pete4radio/SAMWISE-1-1-HW-Training/README.md

# SAMWISE-1-1-HW-Training
PCBs fabbed in May 2024 for SAMWISE
