pete4radio/SAMWISE-1-1-HW-Training/batteryboard-v02b/.svg2shenzhen-cache/images/F.SilkS_g35.png

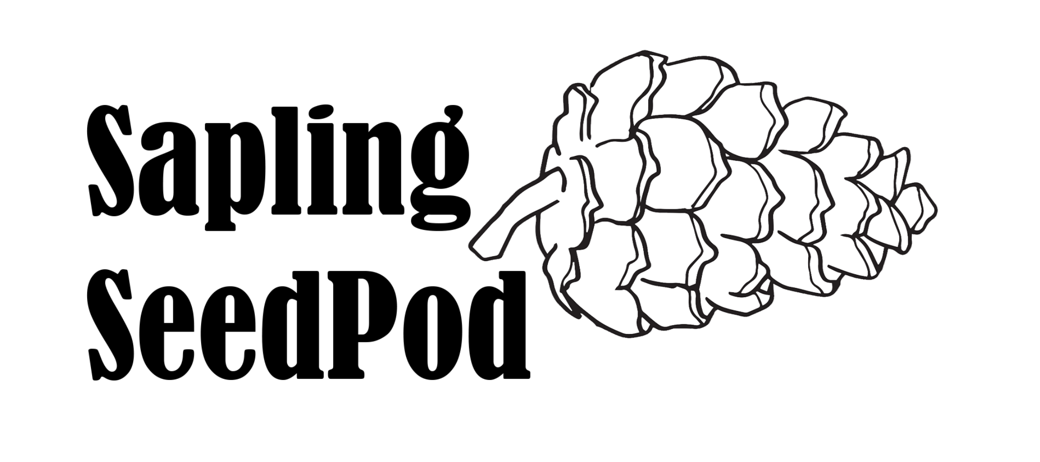
batteryboard-v02b/.svg2shenzhen-cache/images/F.SilkS_g35.png
