pete4radio/SAMWISE-1-1-HW-Training/mainboard-v06b_samwise/stackup/stackup_outer_rf.png

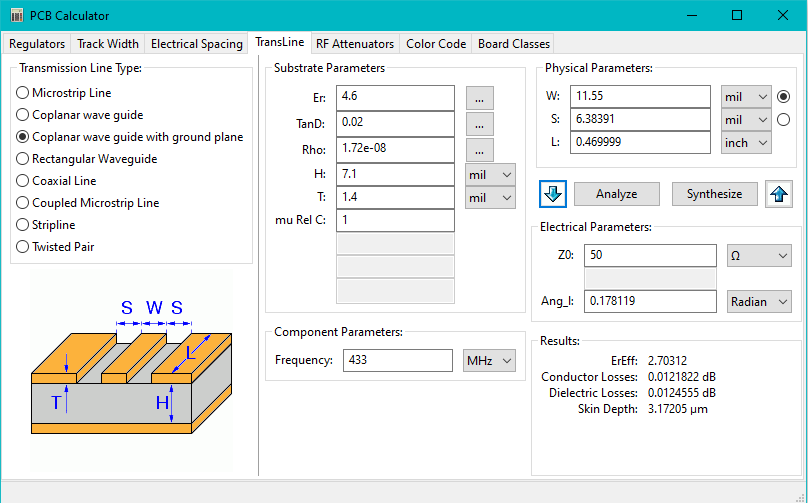
mainboard-v06b_samwise/stackup/stackup_outer_rf.png
