pete4radio/SAMWISE-1-1-HW-Training/LT8490-mezzanine/LT8490.xlsx

Refs | DNI | Datasheet | Description | Footprint | Height | Manufacturer_Name | Manufacturer_Part_Number | Mouser Part Number | Mouser Price/Stock | PN | Value | Voltage | Power | digikey part number | footprint url | height | lead free | library id | manufacturer | max junction temp | max supply voltage | min supply voltage | mouser description | mouser part number | nominal supply current | number of cells | number of outputs | package | rohs | standoff height | temperature range high | temperature range low
C15, C40 |  | ~ | 100nF 0603 | Capacitor_SMD:C_0603_1608Metric |  |  |  |  |  |  | 100nF
C16 |  | ~ |  | Capacitor_Tantalum_SMD:CP_EIA-7343-30_AVX-N |  |  | TCQD336M016R0070E |  | 581-TCQD336M016R70E | TCQD336M016R0070E | 33uF | 16V
C17 |  | ~ | 2.2uF 0603 | Capacitor_SMD:C_0603_1608Metric |  |  |  |  |  |  | 2.2uF | 10V |  | 1276-1134-1-ND
C18, C22, C25 |  | ~ | 2.2uF 0805 | Capacitor_SMD:C_0805_2012Metric |  |  |  |  |  |  | 2.2uF | 16V |  | 445-5691-1-ND
C19, C34, C39 |  | ~ | 1uF 0603 | Capacitor_SMD:C_0603_1608Metric |  |  |  |  |  |  | 1uF | 25V |  | 587-2984-1-ND
C20, C37 | DNI | ~ | 100nF 0603 | Capacitor_SMD:C_0603_1608Metric |  |  |  |  |  |  | 100nF
C21, C24, C38 |  | ~ | 4.7uF 0603 | Capacitor_SMD:C_0603_1608Metric |  |  |  |  |  |  | 4.7uF | 16V |  | 1276-1784-1-ND
C23 |  | ~ | 10nF 0603 | Capacitor_SMD:C_0603_1608Metric |  |  |  |  |  |  | 10nF | 50V |  | 445-1311-1-ND
C26, C35 |  | ~ | 470nF 0603 | Capacitor_SMD:C_0603_1608Metric |  |  |  |  |  |  | 470nF | 25V |  | 587-2670-1-ND
C27 |  | ~ | 220pF 0603 | Capacitor_SMD:C_0603_1608Metric |  |  |  |  |  |  | 220pF | 50V |  | 478-06035C221K4T2ACT-ND
C28 |  | ~ | 6.8nF 0603 | Capacitor_SMD:C_0603_1608Metric |  |  |  |  |  |  | 6.8nF | 50V |  | 1292-1459-1-ND
C29, C33 |  | ~ | 220nF 0603 | Capacitor_SMD:C_0603_1608Metric |  |  |  |  |  |  | 220nF | 25V |  | 587-1246-1-ND
C30 |  | ~ | 68nF 0603 | Capacitor_SMD:C_0603_1608Metric |  |  |  |  |  |  | 68nF | 50V |  | 1276-6541-1-ND
C31, C32 |  | ~ | 3.3nF 0603 | Capacitor_SMD:C_0603_1608Metric |  |  |  |  |  |  | 3.3nF | 50V |  | 1276-1758-1-ND
C36, C41 |  | ~ | 10uF 0805 | Capacitor_SMD:C_0805_2012Metric |  |  |  |  |  |  | 10uF | 10V |  | 587-5915-1-ND
C42 |  | ~ |  | Capacitor_Tantalum_SMD:CP_EIA-7343-30_AVX-N |  |  | TCQD476M016R0070E |  | 581-TCQD336M016R70E | TCQD336M016R0070E | 47uF | 16V
C43 |  | ~ | 1nF 0603 | Capacitor_SMD:C_0603_1608Metric |  |  |  |  |  |  | 1nF | 50V |  | 1276-1091-1-ND
D1, D2 | DNI | ~ |  | Diode_SMD:D_SOD-123F |  |  |  |  |  |  | MBR1020VL
D12, D13 |  | ~ |  | Diode_SMD:D_SOD-123F |  |  |  |  |  |  | CMMR1U-02 TR |  |  | 1514-CMMR1U-02TRPBFREECT-ND
J1-J25 | DNI | ~ |  | custom-footprints:castellated_05mm |  |  |  |  |  |  | Conn_01x01
L3 |  | ~ | 3.3uH 1770 | custom-footprints:L_SRP1770C |  |  |  |  |  |  | 3.3uH |  |  | SRP1770C-3R3MCT-ND
NT1-NT7 | DNI | ~ |  | NetTie:NetTie-2_SMD_Pad0.5mm |  |  |  |  |  |  | NetTie_2
Q1-Q4 |  |  |  | custom-footprints:SIS862DNT1GE3 |  |  | Si7106DN |  |  | 781-SI7106DN-T1-GE3 | Si7106DN
Q5 | DNI | https://www.diodes.com/assets/Datasheets/BSS138DWQ.pdf |  | custom-footprints:BSS138DWQ-7 |  | Diodes Inc. |  |  |  |  | BSS84
Q6 | DNI | http://www.onsemi.com/pub_link/Collateral/MBT2222ADW1T1-D.PDF |  | Package_TO_SOT_SMD:SOT-363_SC-70-6 |  |  | MBT2222ADW1T1 |  |  |  | MBT2222ADW1T1 |  |  | MBT2222ADW1T1GOSCT-ND
R1, R36, R37, R48 |  | ~ | 10 0603 | Resistor_SMD:R_0603_1608Metric |  |  |  |  |  |  | 10 |  | 0.1W | RMCF0603FT10R0CT-ND
R17 |  | ~ | 86.6K 0603 | Resistor_SMD:R_0603_1608Metric |  |  |  |  |  |  | 86.6K |  | 0.1W | RMCF0603FT86K6CT-ND
R18 |  | ~ | 16.5K 0603 | Resistor_SMD:R_0603_1608Metric |  |  |  |  |  |  | 16.5K |  | 0.1W | RMCF0603FT16K5CT-ND
R19, R26 |  | ~ | 124K 0603 | Resistor_SMD:R_0603_1608Metric |  |  |  |  |  |  | 124K |  | 0.1W | RMCF0603FT124KCT-ND
R2-R4, R29, R42, R44, R50 |  | ~ | 0 0603 | Resistor_SMD:R_0603_1608Metric |  |  |  |  |  |  | 0 |  | 0.1W
R20 |  | ~ | 196K 0603 | Resistor_SMD:R_0603_1608Metric |  |  |  |  |  |  | 196K |  | 0.1W | RMCF0603FT196KCT-ND
R21 |  | ~ | 8.06K 0603 | Resistor_SMD:R_0603_1608Metric |  |  |  |  |  |  | 8.06K |  | 0.1W | RMCF0603FT8K06CT-ND
R22, R30 |  | ~ | 21K 0603 | Resistor_SMD:R_0603_1608Metric |  |  |  |  |  |  | 21K |  | 0.1W | RMCF0603FT21K0CT-ND
R23 |  | ~ | 110K 0603 | Resistor_SMD:R_0603_1608Metric |  |  |  |  |  |  | 110K |  | 0.1W | RMCF0603FT110KCT-ND
R24 |  | ~ | 35.7K 0603 | Resistor_SMD:R_0603_1608Metric |  |  |  |  |  |  | 35.7K |  | 0.1W | RMCF0603FT35K7CT-ND
R25 | DNI | ~ | 30.1K 0603 | Resistor_SMD:R_0603_1608Metric |  |  |  |  |  |  | 30.1K |  | 0.1W | RMCF0603FG30K1CT-ND
R27 |  | ~ | 0.025 1206 | Resistor_SMD:R_1206_3216Metric |  |  |  |  |  |  | 0.025 |  | 0.1W | MCS1632R025FERCT-ND
R28 |  | ~ | 105K 0603 | Resistor_SMD:R_0603_1608Metric |  |  |  |  |  |  | 105K |  | 0.1W | RMCF0603FT105KCT-ND
R31 |  | ~ | 3.01K 0603 | Resistor_SMD:R_0603_1608Metric |  |  |  |  |  |  | 3.01K |  | 0.1W | RMCF0603FT3K01CT-ND
R32, R39 |  | ~ | 2 0603 | Resistor_SMD:R_0603_1608Metric |  |  |  |  |  |  | 2 |  | 0.1W | 2019-RK73H1JTTD2R00FCT-ND
R33 |  | ~ | 4.99K 0603 | Resistor_SMD:R_0603_1608Metric |  |  |  |  |  |  | 4.99K |  | 0.1W | RMCF0603FT4K99CT-ND
R34 |  | ~ | 53.6K 0603 | Resistor_SMD:R_0603_1608Metric |  |  |  |  |  |  | 53.6K |  | 0.1W | RMCF0603FT53K6CT-ND
R38 |  | ~ | 0.001 1206 | Resistor_SMD:R_1206_3216Metric |  |  |  |  |  |  | 0.001 |  | 1W | 273-PCS1206FR0010ETCT-ND
R40 |  | ~ | 200K 0603 | Resistor_SMD:R_0603_1608Metric |  |  |  |  |  |  | 200K |  | 0.1W | RMCF0603FT200KCT-ND
R41 |  | ~ | 1 0603 | Resistor_SMD:R_0603_1608Metric |  |  |  |  |  |  | 1 |  | 0.1W | RMCF0603FT1R00CT-ND
R43 |  | ~ | 23.2K 0603 | Resistor_SMD:R_0603_1608Metric |  |  |  |  |  |  | 23.2K |  | 0.1W | RMCF0603FT23K2CT-ND
R45 |  | ~ | 11.5K 0603 | Resistor_SMD:R_0603_1608Metric |  |  |  |  |  |  | 11.5K |  | 0.1W | P11.5KHCT-ND
R46 |  | ~ | 0.05 1206 | Resistor_SMD:R_1206_3216Metric |  |  |  |  |  |  | 0.05 |  | 1W | MCS1632R050FERCT-ND
R47 |  | ~ | 10K 0603 | Resistor_SMD:R_0603_1608Metric |  |  |  |  |  |  | 10K |  | 0.1W
R49 |  | ~ | 121K 0603 | Resistor_SMD:R_0603_1608Metric |  |  |  |  |  |  | 121K |  | 0.1W | RMCF0603FT121KCT-ND
R51 |  | ~ | 154K 0603 | Resistor_SMD:R_0603_1608Metric |  |  |  |  |  |  | 154K |  | 0.1W | RMCF0603FT154KCT-ND
R52 |  | ~ | 23.7K 0603 | Resistor_SMD:R_0603_1608Metric |  |  |  |  |  |  | 23.7K |  | 0.1W | RMCF0603FT23K7CT-ND
R53, R56-R58 | DNI | ~ | ??? 0603 | Resistor_SMD:R_0603_1608Metric |  |  |  |  |  |  | ??? |  | 0.1W
R54 | DNI | ~ | 200K 0603 | Resistor_SMD:R_0603_1608Metric |  |  |  |  |  |  | 200K |  | 0.1W
R55 | DNI | ~ | 10 0603 | Resistor_SMD:R_0603_1608Metric |  |  |  |  |  |  | 10 |  | 0.1W
U4 |  | https://www.analog.com/media/en/technical-documentation/data-sheets/8490fa.pdf | LT8490EUKJPBF 8490 | custom-footprints:LT8490EUKJ#PBF |  | Analog Devices |  |  |  |  | LT8490EUKJPBF
