pete4radio/SAMWISE-1-1-HW-Training/RPI Feather Adapter/kfw_rpi_adapter.csv

Id | Designator | Footprint | Quantity | Designation | Supplier and ref
1 | U1 | TSSOP-10_3x3mm_P0.5mm | 1 | ADS1115IDGS
2 | JP1 | SolderJumper-3_P1.3mm_Bridged12_RoundedPad1.0x1.5mm_NumberLabels | 1 | SJ_STM_KBD
3 | J5,J1 | PinHeader_2x20_P2.54mm_Vertical | 2 | Conn_RPi
4 | REF**,REF** | Fiducial_0.5mm_Mask1.5mm | 2 | Fiducial_0.5mm_Mask1.5mm
5 | J4 | PinHeader_2x04_P2.54mm_Vertical | 1 | Conn_02x04_Odd_Even
6 | J2 | PinHeader_2x16_P2.54mm_Vertical | 1 | Conn_Left
7 | J3 | PinHeader_2x12_P2.54mm_Vertical | 1 | Conn_Right
8 | C1 | C_0603_1608Metric | 1 | 0.1uF
