pete4radio/SAMWISE-1-1-HW-Training/3D_models/batteryboard/keystone-PN1042.STEP

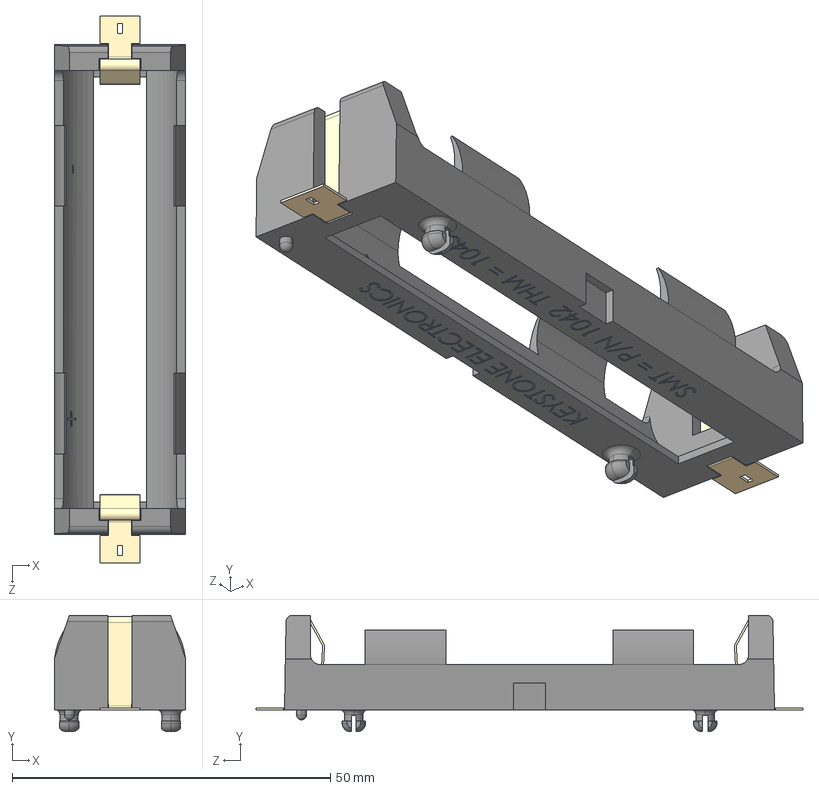
[picture p6: CAD file, 2024-05-09]
3D_models/batteryboard/keystone-PN1042.STEP
20.7 x 18.3 x 86.0 mm
