pete4radio/SAMWISE-1-1-HW-Training/3D_models/mainboard/DFLS130L.step

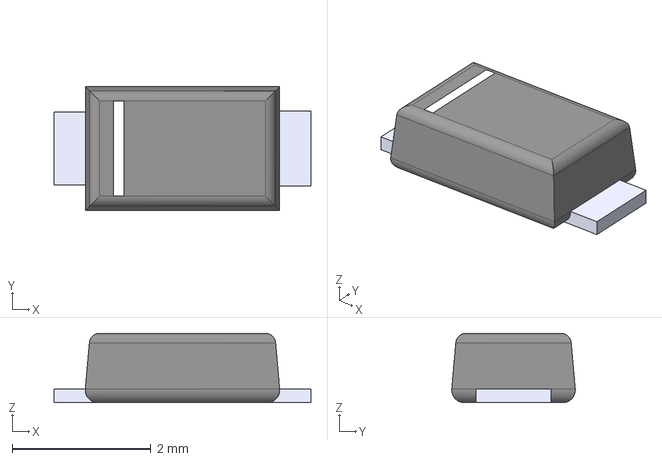
[picture p7: CAD file, 2024-05-09]
3D_models/mainboard/DFLS130L.step
3.70 x 1.78 x 1.00 mm
