pete4radio/SAMWISE-1-1-HW-Training/3D_models/panels/OPT3001DNPT.step

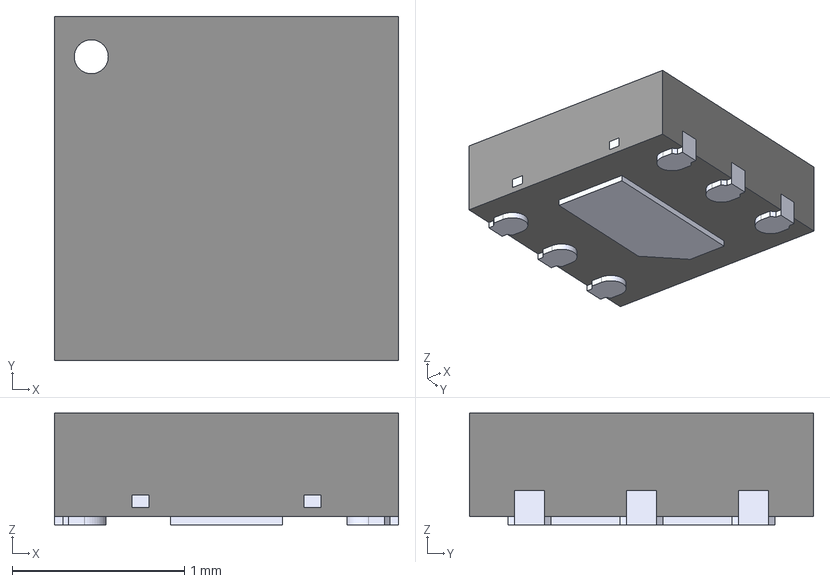
[picture p8: CAD file, 2024-05-09]
3D_models/panels/OPT3001DNPT.step
2.00 x 2.00 x 0.65 mm
