pete4radio/SAMWISE-1-1-HW-Training/3D_models/rpi_interface/PRT-16764.step

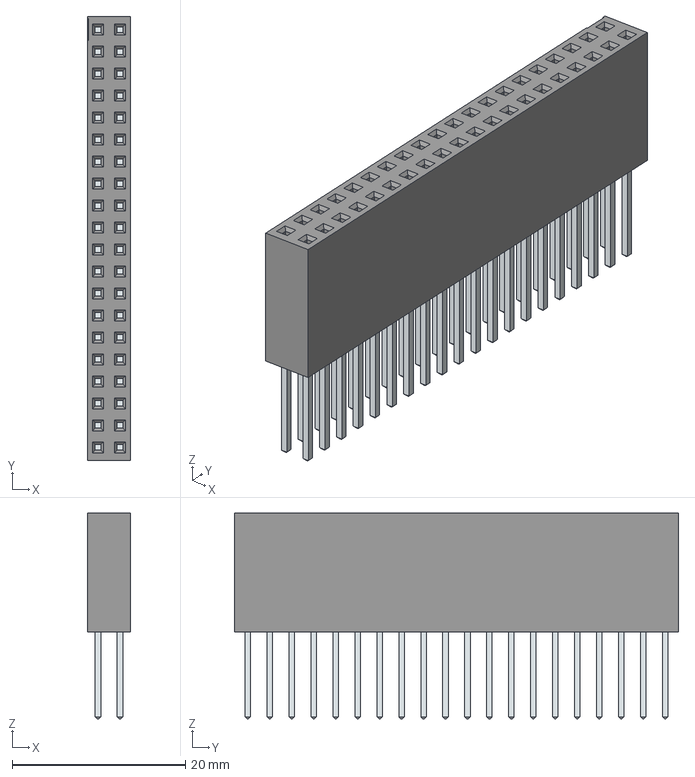
[picture p9: CAD file, 2024-05-09]
3D_models/rpi_interface/PRT-16764.step
5.00 x 51.3 x 23.8 mm
LeadsArray
