pete4radio/SAMWISE-1-1-HW-Training/LT8490-mezzanine/LT8490.step

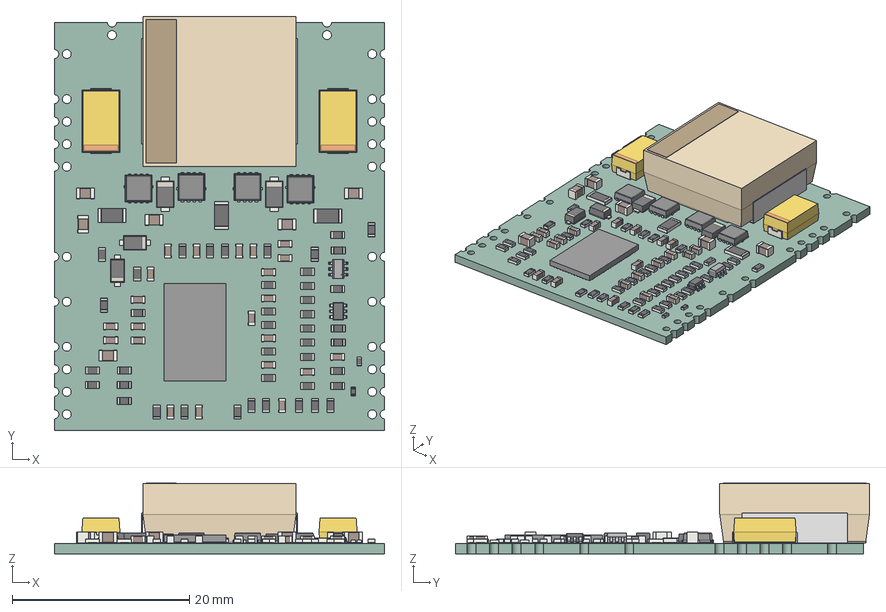
[picture p10: CAD file, 2024-05-09]
LT8490-mezzanine/LT8490.step
37.2 x 46.7 x 8.00 mm
LT8490 PCB
