pete4radio/SAMWISE-1-1-HW-Training/New_universal_XY_MagTorq/New_XY_universal_coil .STEP

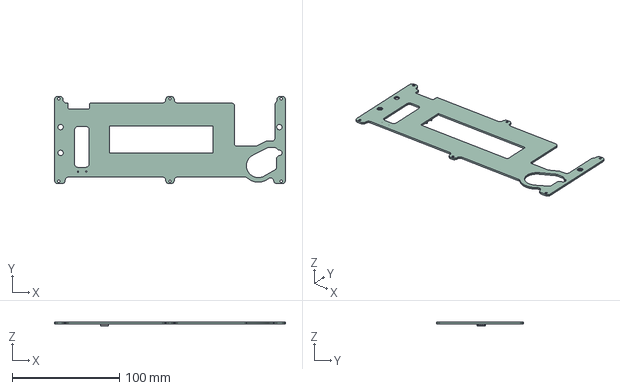
[picture p11: CAD file, 2024-05-09]
New_universal_XY_MagTorq/New_XY_universal_coil .STEP
215.5 x 81.5 x 3.49 mm
_autosave-New_Coil_Panel_Y PCB
