pete4radio/SAMWISE-1-1-HW-Training/Z_Panels/Z_Panels.step

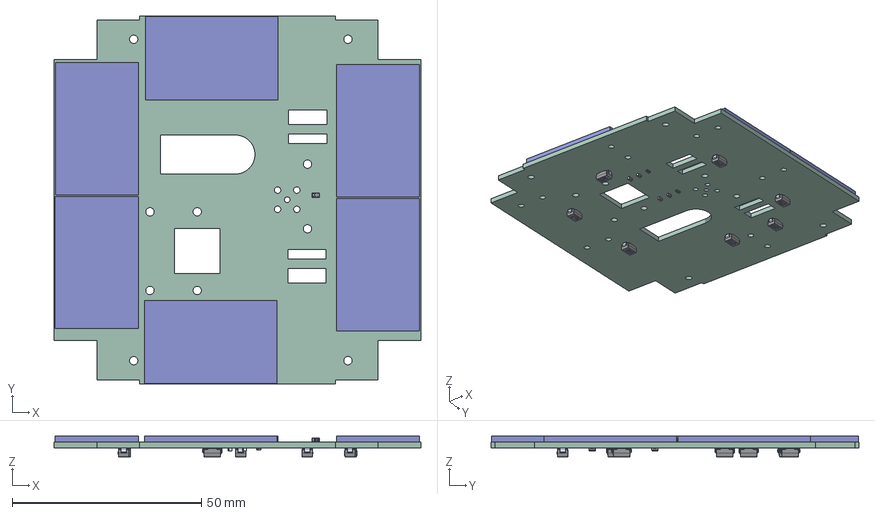
[picture p12: CAD file, 2024-05-09]
Z_Panels/Z_Panels.step
97.0 x 97.3 x 5.51 mm
SM101K07TF v3 x 6
(Unsaved) x 8
C_0603_1608Metric x 4
R_0603_1608Metric x 2
Z_Panels PCB
