pete4radio/SAMWISE-1-1-HW-Training/3D_models/mainboard/MR25H40MDF.step

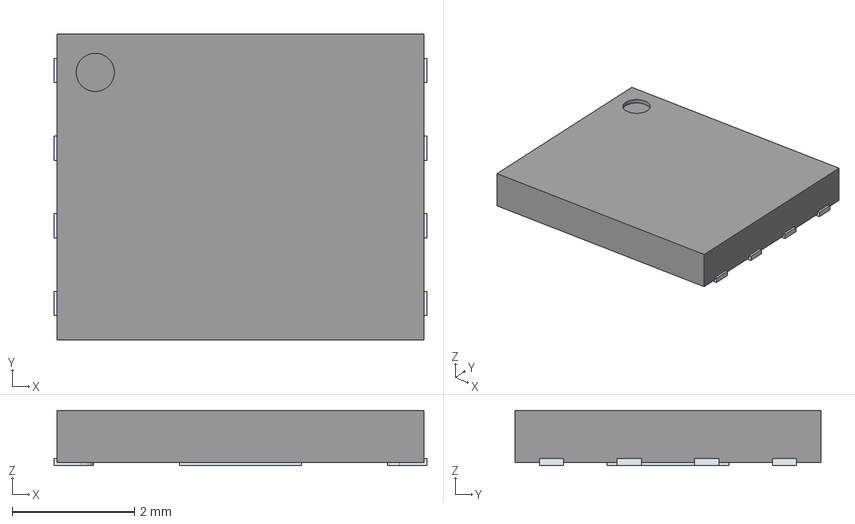
[picture p13: CAD file, 2024-05-09]
3D_models/mainboard/MR25H40MDF.step
6.10 x 5.00 x 0.9 mm
ThermalPin
PinsArrayLR
