pete4radio/SAMWISE-1-1-HW-Training/3D_models/panels/HHM1589D1.step

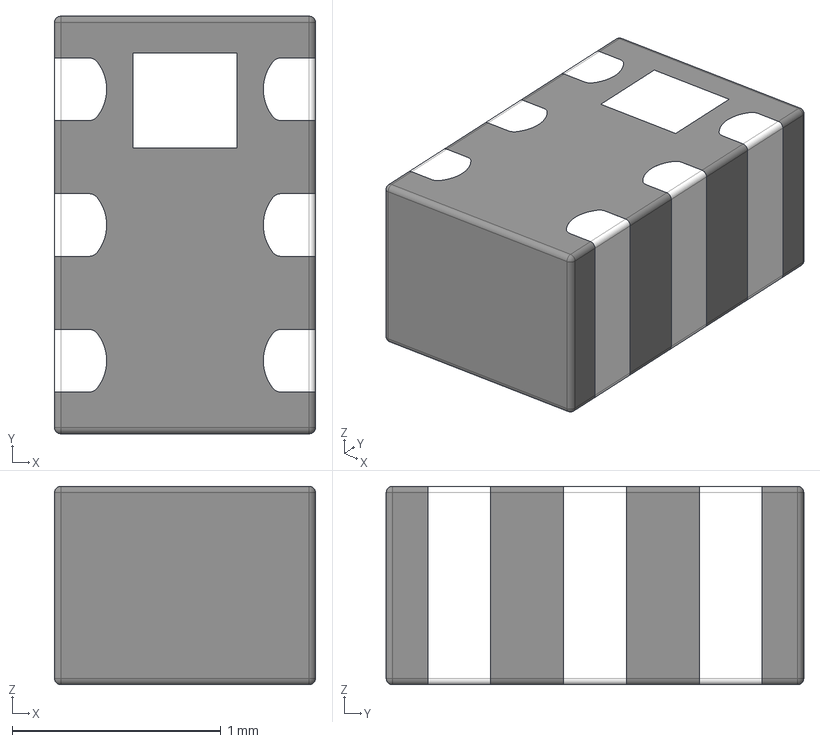
[picture p14: CAD file, 2024-05-09]
3D_models/panels/HHM1589D1.step
1.25 x 2.00 x 0.95 mm
