pete4radio/SAMWISE-1-1-HW-Training/3D_models/rpi_interface/PRT-21570.step

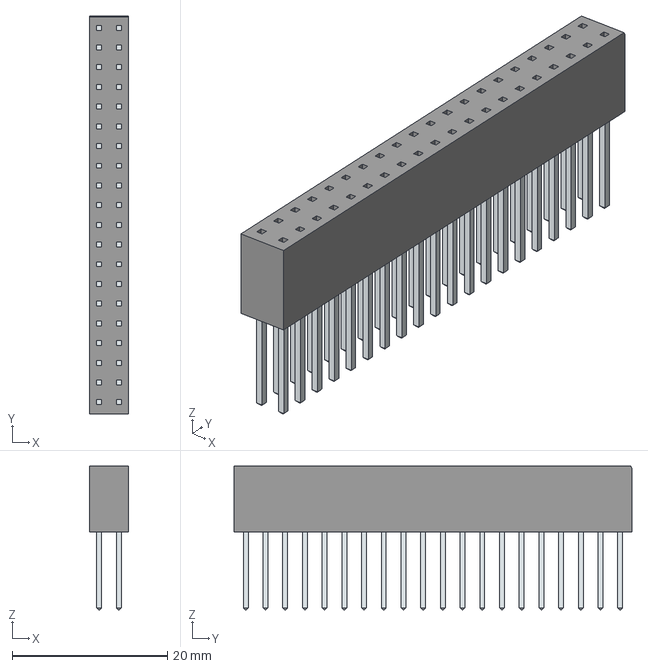
[picture p15: CAD file, 2024-05-09]
3D_models/rpi_interface/PRT-21570.step
5.00 x 51.3 x 18.5 mm
LeadsArray
