pete4radio/SAMWISE-1-1-HW-Training/3D_models/mainboard/PWP0014E.step

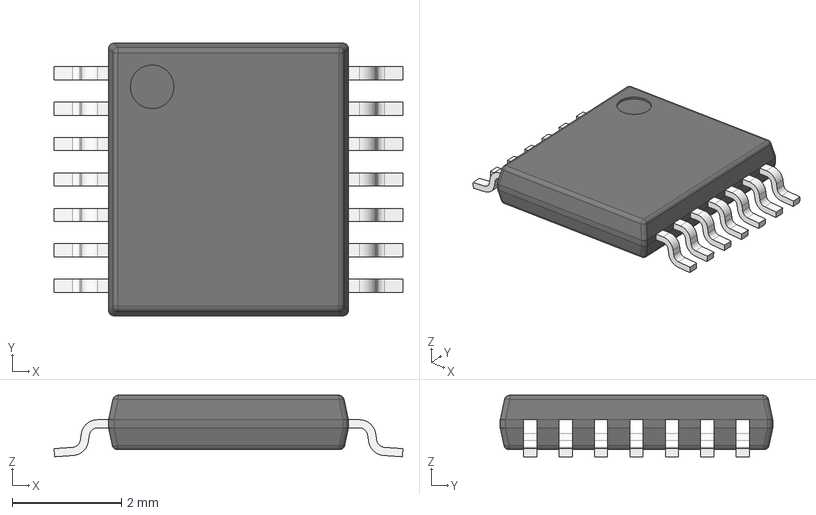
[picture p16: CAD file, 2024-05-09]
3D_models/mainboard/PWP0014E.step
6.40 x 5.00 x 1.13 mm
BODY-TSSOP
LEAD-TSSOP x 14
DAP
