pete4radio/SAMWISE-1-1-HW-Training/3D_models/panels/AP.12F.07.0045A_Web v4.step

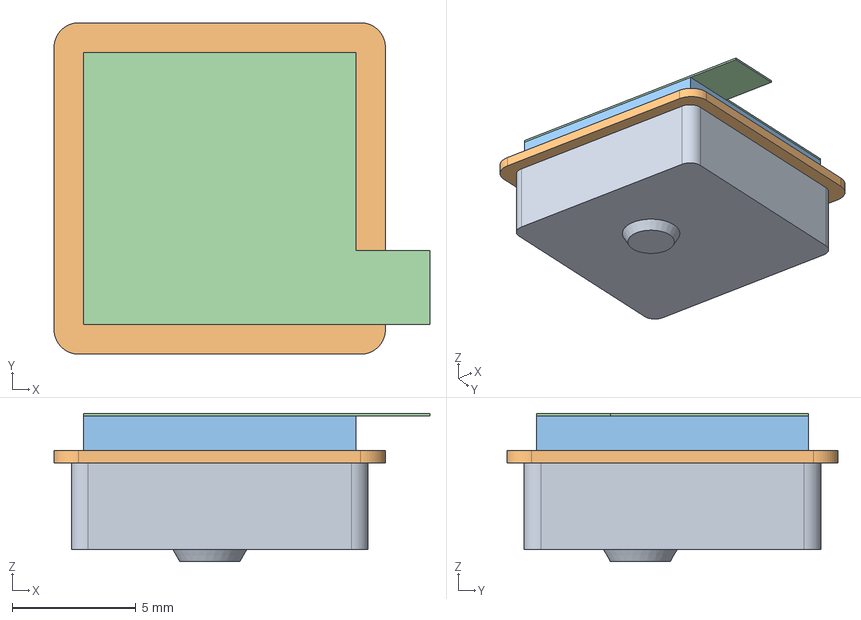
[picture p17: CAD file, 2024-05-09]
3D_models/panels/AP.12F.07.0045A_Web v4.step
15.2 x 13.4 x 6.00 mm
AP 12F Patch
AP 12F PCB
AP 12F Shielding Case
¹s¥ó14^AP 12F
