pete4radio/SAMWISE-1-1-HW-Training/3D_models/rpi_interface/901-144.step

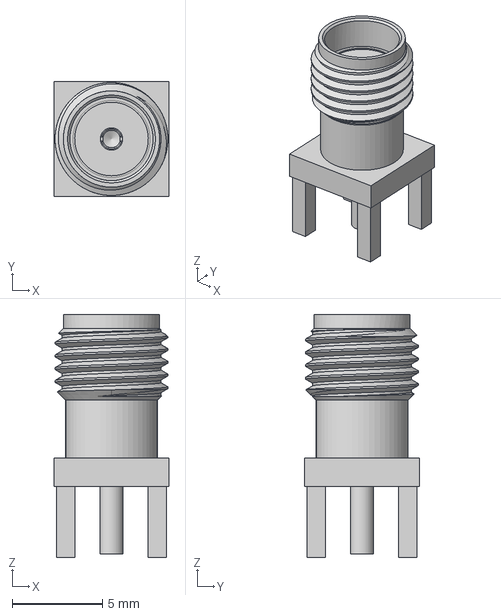
[picture p18: CAD file, 2024-05-09]
3D_models/rpi_interface/901-144.step
6.35 x 6.35 x 13.5 mm
