pete4radio/SAMWISE-1-1-HW-Training/3D_models/mainboard/32K201-400L5.step

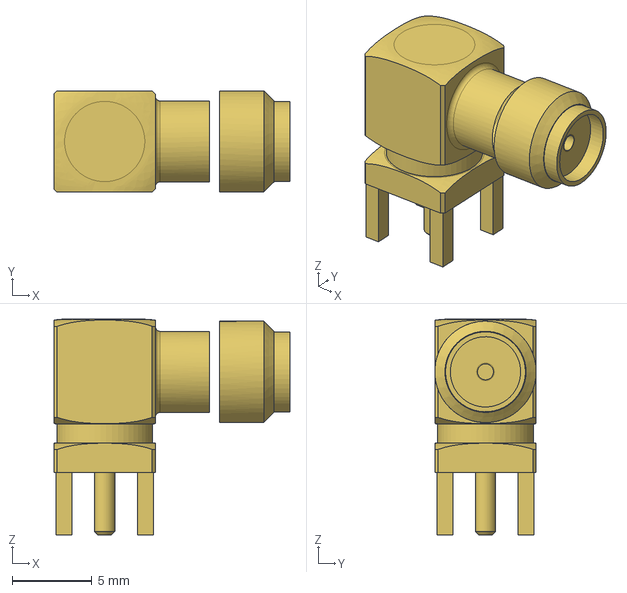
[picture p19: CAD file, 2024-05-09]
3D_models/mainboard/32K201-400L5.step
14.8 x 6.35 x 13.5 mm
