pete4radio/SAMWISE-1-1-HW-Training/3D_models/panels/SMA (DO-214AC).STEP

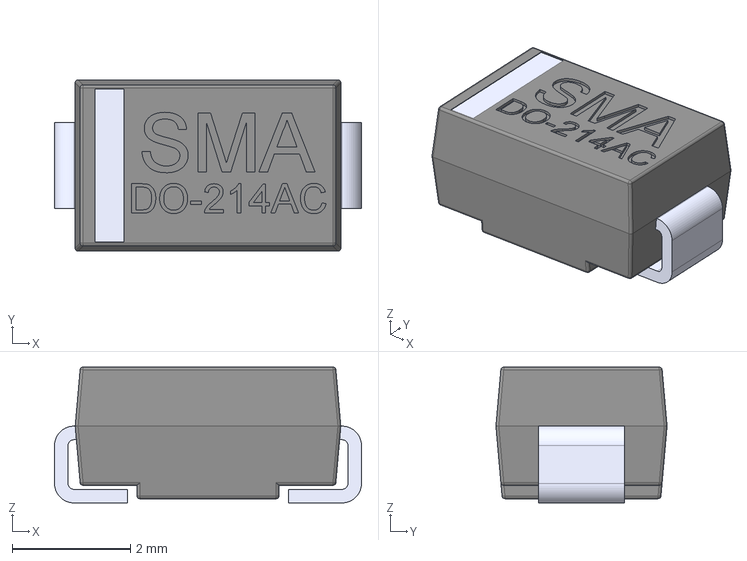
[picture p20: CAD file, 2024-05-09]
3D_models/panels/SMA (DO-214AC).STEP
5.20 x 2.90 x 2.30 mm
