pete4radio/SAMWISE-1-1-HW-Training/3D_models/mainboard/TPS7A4501DCQT.step

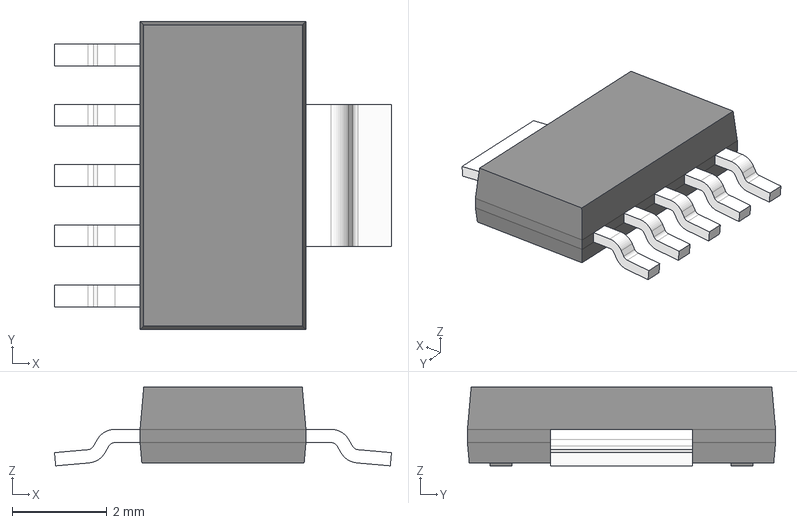
[picture p21: CAD file, 2024-05-09]
3D_models/mainboard/TPS7A4501DCQT.step
7.11 x 6.50 x 1.66 mm
LEAD x 5
LEAD_WIDE
