pete4radio/SAMWISE-1-1-HW-Training/3D_models/panels/SM101K07TF v3.step

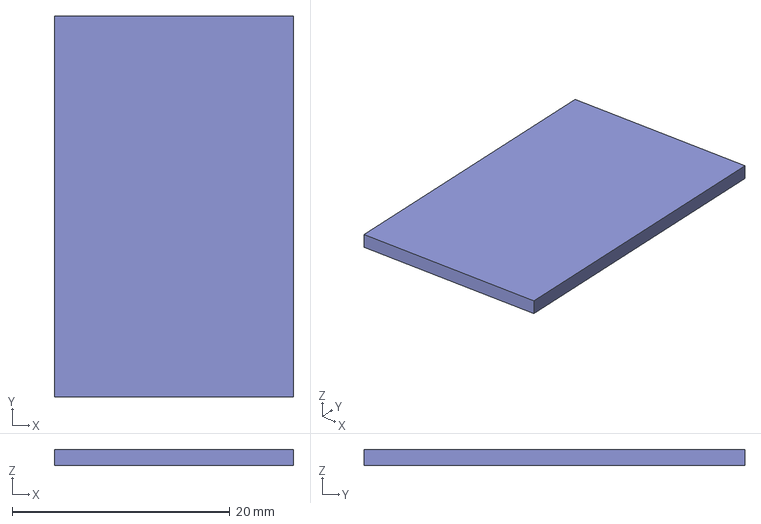
[picture p22: CAD file, 2024-05-09]
3D_models/panels/SM101K07TF v3.step
22.0 x 35.0 x 1.50 mm
