pete4radio/SAMWISE-1-1-HW-Training/3D_models/mainboard/EP2W.step

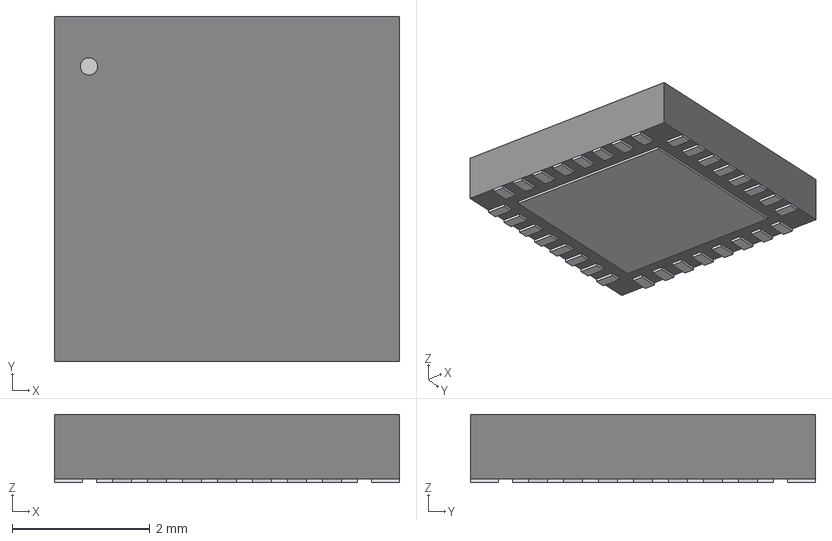
[picture p23: CAD file, 2024-05-09]
3D_models/mainboard/EP2W.step
5.00 x 5.00 x 0.993 mm
