pete4radio/SAMWISE-1-1-HW-Training/3D_models/panels/AP.12F.07.0045A_Web.STEP

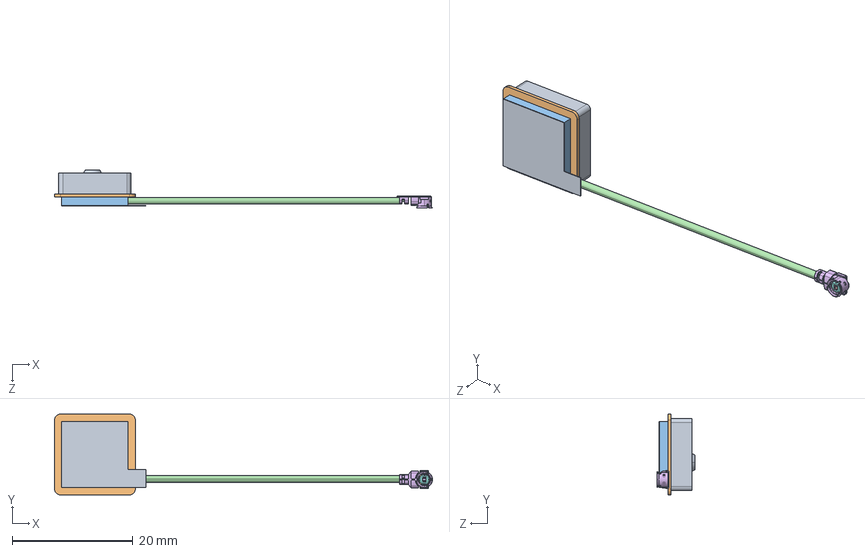
[picture p24: CAD file, 2024-05-09]
3D_models/panels/AP.12F.07.0045A_Web.STEP
62.7 x 13.4 x 6.30 mm
AP 12F Patch
AP 12F PCB
AP 12F Shielding Case
AP 12F 113 Cable
p6
p7
p4
p3
p8
零件14^AP 12F
