pete4radio/SAMWISE-1-1-HW-Training/3D_models/mainboard/CDBA-HF.step

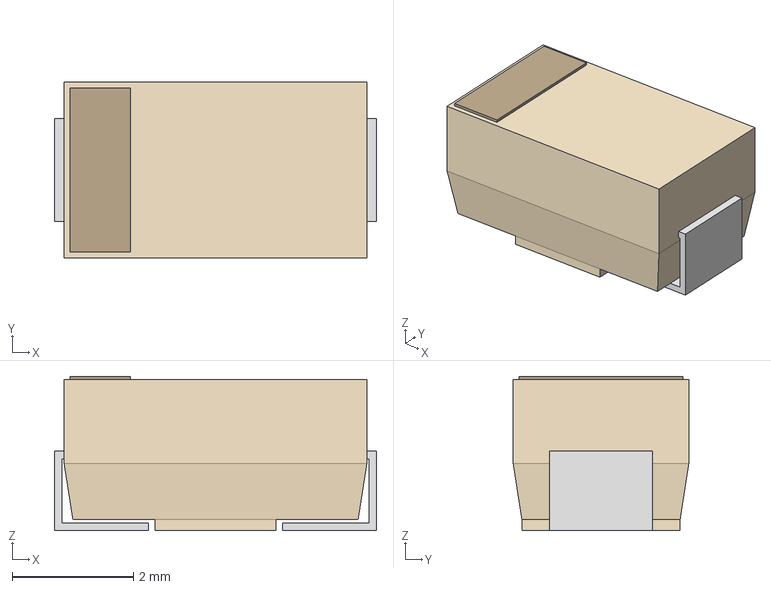
[picture p25: CAD file, 2024-05-09]
3D_models/mainboard/CDBA-HF.step
5.31 x 2.90 x 2.54 mm
