pete4radio/SAMWISE-1-1-HW-Training/3D_models/panels/BSS138DWQ-7.step

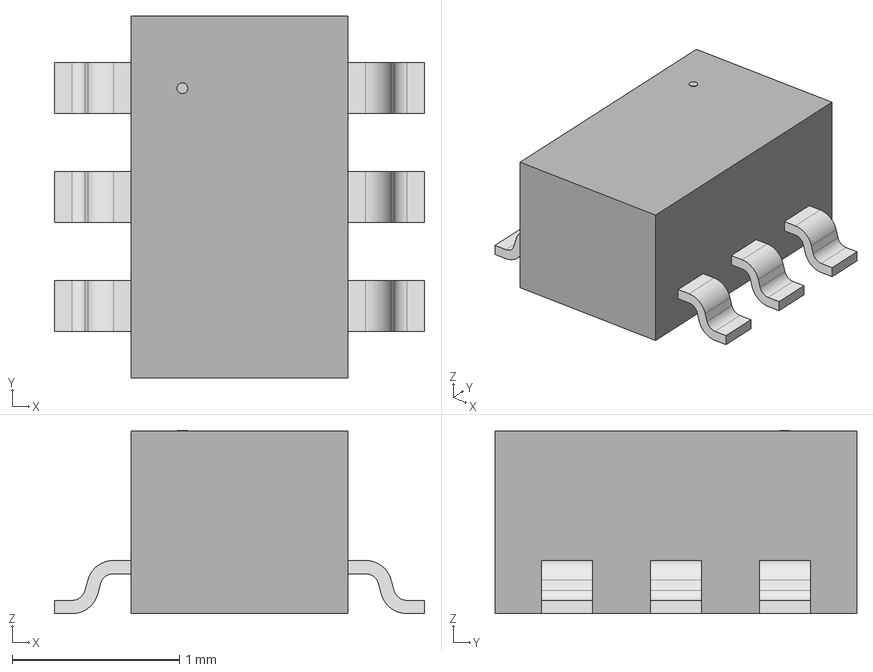
[picture p26: CAD file, 2024-05-09]
3D_models/panels/BSS138DWQ-7.step
2.21 x 2.16 x 1.09 mm
