pete4radio/SAMWISE-1-1-HW-Training/3D_models/mainboard/SDO_CMSH2-40MTR13PBFREE_CNS.step

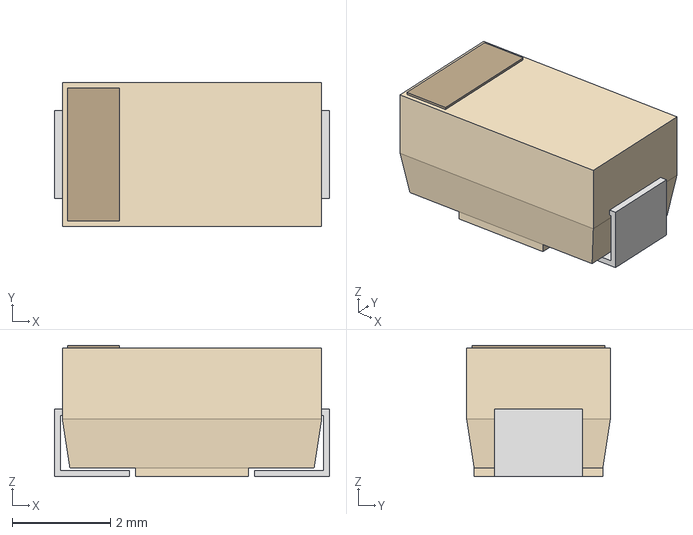
[picture p27: CAD file, 2024-05-09]
3D_models/mainboard/SDO_CMSH2-40MTR13PBFREE_CNS.step
5.59 x 2.92 x 2.67 mm
