pete4radio/SAMWISE-1-1-HW-Training/3D_models/mainboard/KMR221GLFS.step

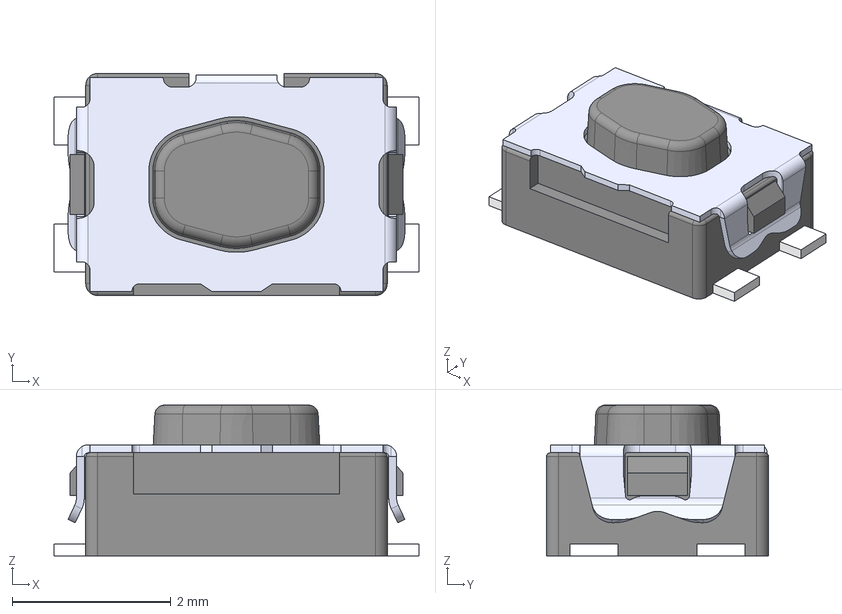
[picture p28: CAD file, 2024-05-09]
3D_models/mainboard/KMR221GLFS.step
4.60 x 2.80 x 1.90 mm
