pete4radio/SAMWISE-1-1-HW-Training/3D_models/panels/DRV8830DGQ.STEP

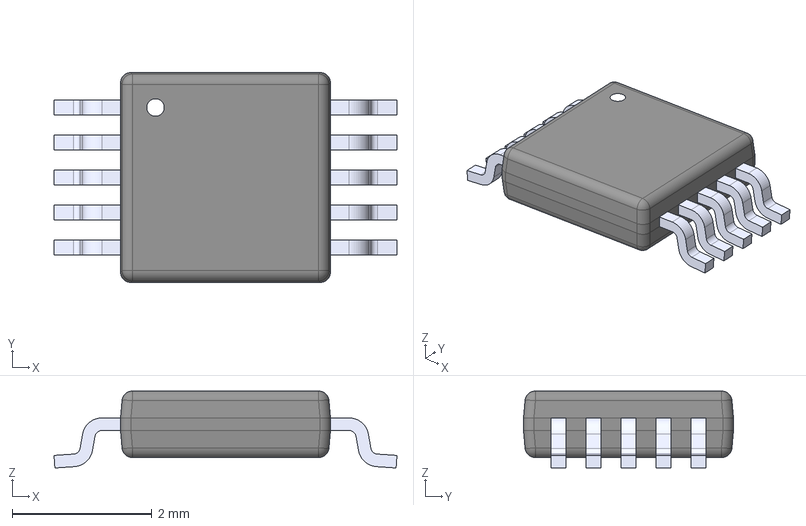
[picture p29: CAD file, 2024-05-09]
3D_models/panels/DRV8830DGQ.STEP
4.90 x 3.00 x 1.10 mm
