pete4radio/SAMWISE-1-1-HW-Training/3D_models/mainboard/MSOP-12_MSE_LIT.step

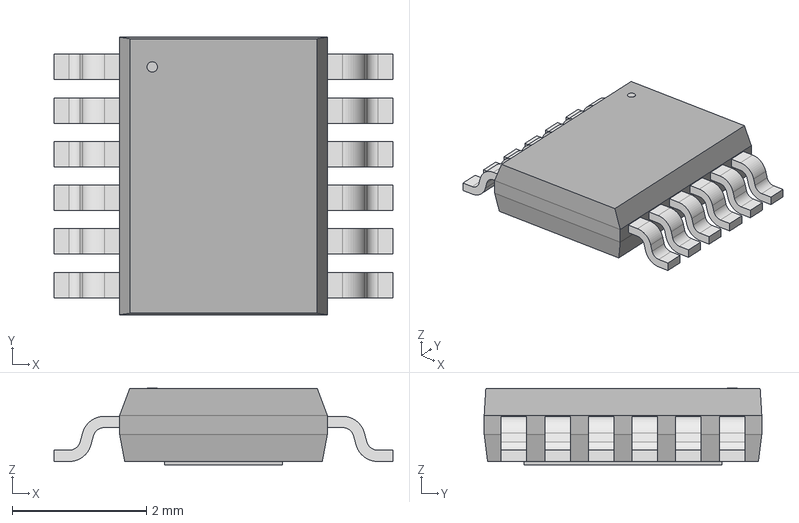
[picture p30: CAD file, 2024-05-09]
3D_models/mainboard/MSOP-12_MSE_LIT.step
5.05 x 4.14 x 1.15 mm
