pete4radio/SAMWISE-1-1-HW-Training/3D_models/mainboard/ADM1176-1ARMZ-R7.step

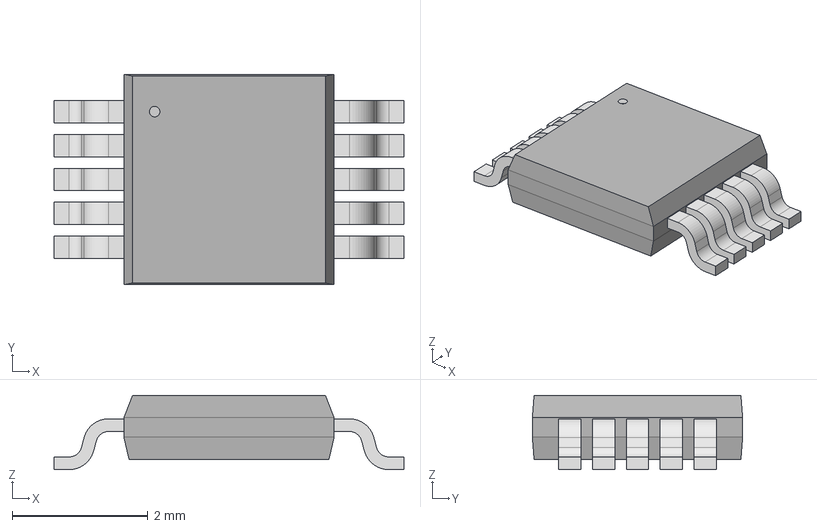
[picture p31: CAD file, 2024-05-09]
3D_models/mainboard/ADM1176-1ARMZ-R7.step
5.16 x 3.10 x 1.09 mm
