pete4radio/SAMWISE-1-1-HW-Training/3D_models/mainboard/DX07S016JA1R1500.step

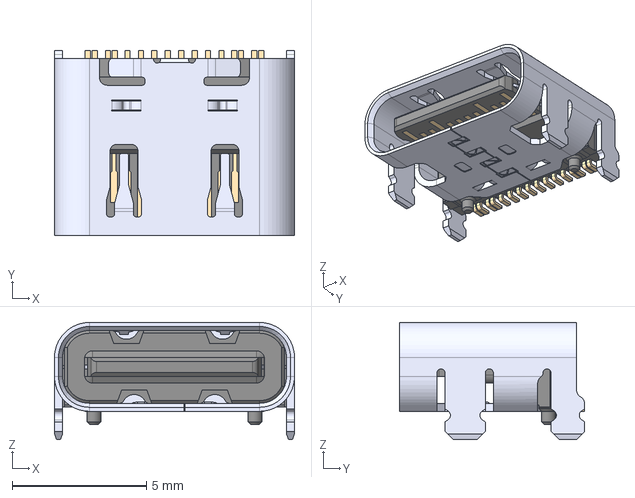
[picture p32: CAD file, 2024-05-09]
3D_models/mainboard/DX07S016JA1R1500.step
8.94 x 6.90 x 4.36 mm
