pete4radio/SAMWISE-1-1-HW-Training/3D_models/mainboard/ATSAMD51J20A-AU.step

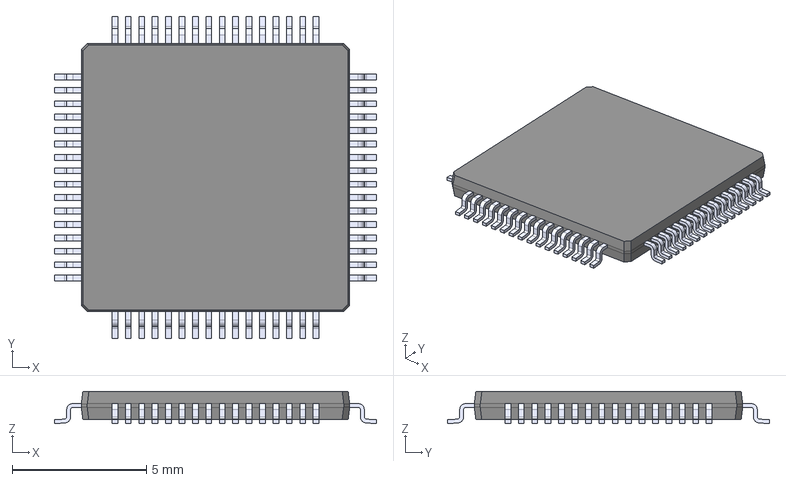
[picture p33: CAD file, 2024-05-09]
3D_models/mainboard/ATSAMD51J20A-AU.step
12.0 x 12.0 x 1.20 mm
