pete4radio/SAMWISE-1-1-HW-Training/(list of files, cad)

Other CAD files:
3D_models/mainboard/SOT363_1P3X2P15_DIO.step
3D_models/batteryboard/18650 battery.STEP
3D_models/batteryboard/1985807.step
3D_models/batteryboard/5023520600.step
3D_models/mainboard/1985807.step
3D_models/mainboard/35362-0650.step
3D_models/mainboard/35362-0850.step
3D_models/mainboard/503182-1852.step
3D_models/mainboard/PE014006.step
3D_models/panels/2053380002.step
3D_models/panels/2053380006.step
3D_models/panels/AP.12F.07.0045A_Web v2.step
3D_models/panels/AP.12F.07.0045A_Web v3.step
