pete4radio/SAMWISE-1-1-HW-Training/mainboard-v06b_samwise/Pycubed_v06b.pdf

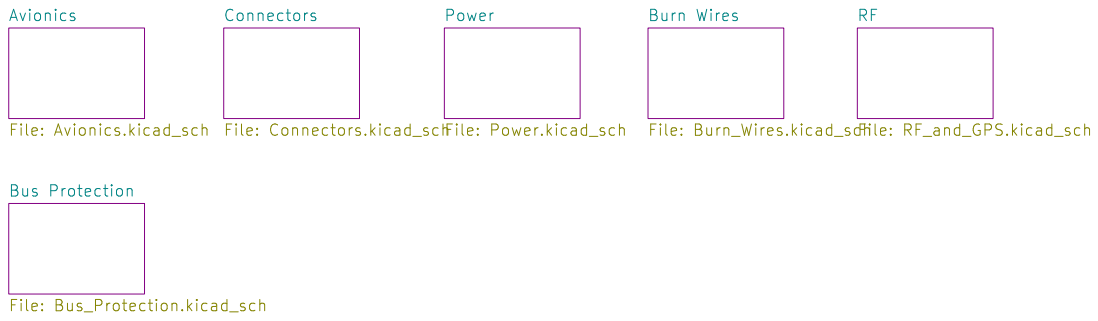
[picture p34: page 1]

Id: 1/7 Title: PyCubed Mainboard

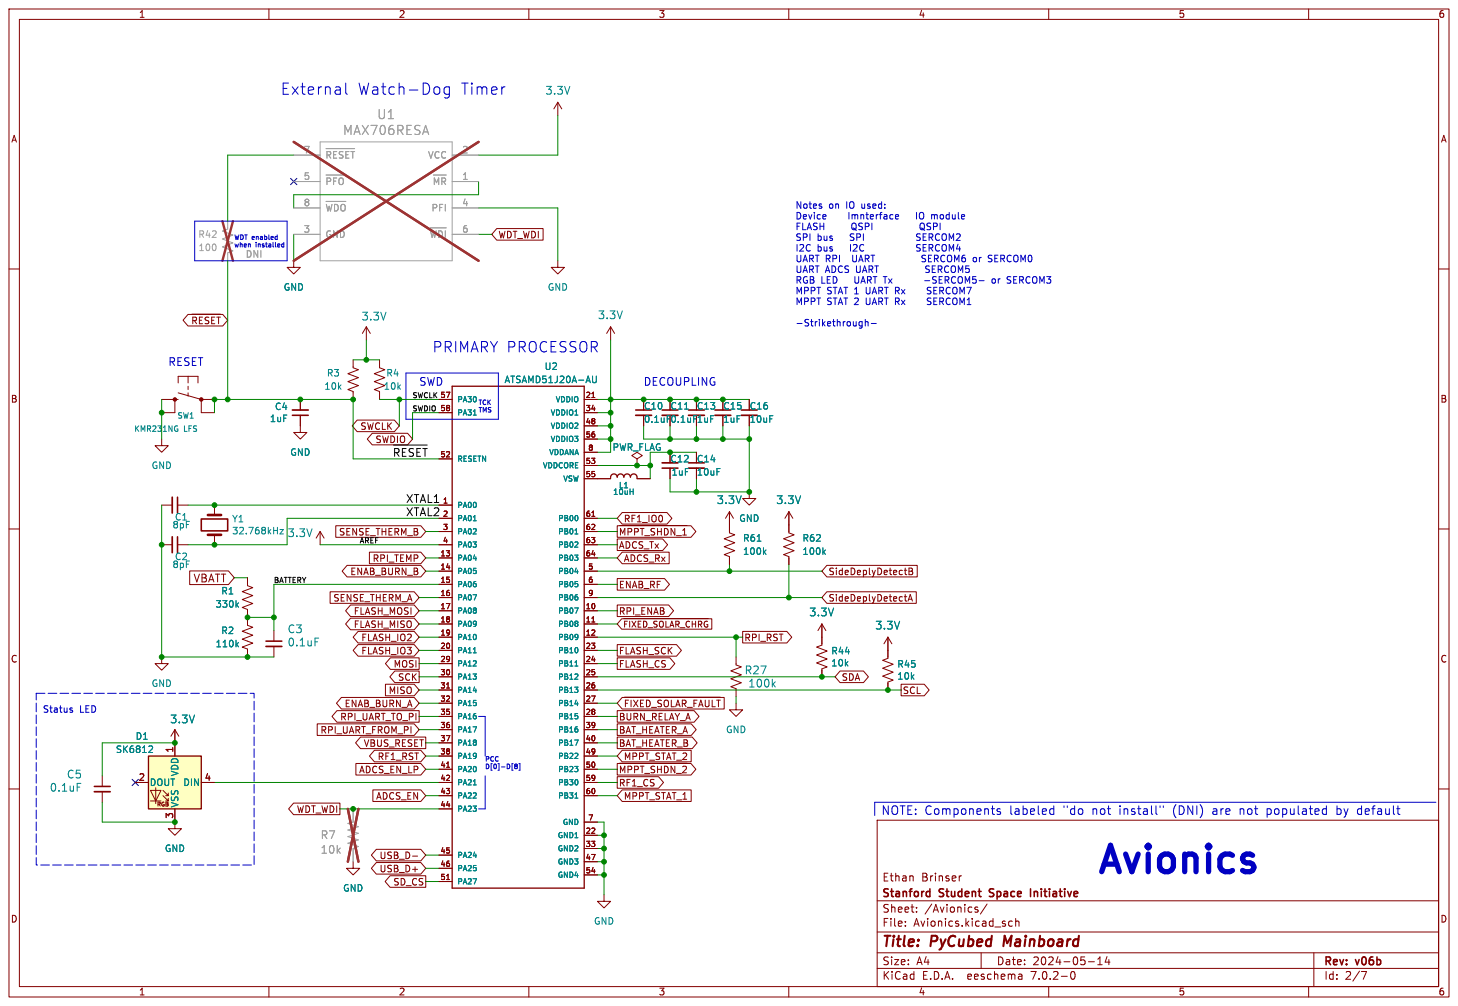
[picture p35: page 2]

Id: 2/7 Title: PyCubed Mainboard

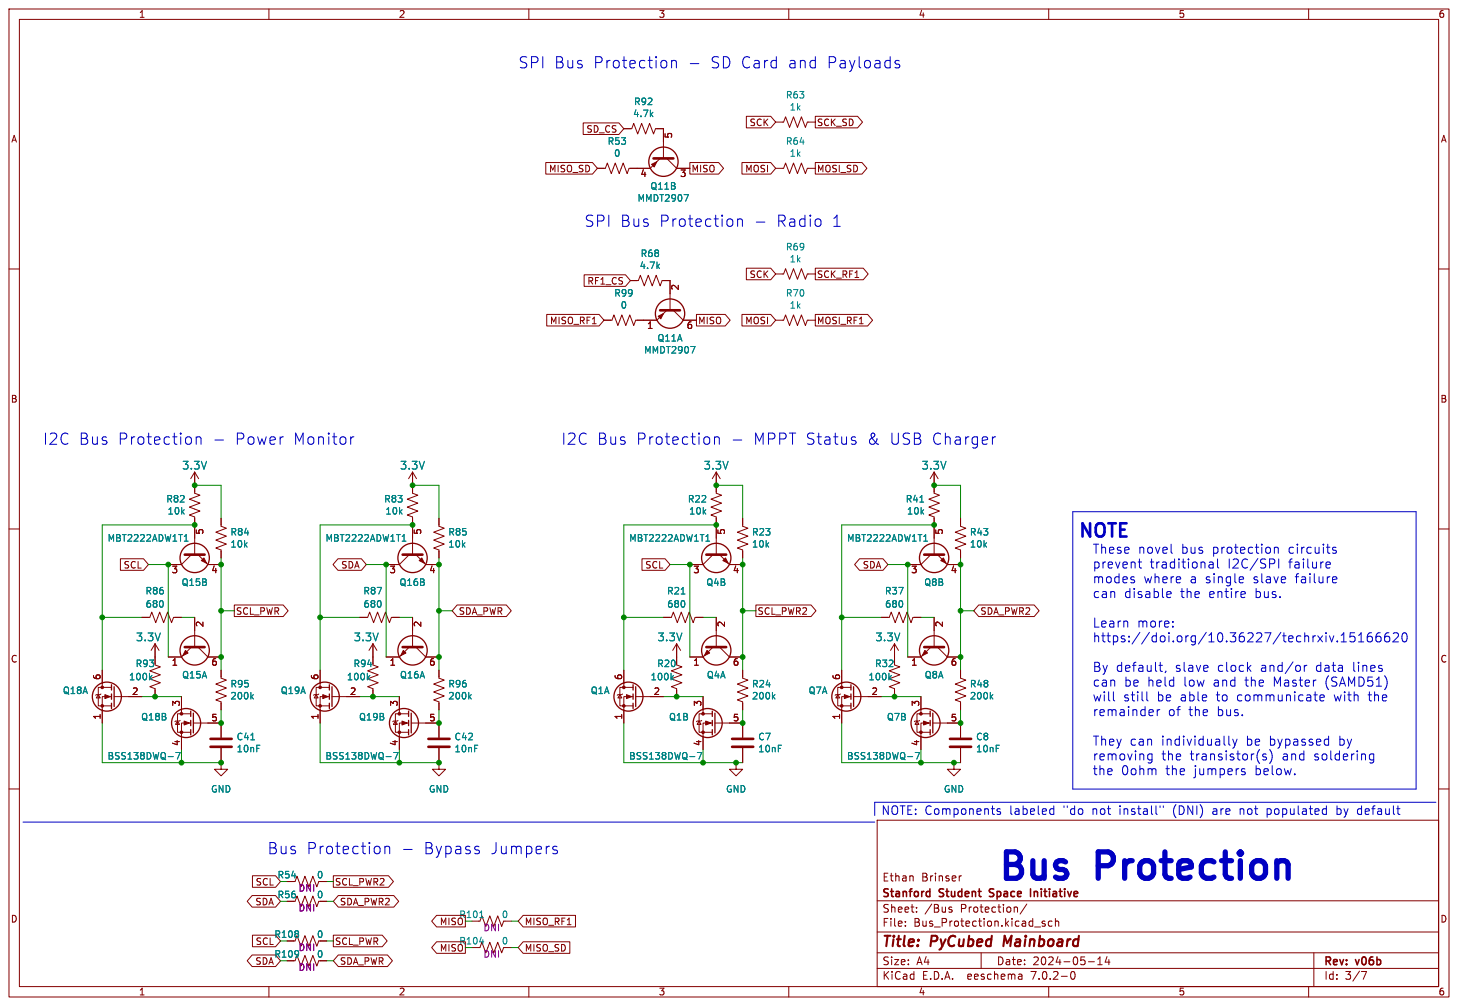
[picture p36: page 3]

NOTE
modes where a single slave failure
can disable the entire bus.

the 0ohm the jumpers below. R85

Learn more: https://doi.org/10.36227/techrxiv.15166620

can be held low and the Master (SAMD51)

Id: 3/7 Title: PyCubed Mainboard

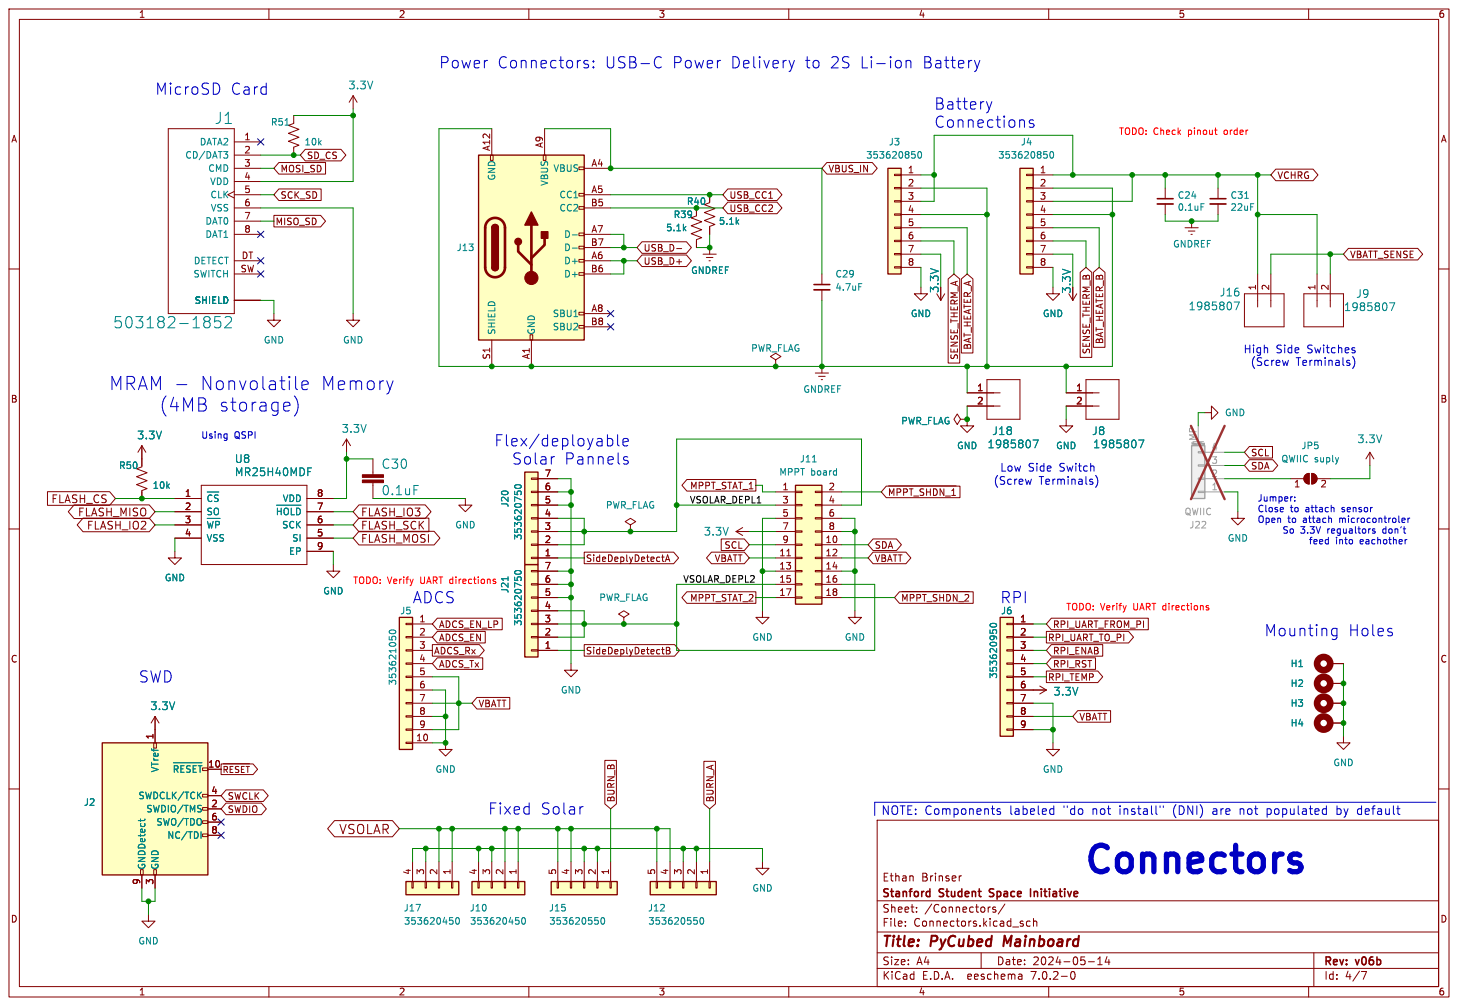
[picture p37: page 4]

TODO: Check pinout order Battery
Connections

Solar Pannels
(Screw Terminals) Low Side Switch Fixed Solar

3 SWDCLK/TCK 4 SWO/TDO 6 NC/TDI 8 GNDDetect 9 3.3V J20 353620750

TODO: Verify UART directions

3 SWDCLK/TCK 4 SWO/TDO 6 NC/TDI 8 GNDDetect 9

Id: 4/7 Title: PyCubed Mainboard

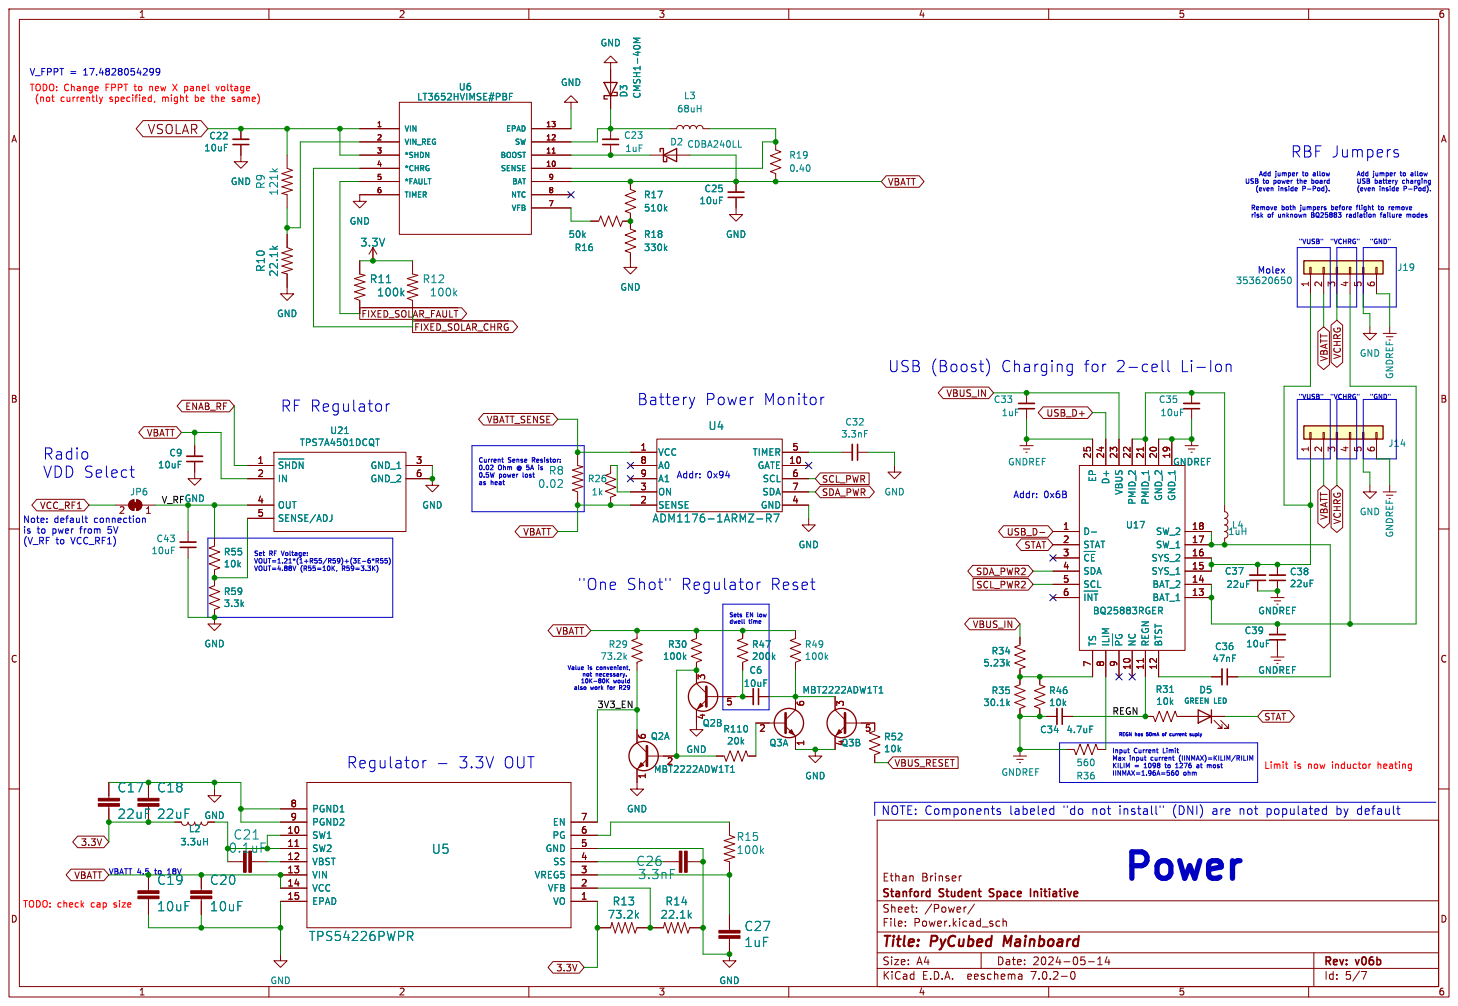
[picture p38: page 5]

TODO: Change FPPT to new X panel voltage

(even inside P-Pod). RBF Jumpers

Add jumper to allow
USB to power the board

USB battery charging

"VUSB" Sets EN low

also work for R29 Battery Power Monitor Addr: 0x94 TODO: check cap size VBATT 4.5 to 18V

Radio
VDD Select Note: default connection

is to pwer from 5V
(V_RF to VCC_RF1)

KILIM = 1098 to 1276 at most

Id: 5/7 Title: PyCubed Mainboard

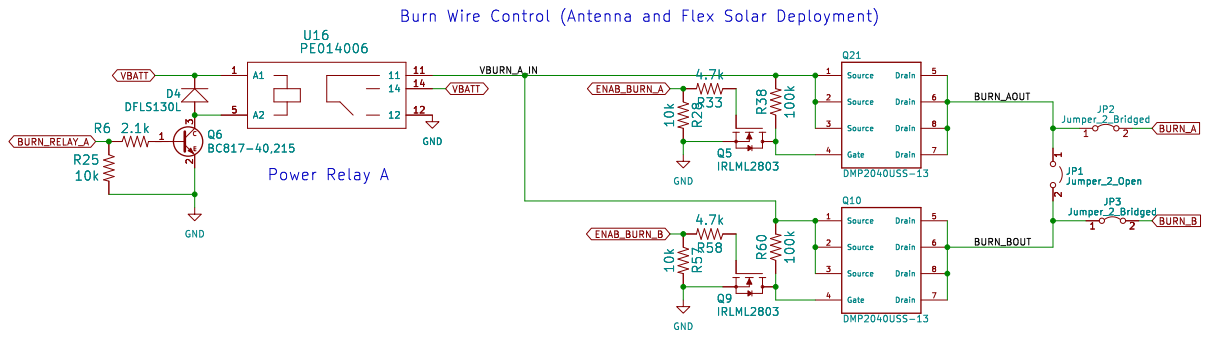
[picture p39: page 6]

BURN_AOUT BURN_BOUT Burn Wire Control (Antenna and Flex Solar Deployment)

Id: 6/7 Title: PyCubed Mainboard

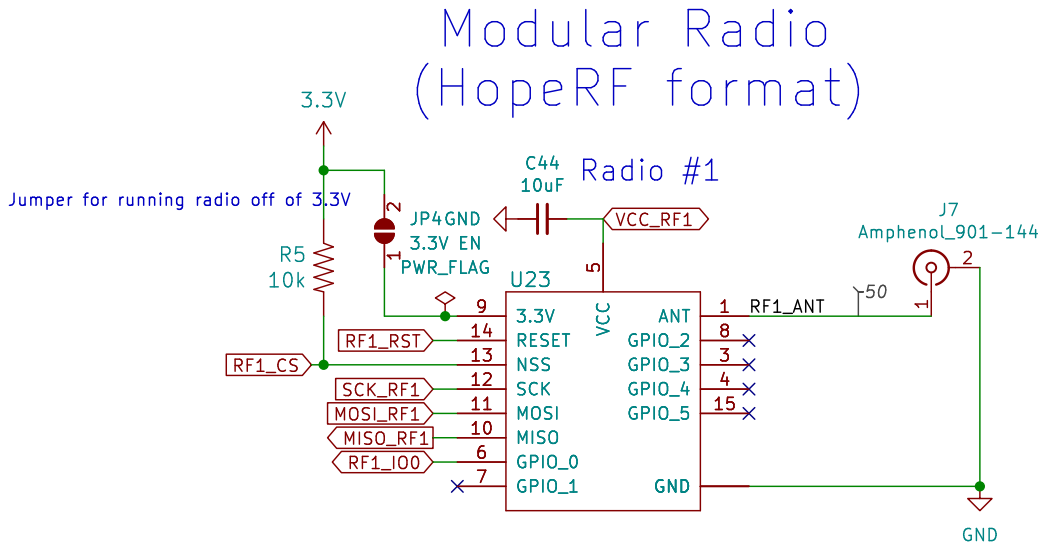
[picture p40: page 7]

5 ANT 1 MISO 10 MOSI 11 SCK 12 NSS 13 RESET 14 GPIO_5 15 GND GPIO_3 3 GPIO_4 4 GPIO_0 6 GPIO_1 7 GPIO_2 8

Id: 7/7 Title: PyCubed Mainboard
