pete4radio/SAMWISE-1-1-HW-Training/mainboard-v06b_samwise/mainboard.kicad_pcb

## KiCad design mainboard-v06b_samwise/mainboard.kicad_pcb (2024-05-15)

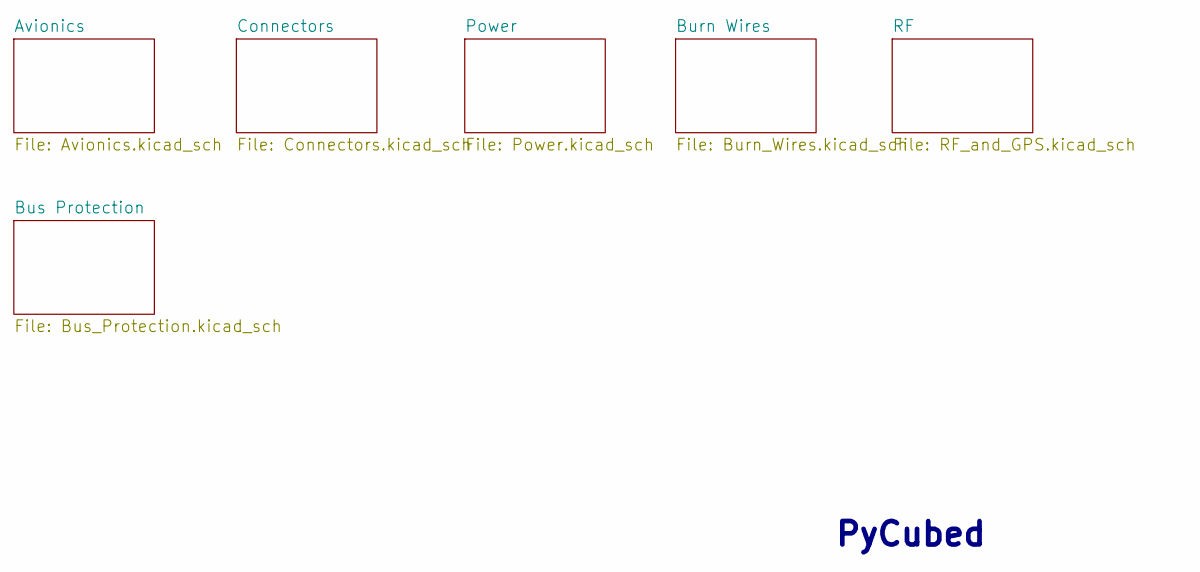
[picture p41: schematic mainboard.kicad_sch, PyCubed Mainboard]

Notes on the sheet:
PyCubed

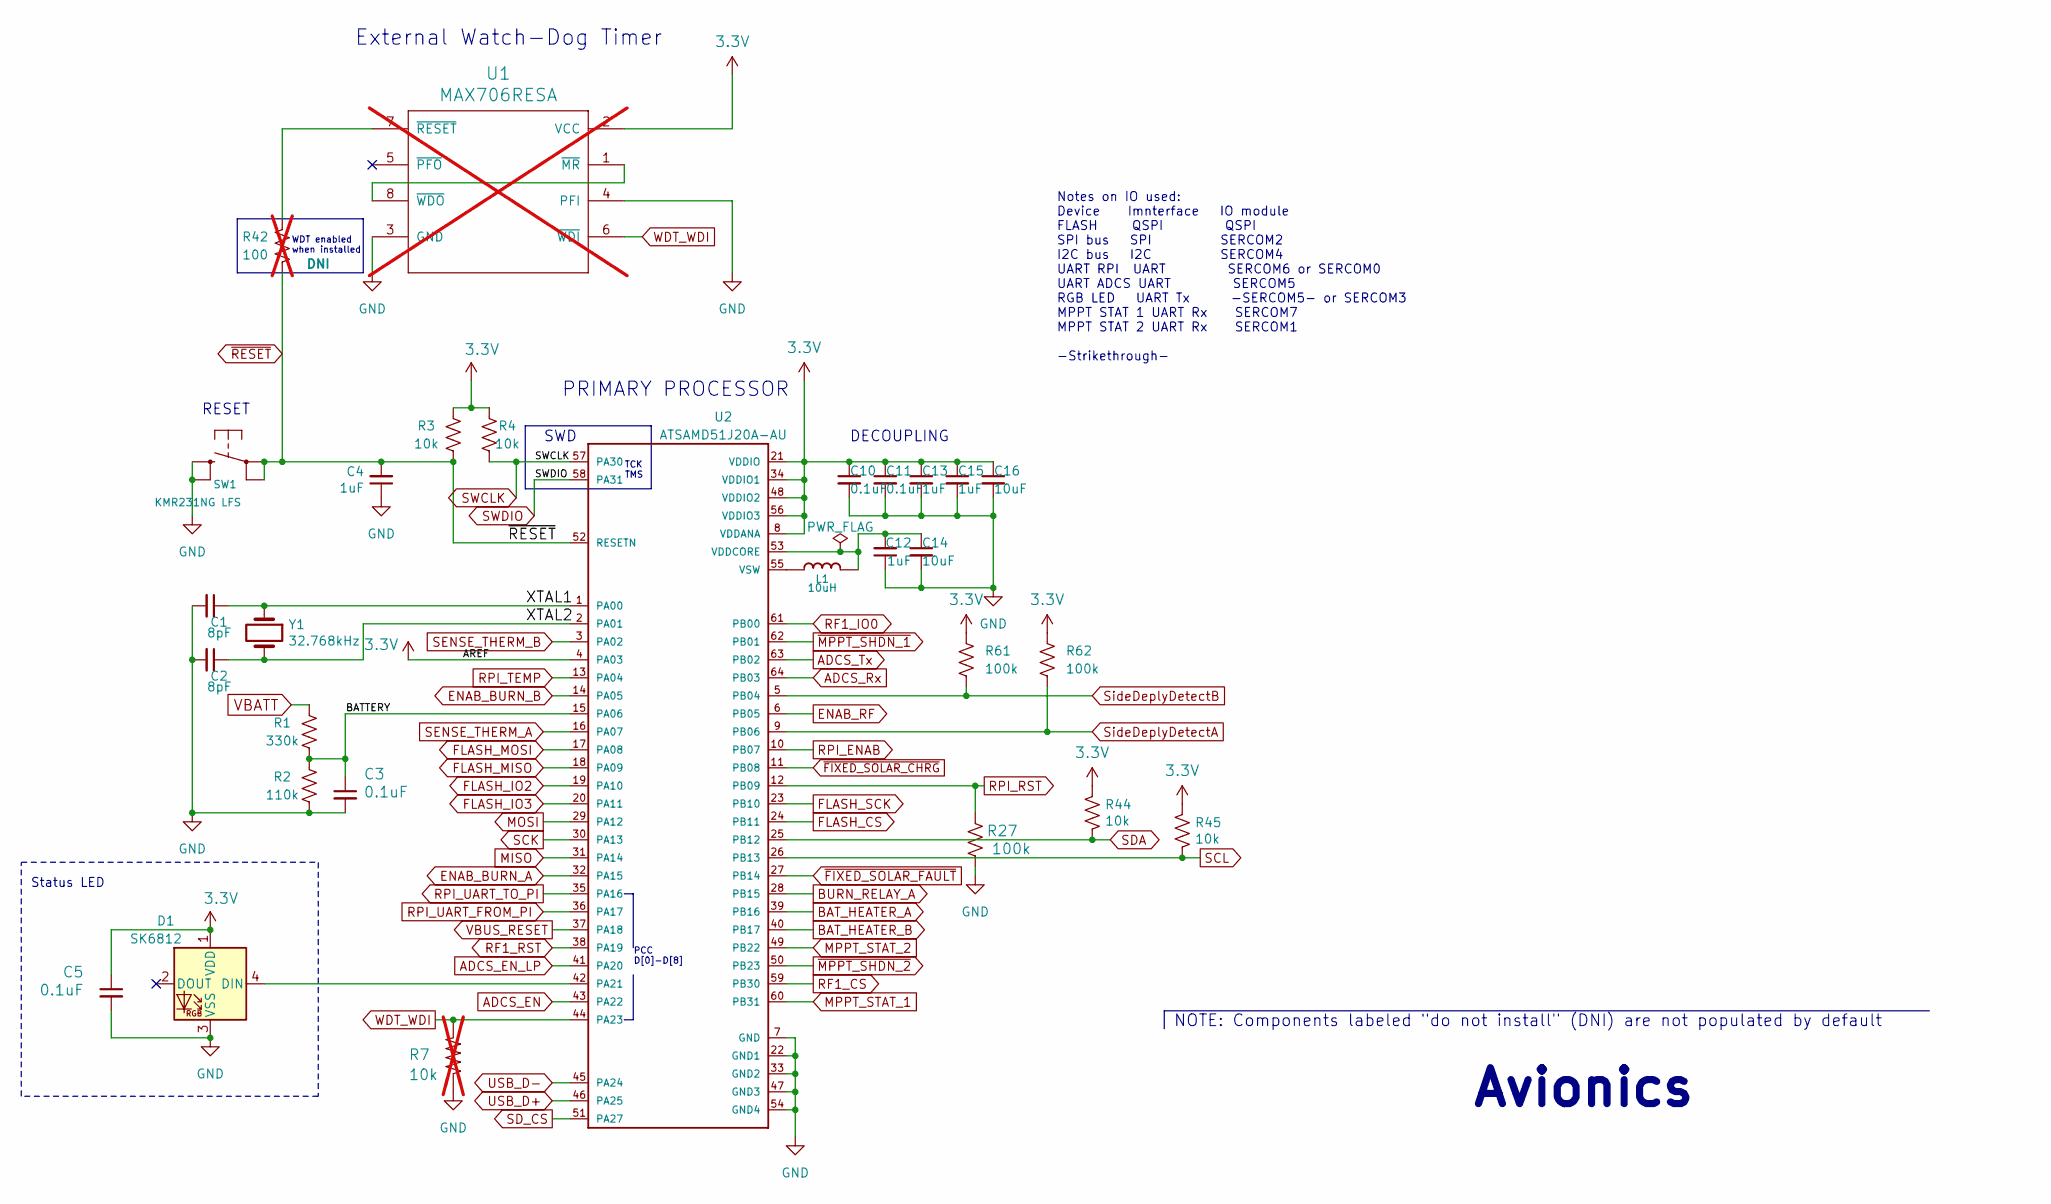
[picture p42: schematic Avionics.kicad_sch, PyCubed Mainboard]

Parts:
C1, C2: 8pF; C_0603_1608Metric
C3, C5, C10, C11: 0.1uF; C_0603_1608Metric
C4, C12, C13, C15: 1uF; C_0603_1608Metric
C14, C16: 10uF; C_0603_1608Metric
D1: SK6812; LED_WS2812B_PLCC4_5.0x5.0mm_P3.2mm; Manufacturer_Part_Number SK6812
L1: 10uH; L_0805_2012Metric_Pad1.15x1.40mm_HandSolder; Manufacturer_Part_Number MGFL2012F100MT-LF
R1: 330k; R_0603_1608Metric
R2: 110k; R_0603_1608Metric
R3, R4, R44, R45: 10k; R_0603_1608Metric
R7: 10k; R_0603_1608Metric; not fitted
R27, R61, R62: 100k; R_0603_1608Metric
R42: 100; R_0603_1608Metric; not fitted
SW1: KMR231NG LFS; BTN_KMR2_4.6X2.8; Manufacturer_Part_Number KMR231NG LFS
U1: MAX706RESA; SO-8_3.9x4.9mm_P1.27mm; Manufacturer_Part_Number MAX706RESA; not fitted
U2: ATSAMD51J20A-AU; QFP50P1200X1200X120-64N; Manufacturer_Part_Number ATSAMD51J20A-AU
Y1: 32.768kHz; Crystal_SMD_3215-2Pin_3.2x1.5mm; Manufacturer_Part_Number SC-32S32.768kHz20PPM7pF

Connections:
/Avionics/BATTERY: C3.1, R1.2, R2.2, U2.15 (PA06)
/Avionics/XTAL1: C1.1, U2.1 (PA00), Y1.1
/Avionics/XTAL2: C2.1, U2.2 (PA01), Y1.2
ADCS_EN: U2.43 (PA22); also elsewhere on the board
ADCS_EN_LP: U2.41 (PA20); also elsewhere on the board
ADCS_Rx: U2.64 (PB03); also elsewhere on the board
ADCS_Tx: U2.63 (PB02); also elsewhere on the board
BAT_HEATER_A: U2.39 (PB16); also elsewhere on the board
BAT_HEATER_B: U2.40 (PB17); also elsewhere on the board
BURN_RELAY_A: U2.28 (PB15); also elsewhere on the board
ENAB_BURN_A: U2.32 (PA15); also elsewhere on the board
ENAB_BURN_B: U2.14 (PA05); also elsewhere on the board
ENAB_RF: U2.6 (PB05); also elsewhere on the board
FLASH_CS: U2.24 (PB11); also elsewhere on the board
FLASH_IO2: U2.19 (PA10); also elsewhere on the board
FLASH_IO3: U2.20 (PA11); also elsewhere on the board
FLASH_MISO: U2.18 (PA09); also elsewhere on the board
FLASH_MOSI: U2.17 (PA08); also elsewhere on the board
FLASH_SCK: U2.23 (PB10); also elsewhere on the board
MISO: U2.31 (PA14); also elsewhere on the board
MOSI: U2.29 (PA12); also elsewhere on the board
MPPT_STAT_1: U2.60 (PB31); also elsewhere on the board
MPPT_STAT_2: U2.49 (PB22); also elsewhere on the board
unnamed: D1.4 (DIN), U2.42 (PA21)
unnamed: U1.1 (~MR), U1.8 (~WDO)
unnamed: R42.2, U1.7 (~RESET)
unnamed: C12.2, C14.1, L1.1, U2.53 (VDDCORE)
unnamed: L1.2, U2.55 (VSW)
RF1_CS: U2.59 (PB30); also elsewhere on the board
RF1_IO0: U2.61 (PB00); also elsewhere on the board
RF1_RST: U2.38 (PA19); also elsewhere on the board
RPI_ENAB: U2.10 (PB07); also elsewhere on the board
RPI_RST: R27.2, U2.12 (PB09); also elsewhere on the board
RPI_TEMP: U2.13 (PA04); also elsewhere on the board
RPI_UART_FROM_PI: U2.36 (PA17); also elsewhere on the board
RPI_UART_TO_PI: U2.35 (PA16); also elsewhere on the board
SCK: U2.30 (PA13); also elsewhere on the board
SCL: R45.2, U2.26 (PB13); also elsewhere on the board
SDA: R44.2, U2.25 (PB12); also elsewhere on the board
SENSE_THERM_A: U2.16 (PA07); also elsewhere on the board
SENSE_THERM_B: U2.3 (PA02); also elsewhere on the board
SWCLK: R4.2, U2.57 (PA30); also elsewhere on the board
SWDIO: U2.58 (PA31); also elsewhere on the board
SideDeplyDetectA: R62.2, U2.9 (PB06); also elsewhere on the board
SideDeplyDetectB: R61.2, U2.5 (PB04); also elsewhere on the board
USB_D+: U2.46 (PA25); also elsewhere on the board
USB_D-: U2.45 (PA24); also elsewhere on the board
VBATT: R1.1; also elsewhere on the board
VBUS_RESET: U2.37 (PA18); also elsewhere on the board
WDT_WDI: R7.2, U1.6 (~WDI), U2.44 (PA23)
~FIXED_SOLAR_CHRG: U2.11 (PB08); also elsewhere on the board
~FIXED_SOLAR_FAULT: U2.27 (PB14); also elsewhere on the board
~MPPT_SHDN_1: U2.62 (PB01); also elsewhere on the board
~MPPT_SHDN_2: U2.50 (PB23); also elsewhere on the board
~RESET: C4.2, R3.2, R42.1, SW1.A, SW1.A' (P1), U2.52 (RESETN); also elsewhere on the board

Notes on the sheet:
PRIMARY PROCESSOR
SWD
Avionics
PCC D[0]-D[8]
NOTE: Components labeled "do not install" (DNI) are not populated by default
TCK TMS
Notes on IO used: Device Imnterface IO module FLASH QSPI QSPI SPI bus SPI SERCOM2 I2C bus I2C SERCOM4 UART RPI UART SERCOM6 or SERCOM0 UART ADCS UART SERCOM5 RGB LED UART Tx -SERCOM5- or SERCOM3 MPPT STAT 1 UART Rx SERCOM7 MPPT STAT 2 UART Rx SERCOM1 -Strikethrough-
RESET
WDT enabled when installed
Status LED
External Watch-Dog Timer
DECOUPLING

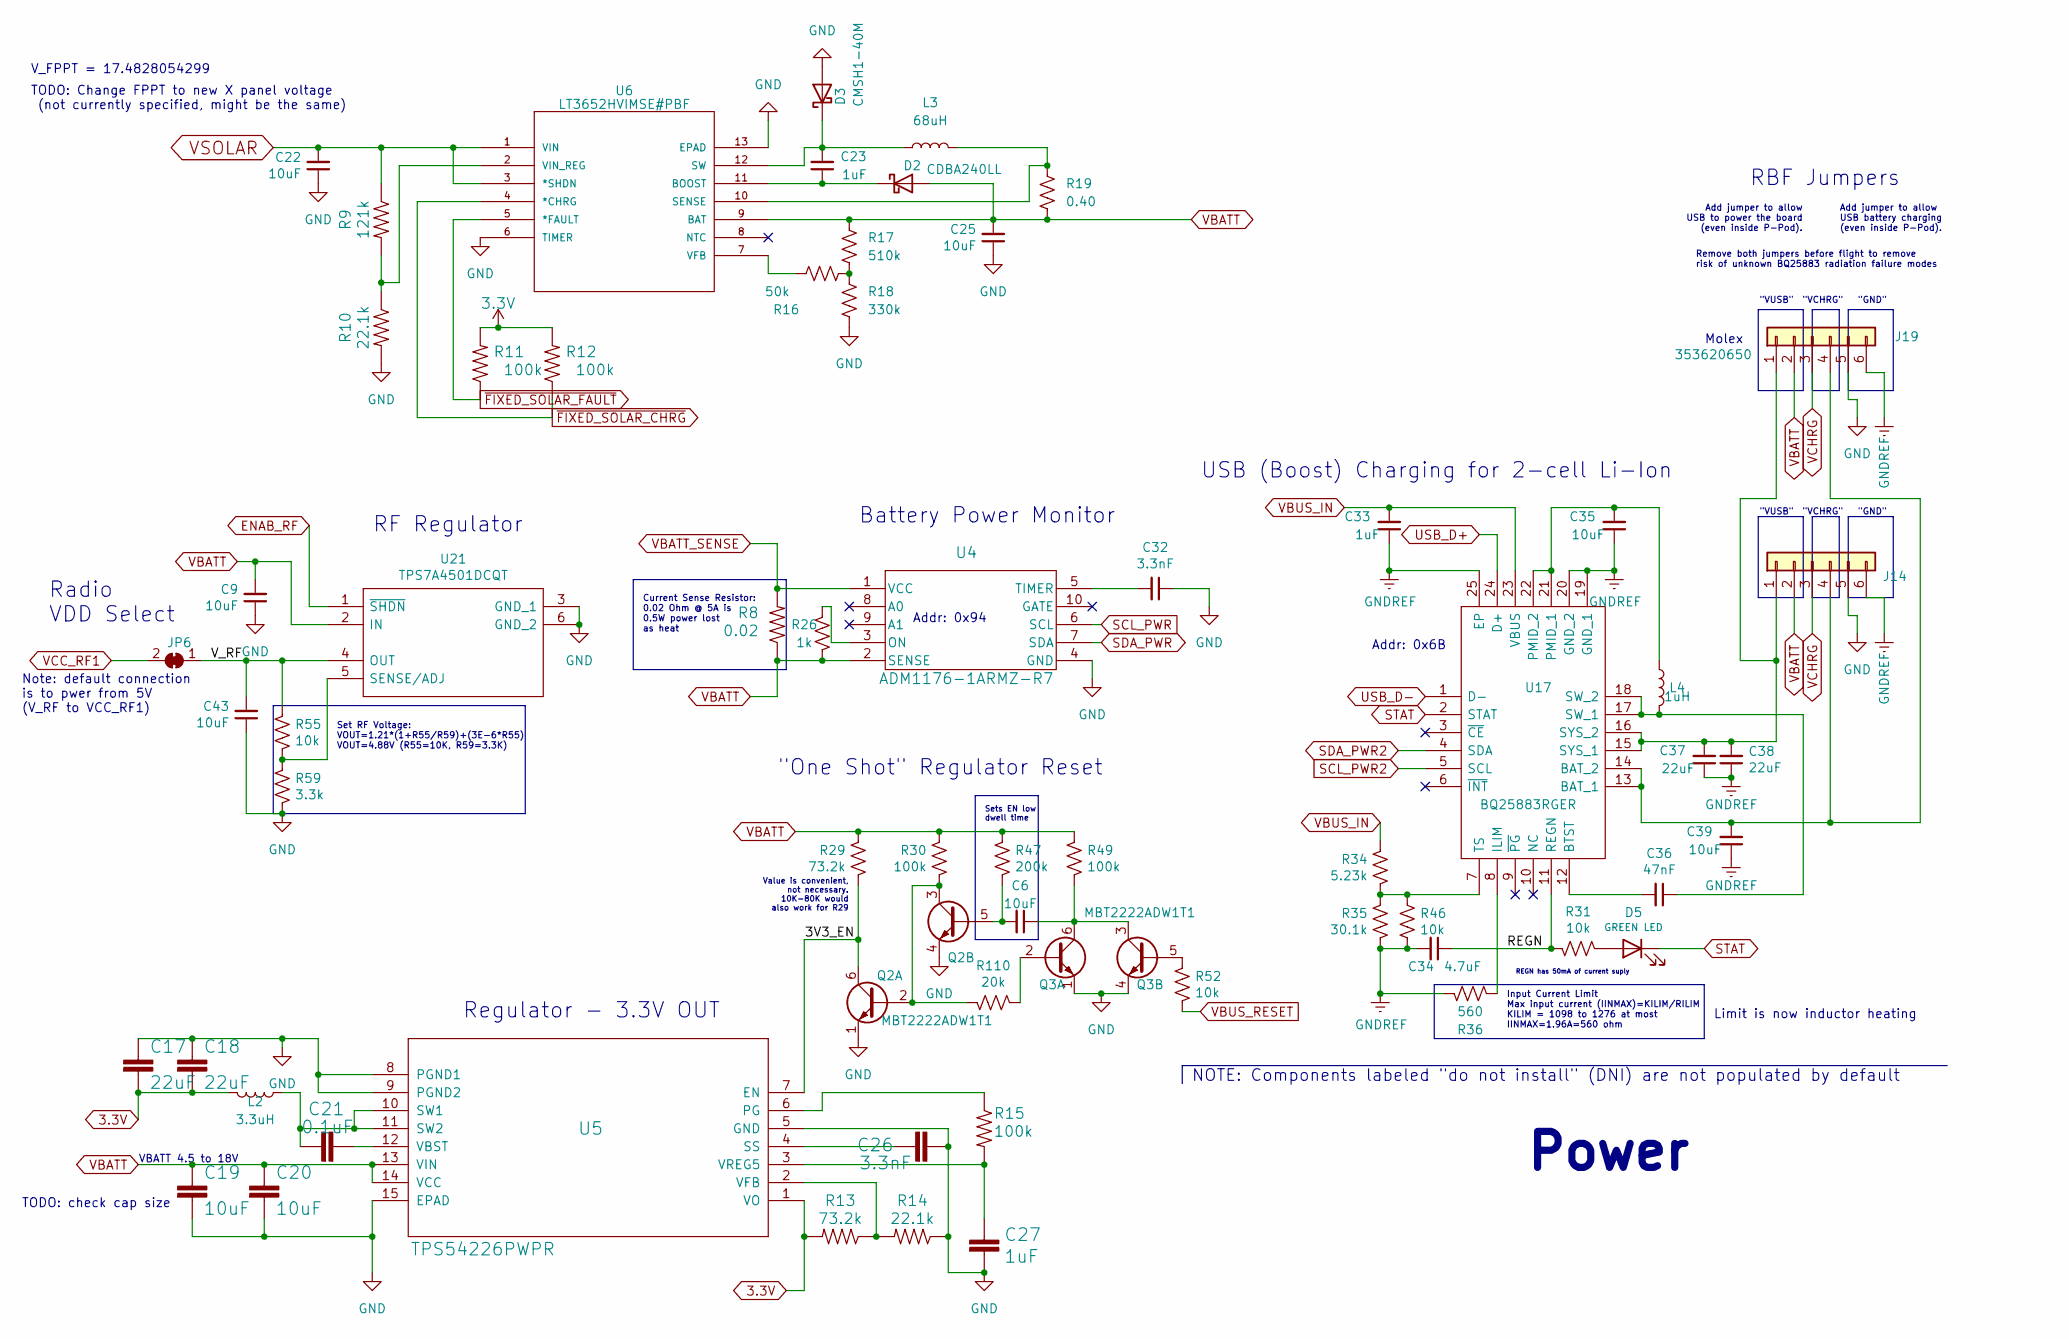
[picture p43: schematic Power.kicad_sch, PyCubed Mainboard]

Parts:
C6, C9, C25, C35, C39, C43: 10uF; C_0603_1608Metric
C17, C18, C37, C38: 22uF; C_0603_1608Metric
C19, C20, C22: 10uF; C_1210_3225Metric
C21: 0.1uF; C_0603_1608Metric
C23, C27, C33: 1uF; C_0603_1608Metric
C26, C32: 3.3nF; C_0603_1608Metric
C34: 4.7uF; C_0603_1608Metric
C36: 47nF; C_0603_1608Metric
D2: CDBA240LL; DO-214AC
D3: CMSH1-40M; DIOM5226X262N
D5: GREEN LED; LED_0603_1608Metric; Manufacturer_Part_Number LTST-C190KGKT
J14: Conn_01x06_Horizontal; PinHeader_1x06_P2.54mm_Vertical_J14
J19: 353620650; MOLEX_35362-0650
JP6: Jumper_3_Bridged12; SolderJumper-2_P1.3mm_Bridged_RoundedPad1.0x1.5mm
L2: 3.3uH; L_2141; Manufacturer_Part_Number HPC5040NF-3R3MTH
L3: 68uH; SDE06004A-680K
L4: 1uH; L_2510; Manufacturer_Part_Number MCS25GD-1R0MMP
Q2, Q3: MBT2222ADW1T1; SOT-363_SC-70-6; Manufacturer_Part_Number MBT2222ADW1T1G
R8: 0.02; R_2512_6332Metric
R9: 121k; R_0603_1608Metric
R10, R14: 22.1k; R_0603_1608Metric
R11, R12, R15, R30, R49: 100k; R_0603_1608Metric
R13, R29: 73.2k; R_0603_1608Metric
R16: 50k; R_0603_1608Metric
R17: 510k; R_0603_1608Metric
R18: 330k; R_0603_1608Metric
R19: 0.40; R_2512_6332Metric
R26: 1k; R_0603_1608Metric
R31, R46, R52, R55: 10k; R_0603_1608Metric
R34: 5.23k; R_0603_1608Metric
R35: 30.1k; R_0603_1608Metric
R36: 560; R_0603_1608Metric
R47: 200k; R_0603_1608Metric
R59: 3.3k; R_0603_1608Metric
R110: 20k; R_0603_1608Metric
U4: ADM1176-1ARMZ-R7; Manufacturer_Part_Number ADM1176-1ARMZ-R7
U5: TPS54226PWPR; PWP14_2P31X2P46-L; Manufacturer_Part_Number TPS54226PWPR
U6: LT3652HVIMSE#PBF; MSOP-12_MSE; MANUFACTURER_PART_NUMBER lt3652hvimse#pbf
U17: BQ25883RGER; QFN50P400X400X100-25N-D; Manufacturer_Part_Number BQ25883RGER
U21: TPS7A4501DCQT; Manufacturer_Part_Number TPS7A4501DCQT; Mouser Part Number 595-TPS7A4501DCQT

Connections:
/Power/3V3_EN: Q2.6 (C1), R29.2, U5.7 (EN)
/Power/REGN: C34.1, R31.2, U17.11 (REGN)
/Power/V_RF: C43.2, JP6.1 (A), R55.1, U21.4 (OUT)
ENAB_RF: U21.1 (~SHDN); also elsewhere on the board
GNDREF: C33.1, C34.2, C35.1, C37.1, C38.1, C39.1, J14.6, J19.6, R35.1, R36.1, R46.1, U17.19 (GND_1), U17.20 (GND_2), U17.25 (EP); also elsewhere on the board
unnamed: C23.1, D2.1 (K), U6.11 (BOOST)
unnamed: C23.2, D3.1 (K), L3.1, U6.12 (SW)
unnamed: D5.2 (A), R31.1
unnamed: C37.2, C38.2, J14.1, J19.1, U17.15 (SYS_1), U17.16 (SYS_2)
unnamed: C39.2, J14.4, J19.4, U17.13 (BAT_1), U17.14 (BAT_2)
unnamed: Q2.2 (B1), Q2.3 (C2), R30.2, R110.2
unnamed: C6.2, Q2.5 (B2), R47.2
unnamed: Q3.2 (B1), R110.1
unnamed: C6.1, Q3.3 (C2), Q3.6 (C1), R49.2
unnamed: Q3.5 (B2), R52.1
unnamed: R16.2, R17.2, R18.1
unnamed: R26.2, U4.3 (ON)
unnamed: C32.2, U4.5 (TIMER)
unnamed: R15.1, U5.6 (PG)
unnamed: C26.1, U5.4 (SS)
unnamed: C21.1, L2.1, U5.10 (SW1), U5.11 (SW2)
unnamed: C21.2, U5.12 (VBST)
unnamed: R13.1, R14.2, U5.2 (VFB)
unnamed: C27.1, R15.2, U5.3 (VREG5)
unnamed: L3.2, R19.1, U6.10 (SENSE)
unnamed: R16.1, U6.7 (VFB)
unnamed: R9.2, R10.1, U6.2 (VIN_REG)
unnamed: C36.2, U17.12 (BTST)
unnamed: R36.2, U17.8 (ILIM)
unnamed: C35.2, L4.1, U17.21 (PMID_1), U17.22 (PMID_2)
unnamed: C36.1, L4.2, U17.17 (SW_1), U17.18 (SW_2)
unnamed: R34.2, R35.2, R46.2, U17.7 (TS)
unnamed: R55.2, R59.1, U21.5 (SENSE/ADJ)
SCL_PWR: U4.6 (SCL); also elsewhere on the board
SCL_PWR2: U17.5 (SCL); also elsewhere on the board
SDA_PWR: U4.7 (SDA); also elsewhere on the board
SDA_PWR2: U17.4 (SDA); also elsewhere on the board
STAT: D5.1 (K), U17.2 (STAT)
USB_D+: U17.24 (D+); also elsewhere on the board
USB_D-: U17.1 (D-); also elsewhere on the board
VBATT: C9.2, C19.1, C20.1, C25.2, D2.2 (A), J14.2, J19.2, R8.1, R17.1, R19.2, R26.1, R29.1, R30.1, R47.1, R49.1, U4.2 (SENSE), U5.13 (VIN), U5.14 (VCC), U6.9 (BAT), U21.2 (IN); also elsewhere on the board
VBATT_SENSE: R8.2, U4.1 (VCC); also elsewhere on the board
VBUS_IN: C33.2, R34.1, U17.23 (VBUS); also elsewhere on the board
VBUS_RESET: R52.2; also elsewhere on the board
VCC_RF1: JP6.2 (B); also elsewhere on the board
VCHRG: J14.3, J19.3; also elsewhere on the board
VSOLAR: C22.2, R9.1, U6.1 (VIN), U6.3 (*SHDN); also elsewhere on the board
~FIXED_SOLAR_CHRG: R12.1, U6.4 (*CHRG); also elsewhere on the board
~FIXED_SOLAR_FAULT: R11.1, U6.5 (*FAULT); also elsewhere on the board

Notes on the sheet:
Addr: 0x94
USB (Boost) Charging for 2-cell Li-Ion
Input Current Limit Max input current (IINMAX)=KILIM/RILIM KILIM = 1098 to 1276 at most IINMAX=1.96A=560 ohm
Addr: 0x6B
Power
"VUSB"
"One Shot" Regulator Reset
Remove both jumpers before flight to remove risk of unknown BQ25883 radiation failure modes
Radio VDD Select
Battery Power Monitor
VBATT 4.5 to 18V
RF Regulator
Current Sense Resistor: 0.02 Ohm @ 5A is 0.5W power lost as heat
Value is convenient, not necessary. 10K-80K would also work for R29
Limit is now inductor heating
TODO: Change FPPT to new X panel voltage (not currently specified, might be the same)
V_FPPT = 17.4828054299
TODO: check cap size
Add jumper to allow USB to power the board (even inside P-Pod).
Note: default connection is to pwer from 5V (V_RF to VCC_RF1)
"VCHRG"
"GND"
Regulator - 3.3V OUT
Set RF Voltage: VOUT=1.21*(1+R55/R59)+(3E-6*R55) VOUT=4.88V (R55=10K, R59=3.3K)
NOTE: Components labeled "do not install" (DNI) are not populated by default
REGN has 50mA of current suply
RBF Jumpers
Add jumper to allow USB battery charging (even inside P-Pod).
Molex
Sets EN low dwell time

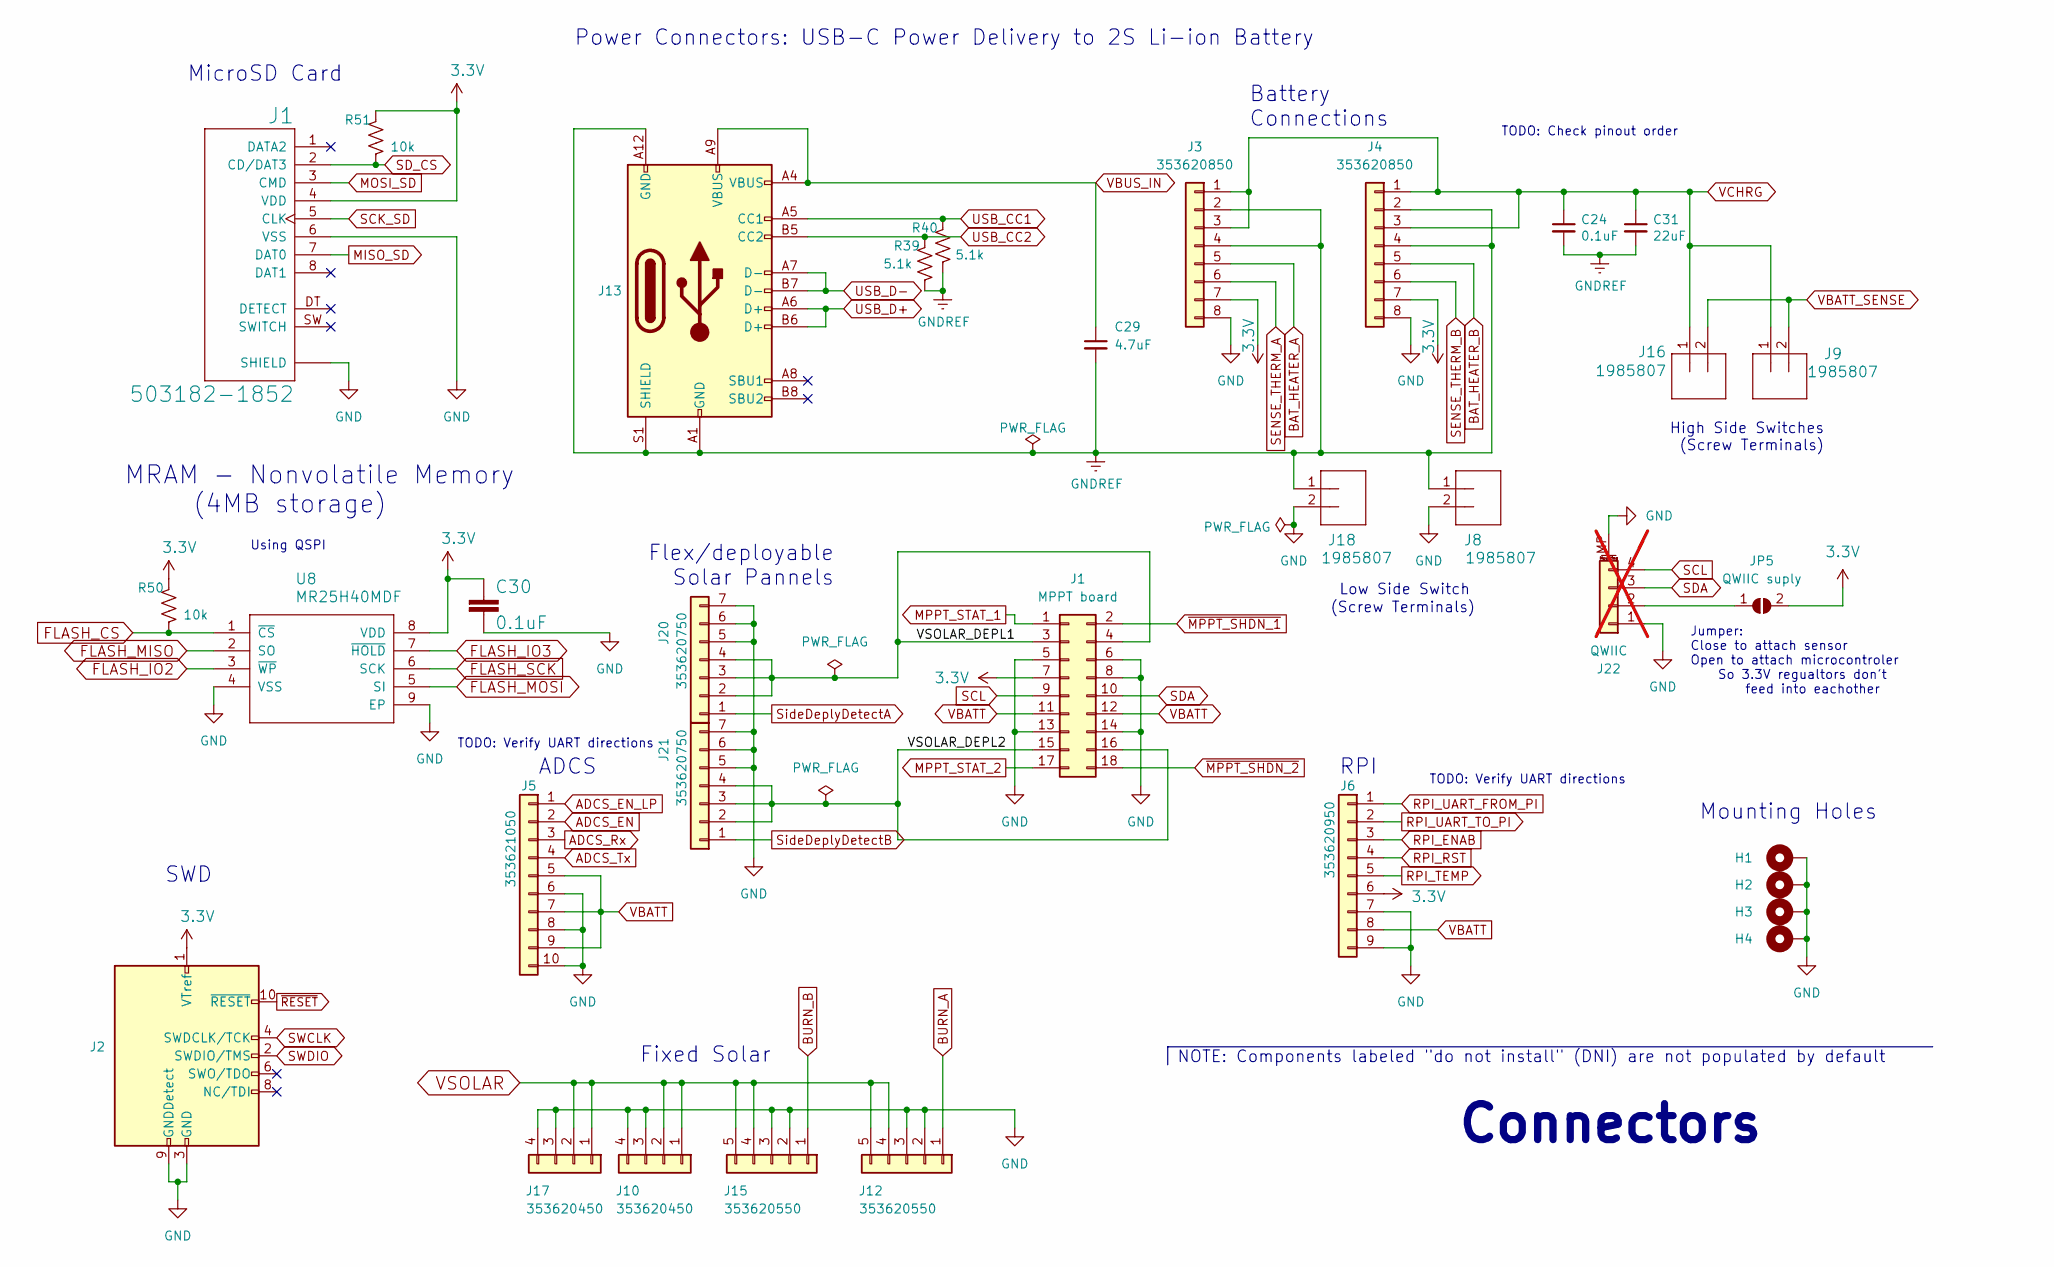
[picture p44: schematic Connectors.kicad_sch, PyCubed Mainboard]

Parts:
C24, C30: 0.1uF; C_0603_1608Metric
C29: 4.7uF; C_0603_1608Metric
C31: 22uF; C_0603_1608Metric
H1, H2, H3, H4: MountingHole_Pad; MountingHole_3.2mm_M3_DIN965_Pad
J1: 503182-1852; MOLEX_503182-1852; Manufacturer_Part_Number 5031821852
J2: Conn_ARM_JTAG_SWD_10; SAMTEC_FTSH-105-01-L-DV-007
J3, J4: 353620850
J5: 353621050; MOLEX_35362-1050
J6: 353620950; MOLEX_35362-0950
J8, J9, J16, J18: 1985807; SCREWTERMINAL-3.5MM-2_LOCK; Manufacturer_Part_Number 1985807
J10, J17: 353620450; MOLEX_35362-0450
J12, J15: 353620550; MOLEX_35362-0550
J13: USB_C_pycubed; USB_C_Receptacle_XKB_U262-161N-4BVC11
J20, J21: 353620750; MOLEX_35362-0750
J22: QWIIC; JST_SH_BM04B-SRSS-TB_1x04-1MP_P1.00mm_Vertical; not fitted
JP5: QWIIC suply; SolderJumper-2_P1.3mm_Open_RoundedPad1.0x1.5mm
R39, R40: 5.1k; R_0603_1608Metric
R50, R51: 10k; R_0603_1608Metric
U8: MR25H40MDF; SON127P600X500X90-9N; Manufacturer_Part_Number W25Q80DVSNIG

Connections:
/Connectors/VSOLAR_DEPL2: J1.15, J1.16, J21.2, J21.3, J21.4; also elsewhere on the board
ADCS_EN: J5.2; also elsewhere on the board
ADCS_EN_LP: J5.1; also elsewhere on the board
ADCS_Rx: J5.3; also elsewhere on the board
ADCS_Tx: J5.4; also elsewhere on the board
BAT_HEATER_A: J3.5; also elsewhere on the board
BAT_HEATER_B: J4.5; also elsewhere on the board
BURN_A: J12.1; also elsewhere on the board
BURN_B: J15.1; also elsewhere on the board
FLASH_CS: R50.1, U8.1 (~CS); also elsewhere on the board
FLASH_IO2: U8.3 (~WP); also elsewhere on the board
FLASH_IO3: U8.7 (~HOLD); also elsewhere on the board
FLASH_MISO: U8.2 (SO); also elsewhere on the board
FLASH_MOSI: U8.5 (SI); also elsewhere on the board
FLASH_SCK: U8.6 (SCK); also elsewhere on the board
GNDREF: C24.2, C29.2, C31.2, J3.2, J3.4, J4.2, J4.4, J8.1, J13.A1 (GND), J13.A12 (GND), J13.S1 (SHIELD), J18.1, R39.1, R40.1; also elsewhere on the board
unnamed: J22.2, JP5.1 (A)
RPI_ENAB: J6.3; also elsewhere on the board
RPI_RST: J6.4; also elsewhere on the board
RPI_TEMP: J6.5; also elsewhere on the board
RPI_UART_FROM_PI: J6.1; also elsewhere on the board
RPI_UART_TO_PI: J6.2; also elsewhere on the board
SCL: J1.9, J22.4; also elsewhere on the board
SDA: J1.10, J22.3; also elsewhere on the board
SENSE_THERM_A: J3.6; also elsewhere on the board
SENSE_THERM_B: J4.6; also elsewhere on the board
SWCLK: J2.4 (SWDCLK/TCK); also elsewhere on the board
SWDIO: J2.2 (SWDIO/TMS); also elsewhere on the board
SideDeplyDetectA: J20.1; also elsewhere on the board
SideDeplyDetectB: J21.1; also elsewhere on the board
USB_CC1: J13.A5 (CC1), R40.2
USB_CC2: J13.B5 (CC2), R39.2
USB_D+: J13.A6 (D+), J13.B6 (D+); also elsewhere on the board
USB_D-: J13.A7 (D-), J13.B7 (D-); also elsewhere on the board
VBATT: J1.11, J1.12, J5.5, J5.7, J5.9, J6.8; also elsewhere on the board
VBATT_SENSE: J9.2, J16.2; also elsewhere on the board
VBUS_IN: C29.1, J13.A4 (VBUS), J13.A9 (VBUS); also elsewhere on the board
VCHRG: C24.1, C31.1, J3.1, J3.3, J4.1, J4.3, J9.1, J16.1; also elsewhere on the board
VSOLAR: J10.1, J10.2, J12.4, J12.5, J15.4, J15.5, J17.1, J17.2; also elsewhere on the board
~RESET: J2.10 (~RESET); also elsewhere on the board

Notes on the sheet:
Flex/deployable Solar Pannels
TODO: Verify UART directions
Jumper: Close to attach sensor Open to attach microcontroler So 3.3V regualtors don't feed into eachother
RPI
Power Connectors: USB-C Power Delivery to 2S Li-ion Battery
NOTE: Components labeled "do not install" (DNI) are not populated by default
ADCS
TODO: Check pinout order
High Side Switches (Screw Terminals)
Connectors
Battery Connections
Low Side Switch
MRAM - Nonvolatile Memory (4MB storage)
MicroSD Card
Fixed Solar
Using QSPI
SWD
(Screw Terminals)
Mounting Holes

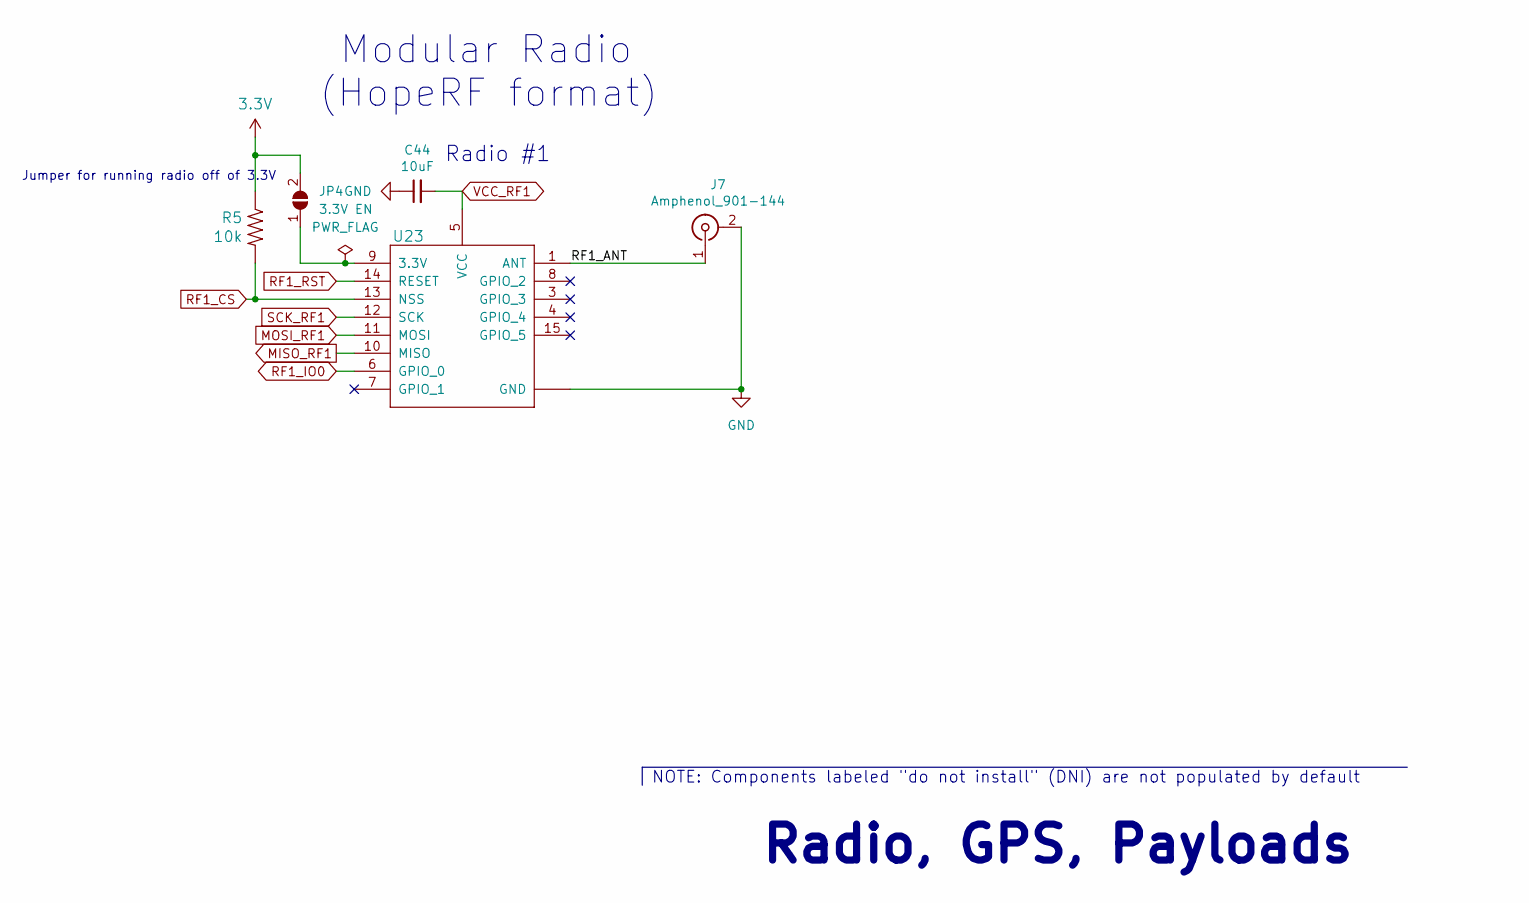
[picture p45: schematic RF_and_GPS.kicad_sch, PyCubed Mainboard]

Parts:
C44: 10uF; C_0603_1608Metric
J7: Amphenol_901-144; SMA_901-144-horizontal; Manufacturer_Part_Number 901-144
JP4: 3.3V EN; SolderJumper-2_P1.3mm_Open_RoundedPad1.0x1.5mm
R5: 10k; R_0603_1608Metric
U23: RFM98PW; Manufacturer_Part_Number RFM98PW

Connections:
/RF/RF1_ANT: J7.1 (In), U23.1 (ANT)
MISO_RF1: U23.10 (MISO); also elsewhere on the board
MOSI_RF1: U23.11 (MOSI); also elsewhere on the board
unnamed: JP4.1 (A), U23.9 (3.3V)
RF1_CS: R5.2, U23.13 (NSS); also elsewhere on the board
RF1_IO0: U23.6 (GPIO_0); also elsewhere on the board
RF1_RST: U23.14 (RESET); also elsewhere on the board
SCK_RF1: U23.12 (SCK); also elsewhere on the board
VCC_RF1: C44.2, U23.5 (VCC); also elsewhere on the board

Notes on the sheet:
Radio #1
Modular Radio (HopeRF format)
NOTE: Components labeled "do not install" (DNI) are not populated by default
Jumper for running radio off of 3.3V
Radio, GPS, Payloads

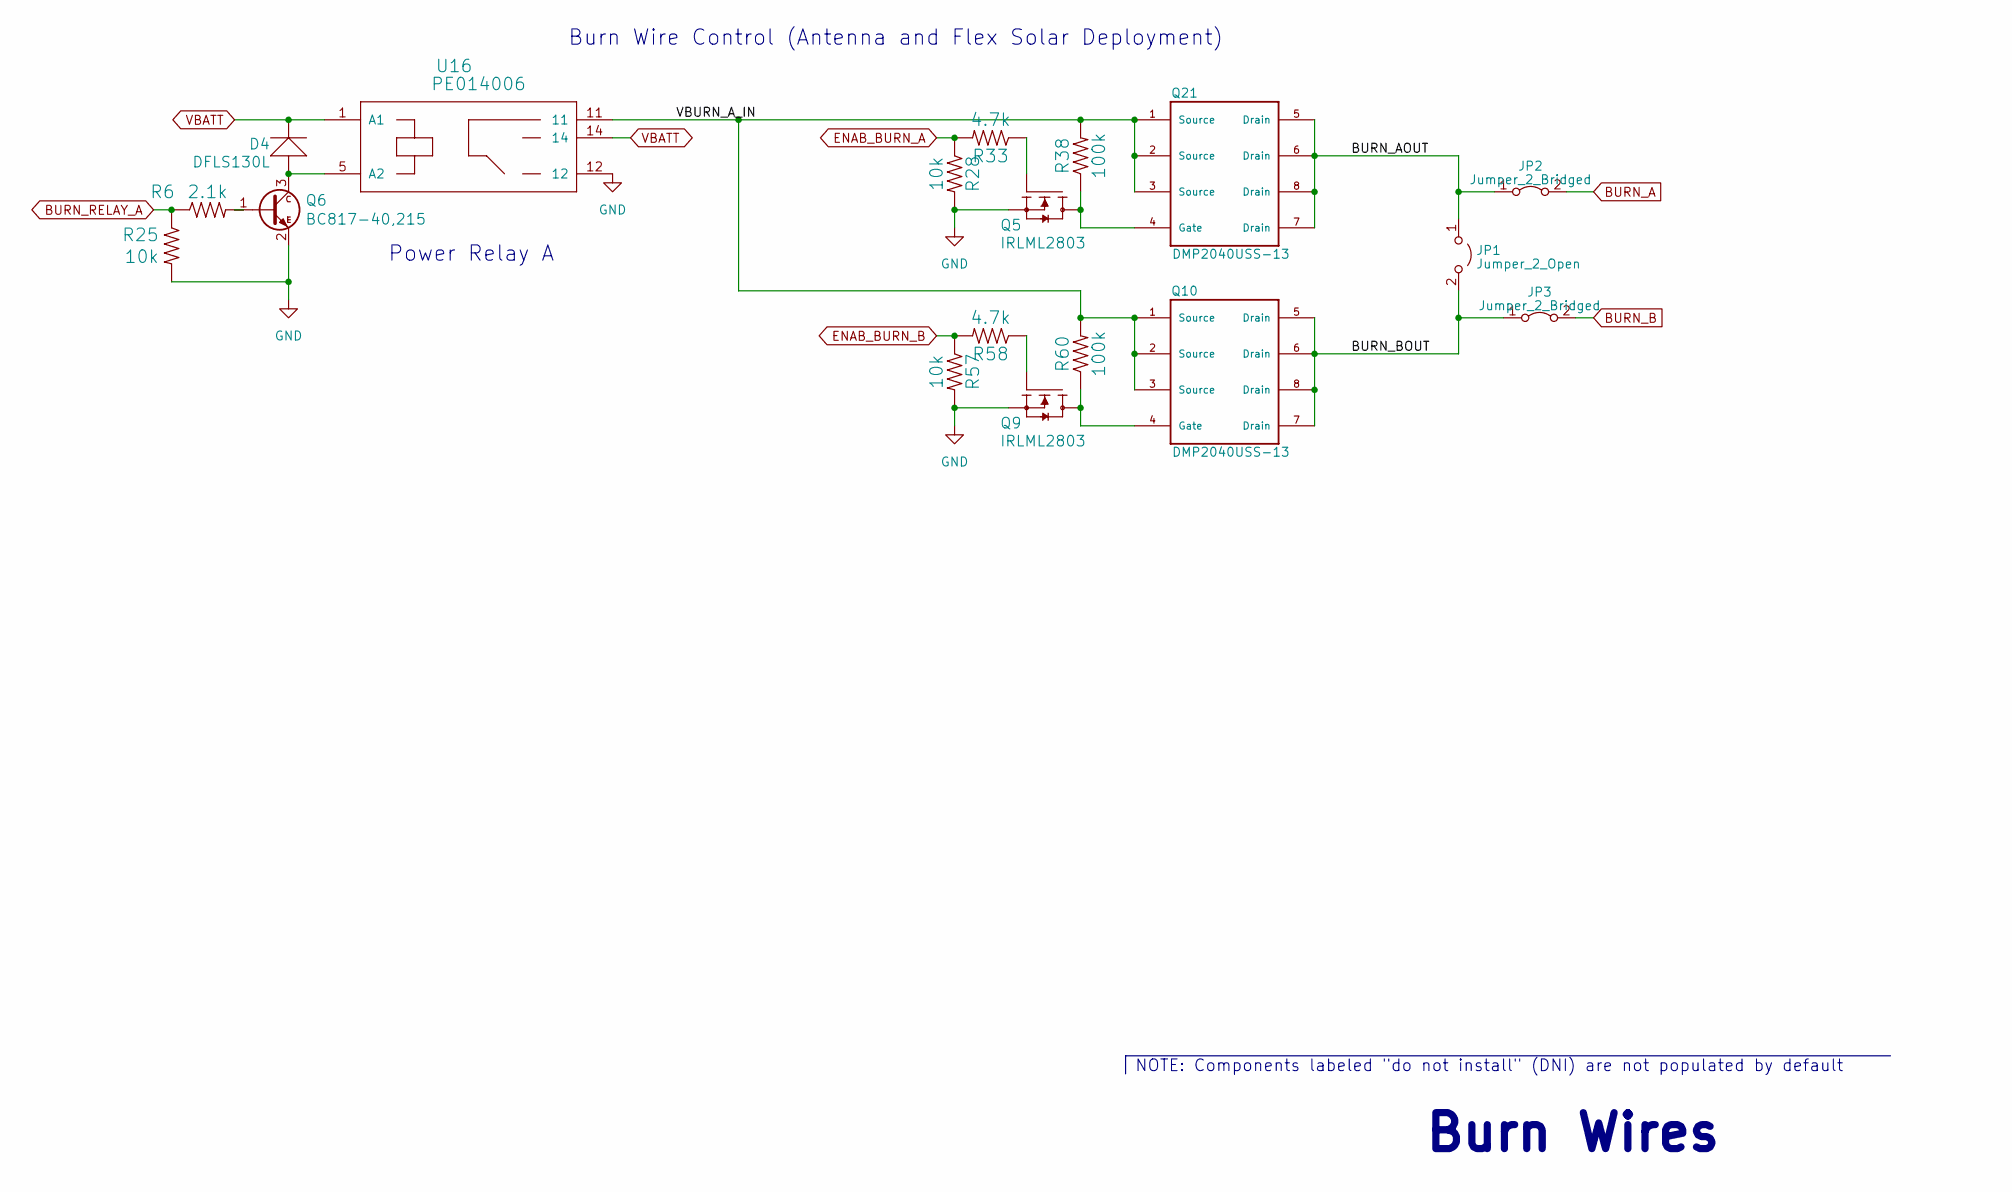
[picture p46: schematic Burn_Wires.kicad_sch, PyCubed Mainboard]

Parts:
D4: DFLS130L; PWRDI-123; Manufacturer_Part_Number DFLS130L-7
JP1: Jumper_2_Open; SolderJumper-2_P1.3mm_Open_Pad1.0x1.5mm
JP2, JP3: Jumper_2_Bridged; SolderJumper-2_P1.3mm_Bridged_Pad1.0x1.5mm
Q5, Q9: IRLML2803; SOT-23; Manufacturer_Part_Number MMBT2222AT
Q6: BC817-40,215; SOT-23; Manufacturer_Part_Number MMBT2222ALT1G -> BC817-40,215
Q10, Q21: DMP2040USS-13; IRF7404TRPBF; Manufacturer_Part_Number DMP2040USS-13
R6: 2.1k; R_0603_1608Metric_Pad0.98x0.95mm_HandSolder
R25, R28, R57: 10k; R_0603_1608Metric
R33, R58: 4.7k; R_0603_1608Metric
R38, R60: 100k; R_0603_1608Metric
U16: PE014006; RELAY_PE014006; Manufacturer_Part_Number PE014006 TE

Connections:
/Burn Wires/BURN_AOUT: JP1.1 (A), JP2.1 (A), Q21.5 (Drain), Q21.6 (Drain), Q21.7 (Drain), Q21.8 (Drain)
/Burn Wires/BURN_BOUT: JP1.2 (B), JP3.1 (A), Q10.5 (Drain), Q10.6 (Drain), Q10.7 (Drain), Q10.8 (Drain)
/Burn Wires/VBURN_A_IN: Q10.1 (Source), Q10.2 (Source), Q10.3 (Source), Q21.1 (Source), Q21.2 (Source), Q21.3 (Source), R38.2, R60.2, U16.11
BURN_A: JP2.2 (B); also elsewhere on the board
BURN_B: JP3.2 (B); also elsewhere on the board
BURN_RELAY_A: R6.1, R25.1; also elsewhere on the board
ENAB_BURN_A: R28.1, R33.2; also elsewhere on the board
ENAB_BURN_B: R57.1, R58.2; also elsewhere on the board
unnamed: Q5.1 (G), R33.1
unnamed: Q6.1 (B), R6.2
unnamed: D4.A, Q6.3 (C), U16.5 (A2)
unnamed: Q9.1 (G), R58.1
unnamed: Q9.3 (D), Q10.4 (Gate), R60.1
unnamed: Q5.3 (D), Q21.4 (Gate), R38.1
VBATT: D4.C, U16.1 (A1), U16.14; also elsewhere on the board

Notes on the sheet:
Burn Wires
NOTE: Components labeled "do not install" (DNI) are not populated by default
Burn Wire Control (Antenna and Flex Solar Deployment)
Power Relay A
