pete4radio/SAMWISE-1-1-HW-Training/mainboard-v06b_samwise/mainboard.kicad_pcb

## KiCad design mainboard-v06b_samwise/mainboard.kicad_pcb (continued)

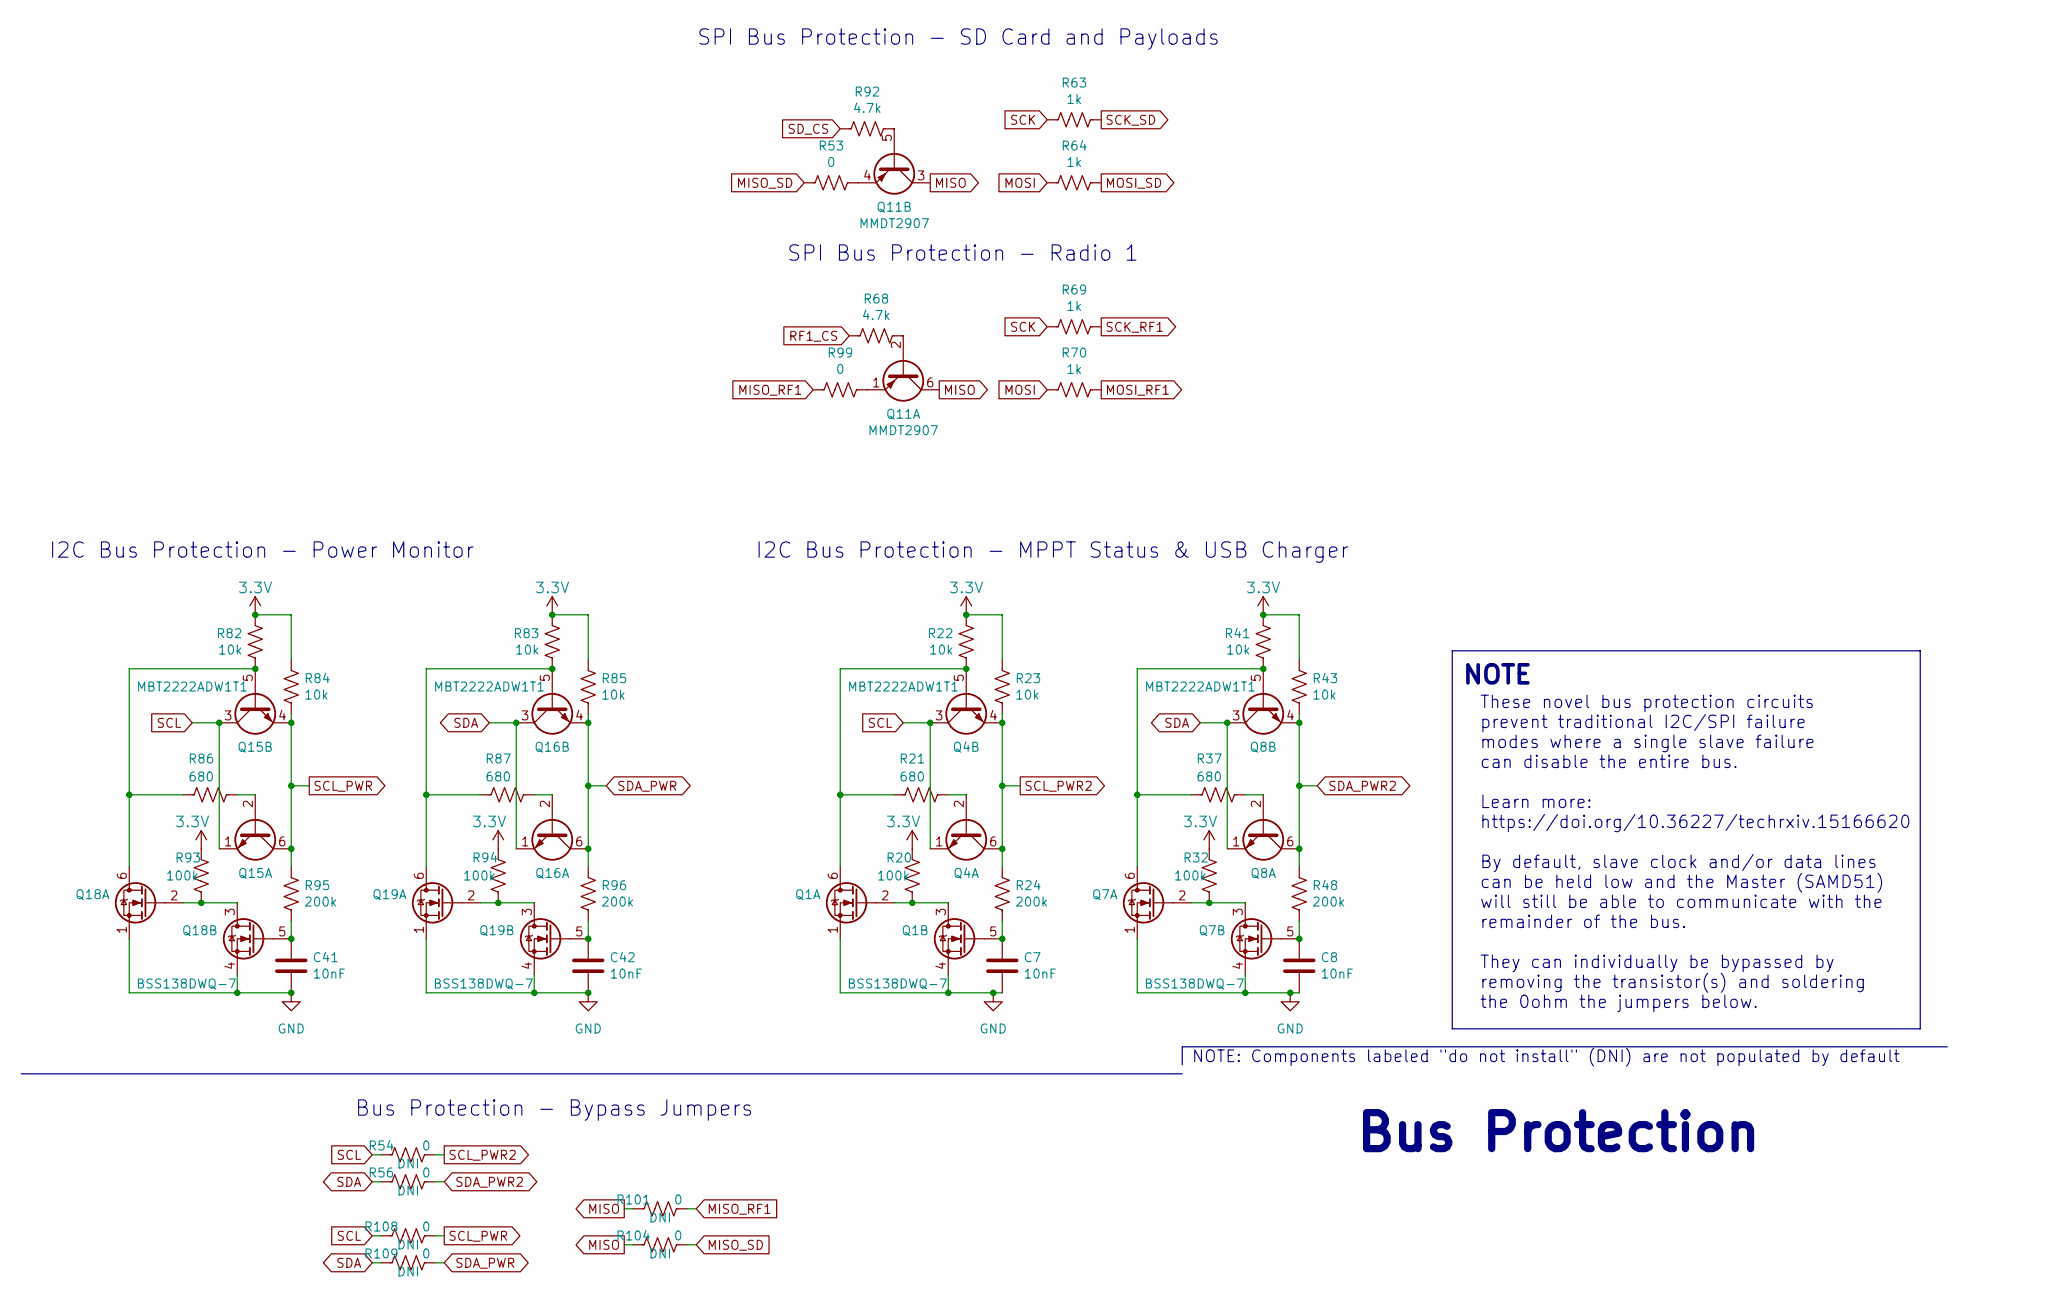
[picture p47: schematic Bus_Protection.kicad_sch, PyCubed Mainboard]

Parts:
C7, C8, C41, C42: 10nF; C_0603_1608Metric
Q1, Q7, Q18, Q19: BSS138DWQ-7; Manufacturer_Part_Number BSS138DWQ-7
Q4, Q8, Q15, Q16: MBT2222ADW1T1; SOT-363_SC-70-6; Manufacturer_Part_Number MBT2222ADW1T1G
Q11: MMDT2907; SOT-363_SC-70-6; Manufacturer_Part_Number MMDT2907AQ-7-F
R20, R32, R93, R94: 100k; R_0603_1608Metric
R21, R37, R86, R87: 680; R_0603_1608Metric
R22, R23, R41, R43, R82, R83, R84, R85: 10k; R_0603_1608Metric
R24, R48, R95, R96: 200k; R_0603_1608Metric
R53, R54, R56, R99, R101, R104, R108, R109: 0; R_0603_1608Metric
R63, R64, R69, R70: 1k; R_0603_1608Metric
R68, R92: 4.7k; R_0603_1608Metric

Connections:
MISO: Q11.3 (C2), Q11.6 (C1), R101.2, R104.2; also elsewhere on the board
MISO_RF1: R99.2, R101.1; also elsewhere on the board
MOSI: R64.2, R70.1; also elsewhere on the board
MOSI_RF1: R70.2; also elsewhere on the board
unnamed: Q1.6 (D1), Q4.5 (B2), R21.2, R22.2
unnamed: Q1.2 (G2), Q1.3 (D2), R20.2
unnamed: C7.1, Q1.5 (G1), R24.2
unnamed: Q4.2 (B1), R21.1
unnamed: Q7.6 (D1), Q8.5 (B2), R37.2, R41.2
unnamed: Q7.2 (G2), Q7.3 (D2), R32.2
unnamed: C8.1, Q7.5 (G1), R48.2
unnamed: Q8.2 (B1), R37.1
unnamed: Q11.2 (B1), R68.1
unnamed: Q11.1 (E1), R99.1
unnamed: Q11.5 (B2), R92.1
unnamed: Q11.4 (E2), R53.1
unnamed: Q15.2 (B1), R86.1
unnamed: Q15.5 (B2), Q18.6 (D1), R82.2, R86.2
unnamed: Q16.2 (B1), R87.1
unnamed: Q16.5 (B2), Q19.6 (D1), R83.2, R87.2
unnamed: Q18.2 (G2), Q18.3 (D2), R93.2
unnamed: C41.1, Q18.5 (G1), R95.2
unnamed: Q19.2 (G2), Q19.3 (D2), R94.2
unnamed: C42.1, Q19.5 (G1), R96.2
RF1_CS: R68.2; also elsewhere on the board
SCK: R63.2, R69.2; also elsewhere on the board
SCK_RF1: R69.1; also elsewhere on the board
SCL: Q4.1 (E1), Q4.3 (C2), Q15.1 (E1), Q15.3 (C2), R54.2, R108.2; also elsewhere on the board
SCL_PWR: Q15.4 (E2), Q15.6 (C1), R84.2, R95.1, R108.1; also elsewhere on the board
SCL_PWR2: Q4.4 (E2), Q4.6 (C1), R23.2, R24.1, R54.1; also elsewhere on the board
SDA: Q8.1 (E1), Q8.3 (C2), Q16.1 (E1), Q16.3 (C2), R56.2, R109.2; also elsewhere on the board
SDA_PWR: Q16.4 (E2), Q16.6 (C1), R85.2, R96.1, R109.1; also elsewhere on the board
SDA_PWR2: Q8.4 (E2), Q8.6 (C1), R43.2, R48.1, R56.1; also elsewhere on the board

Notes on the sheet:
Bus Protection - Bypass Jumpers
I2C Bus Protection - MPPT Status & USB Charger
SPI Bus Protection - Radio 1
These novel bus protection circuits prevent traditional I2C/SPI failure modes where a single slave failure can disable the entire bus. Learn more: https://doi.org/10.36227/techrxiv.15166620 By default, slave clock and/or data lines can be held low and the Master (SAMD51) will still be able to commu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
SPI Bus Protection - SD Card and Payloads
NOTE: Components labeled "do not install" (DNI) are not populated by default
Bus Protection
NOTE
I2C Bus Protection - Power Monitor

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
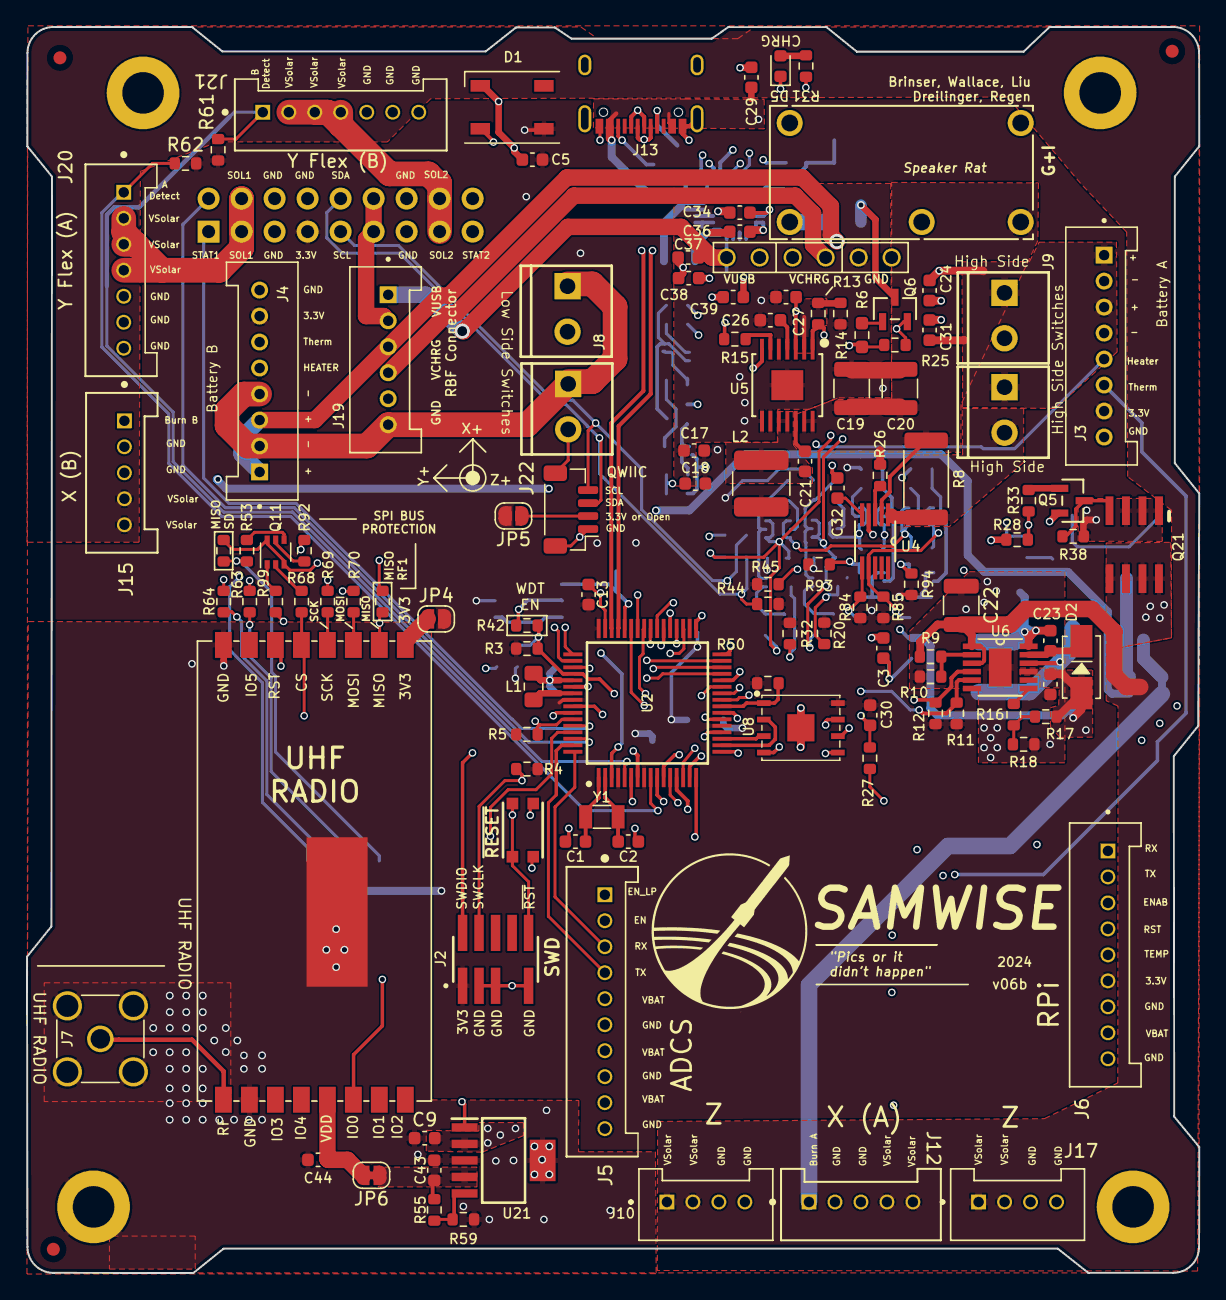
[picture p48: board mainboard.kicad_pcb from above]

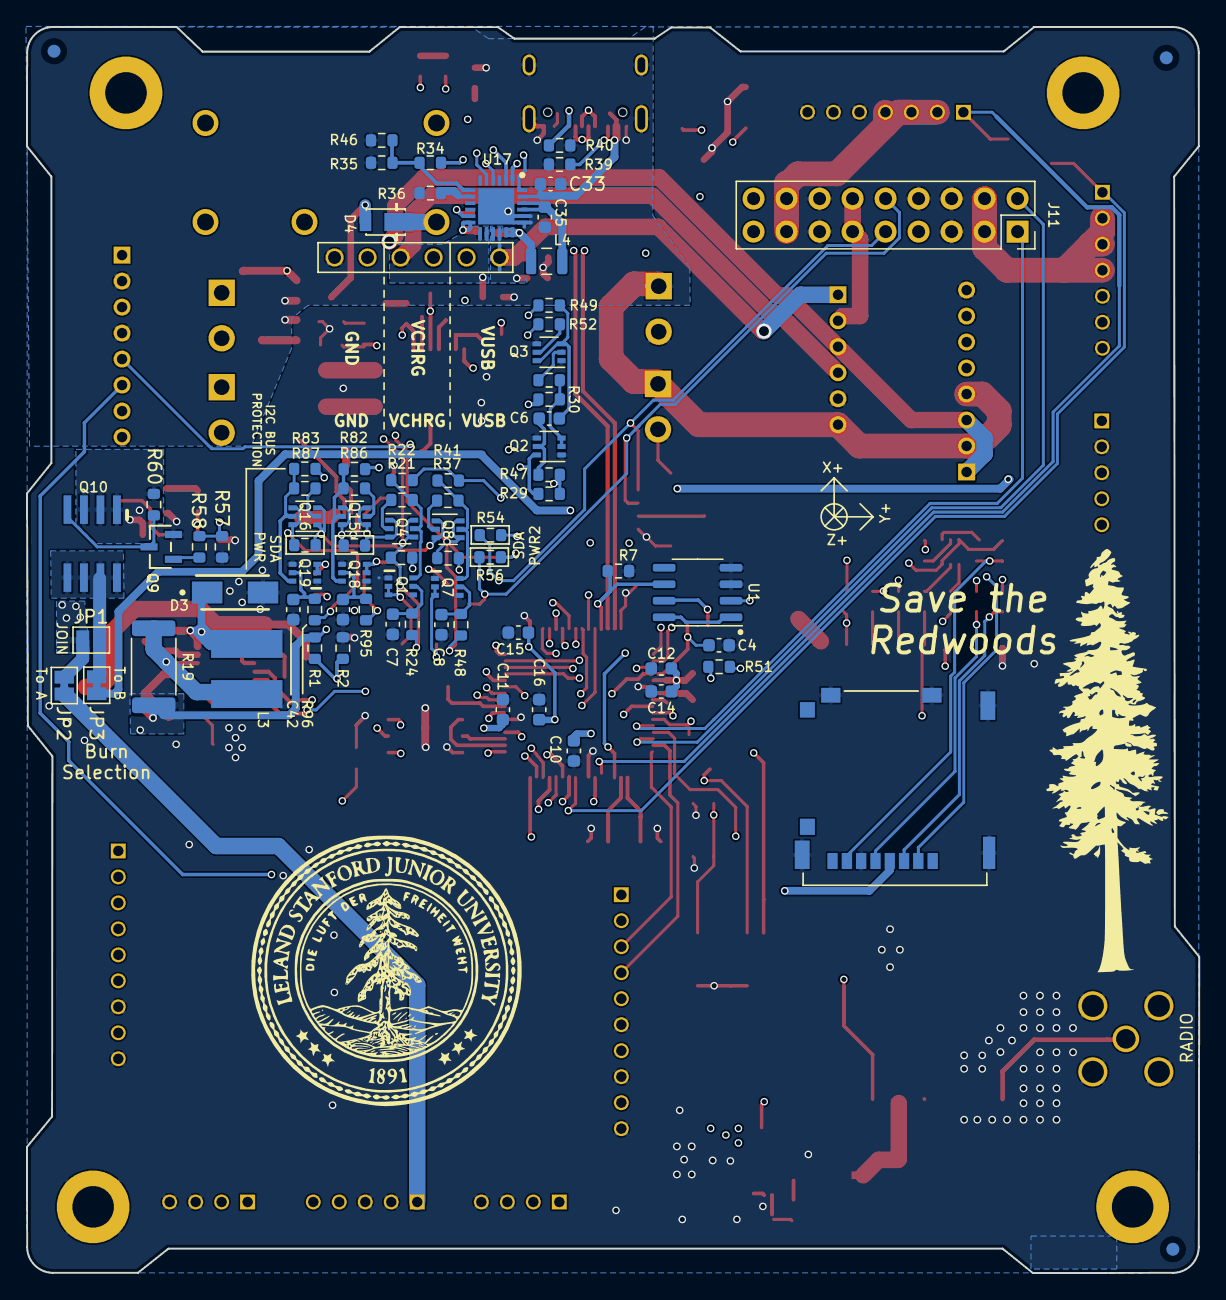
[picture p49: board mainboard.kicad_pcb from below]

Board: 4 copper layers, 90.2 x 95.9 mm, 201 parts (79 on the bottom side), 144 nets.

Other parts of the board:
J11: MPPT board; PinSocket_2x09_P2.54mm_Vertical
REF1B, REF1T, REF2B, REF2T, REF3B, REF3T: Fiducial_1mm_Mask2mm

Their connections:
/Connectors/VSOLAR_DEPL2: J11.15, J11.16; also elsewhere on the board
MPPT_STAT_1: J11.1; also elsewhere on the board
MPPT_STAT_2: J11.17; also elsewhere on the board
SCL: J11.9; also elsewhere on the board
SDA: J11.10; also elsewhere on the board
VBATT: J11.11, J11.12; also elsewhere on the board
~MPPT_SHDN_1: J11.2; also elsewhere on the board
~MPPT_SHDN_2: J11.18; also elsewhere on the board
