pete4radio/SAMWISE-1-1-HW-Training/RPi_Interface/RPi_interface.kicad_pcb

## KiCad design RPi_Interface/RPi_interface.kicad_pcb (2024-05-09)

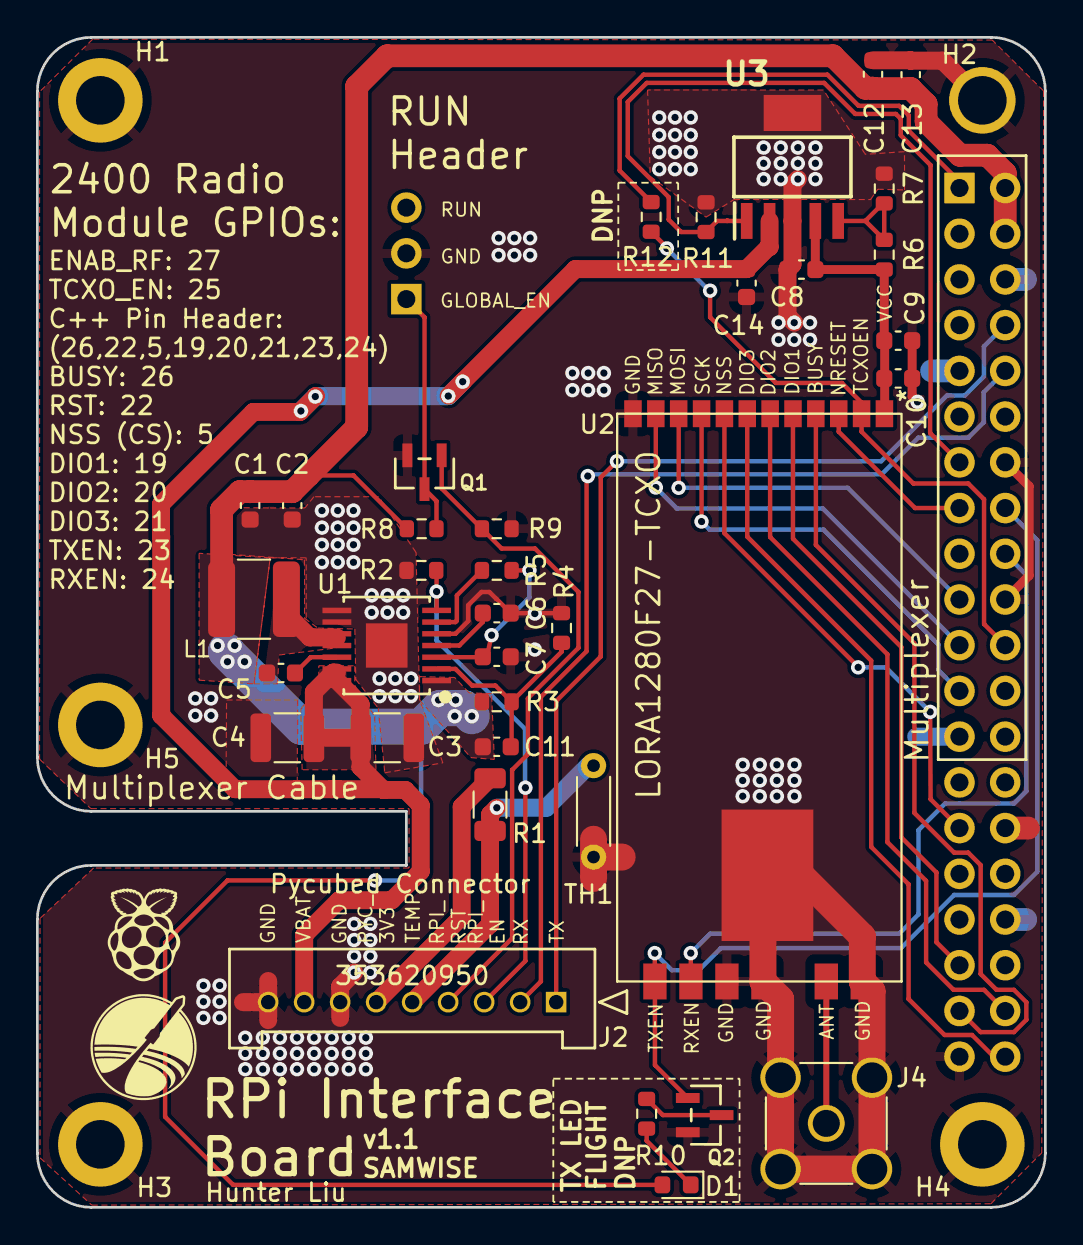
[picture p50: board RPi_interface.kicad_pcb from above]

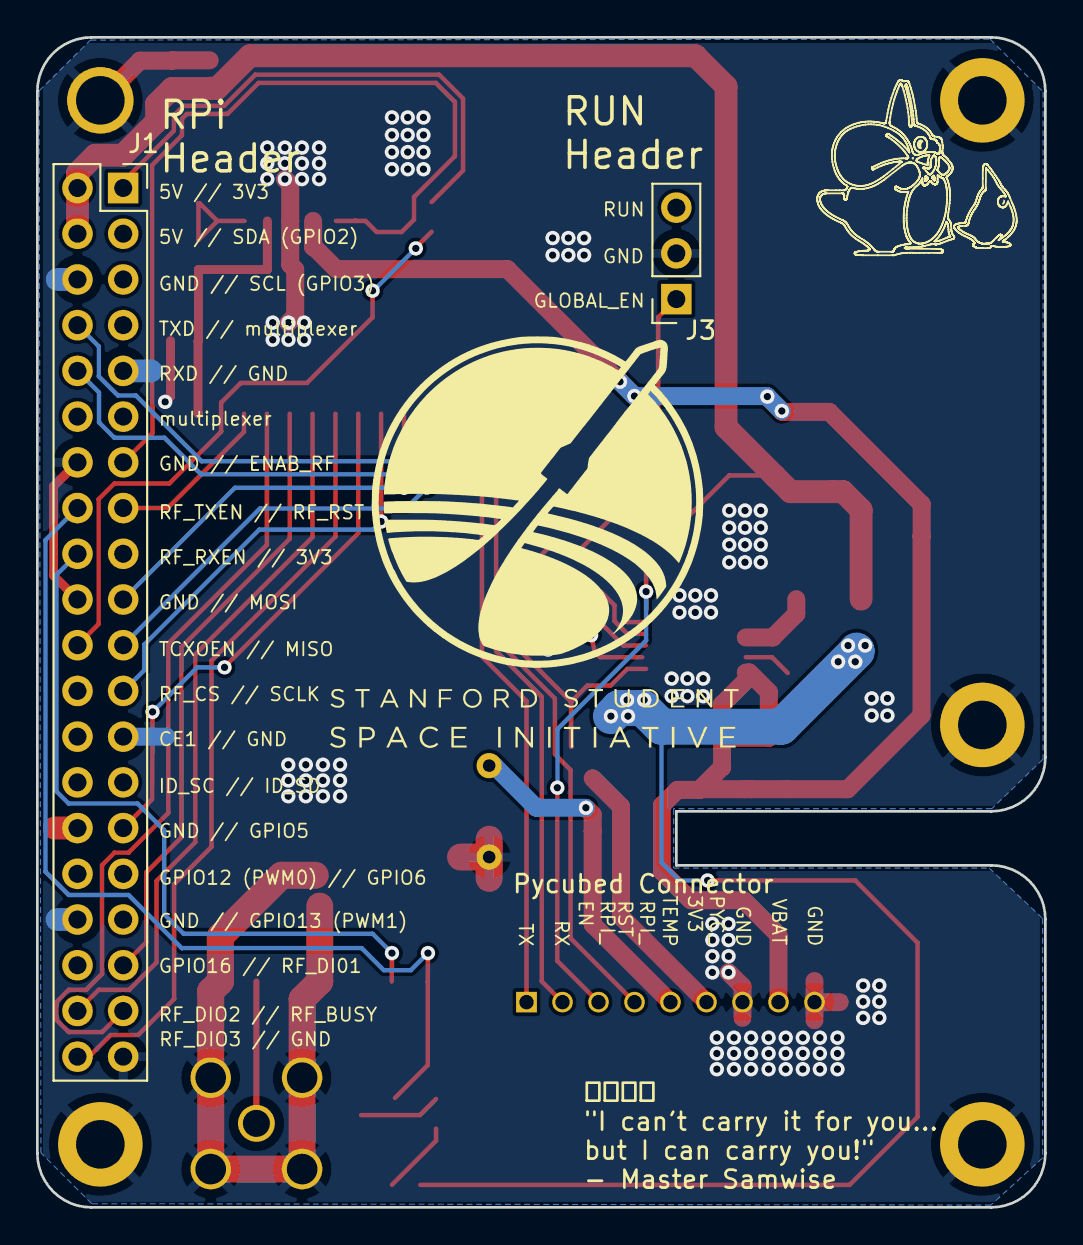
[picture p51: board RPi_interface.kicad_pcb from below]

Board: 4 copper layers, 56.0 x 65.0 mm, 43 parts (2 on the bottom side), 35 nets.

Parts:
C1, C2: 22uF; C_0603_1608Metric
C3, C4: 10uF; C_1210_3225Metric
C5, C10, C13: 0.1uF; C_0603_1608Metric
C6: 3.3nF; C_0603_1608Metric
C7: 1uF; C_0603_1608Metric
C8, C9, C12, C14: 10uF; C_0603_1608Metric
C11: 22pF; C_0603_1608Metric
D1: LTST-C191KGKT; LED_0603_1608Metric
H1, H2, H3, H4, H5: MountingHole_Pad; MountingHole_2.7mm_M2.5_DIN965_Pad
J1: PRT-21570
J2: 353620950
J3: Conn_01x03; PinSocket_1x03_P2.54mm_Vertical
J4: Amphenol_901-144; SMA_901-144
L1: 3.3uH; L_2141
Q1, Q2: IRLML2803; SOT-23
R1: 200k, RN73H2BTTD2003A05; R_1206_3216Metric
R2: 330K; R_0603_1608Metric
R3: 121K; R_0603_1608Metric
R4: 22.1K; R_0603_1608Metric
R5: 100K; R_0603_1608Metric
R6, R8, R9, R11, R12: 10K; R_0603_1608Metric
R7: 3.3K; R_0603_1608Metric
R10: 330; R_0603_1608Metric
TH1: TTDO-10KC8-3-1%; R_Axial_DIN0204_L3.6mm_D1.6mm_P5.08mm_Horizontal
U1: TPS54426PWPR; PWP14_2P31X2P46-L
U2: LORA1280F27-TCXO; LORA128XF27
U3: TPS7A4501DCQT

Connections:
5V: C1.2, C2.2, C11.1, C12.1, C13.1, D1.2 (A), J1.2, J1.4, L1.2, R3.2, R8.1, U1.1 (VO)
+3V3: J1.1, R12.1
ENAB_RF: J1.13, R11.1, U3.1 (~SHDN)
ENAB_RPI: J2.3, R2.2, U1.7 (EN)
GND: C1.1, C2.1, C3.2, C4.2, C6.2, C7.2, C8.1, C9.2, C10.2, C12.2, C13.2, C14.1, H1.1, H2.1, H3.1, H4.1, H5.1, J1.6, J1.9, J1.14, J1.20, J1.25, J1.30, J1.34, J1.39, J2.7, J2.9, J3.2, J4.2 (Ext), Q1.2 (S), Q2.2 (S), R2.1, R4.1, R7.2, R9.2, R11.2, TH1.2, U1.5 (GND), U1.8 (PGND1), U1.9 (PGND2), U1.15 (EPAD), U2.12 (GND), U2.15 (GND), U2.16 (GND), U2.18 (GND), U2.19 (GND), U3.3 (GND_1), U3.6 (GND_2)
MISO: J1.21, U2.11 (MISO)
MOSI: J1.19, U2.10 (MOSI)
unnamed: D1.1 (K), R10.1
unnamed: J3.1, Q1.3 (D), R8.2
unnamed: J4.1 (In), U2.17 (ANT)
unnamed: Q2.3 (D), R10.2
unnamed: R5.1, U1.6 (PG)
unnamed: C6.1, U1.4 (SS)
unnamed: C5.1, L1.1, U1.10 (SW1), U1.11 (SW2)
unnamed: C5.2, U1.12 (VBST)
unnamed: C11.2, R3.1, R4.2, U1.2 (VFB)
unnamed: C7.1, R5.2, U1.3 (VREG5)
unnamed: R6.2, R7.1, U3.5 (SENSE/ADJ)
PYCUBED_3V3: J2.6, R1.1
PyCubed_AIN4: J2.5, R1.2, TH1.1
RF_BUSY: J1.37, U2.4 (BUSY)
RF_CS: J1.29, U2.8 (NSS)
RF_IO1: J1.35, U2.5 (DIO1)
RF_IO2: J1.38, U2.6 (DIO2)
RF_IO3: J1.40, U2.7 (DIO3)
RF_RST: J1.15, U2.3 (NRESET)
RF_RX_EN: J1.18, U2.14 (RXEN)
RF_TX_EN: J1.16, Q2.1 (G), U2.13 (TXEN)
RPI_RST: J2.4, Q1.1 (G), R9.1
RX: J1.10, J2.2
SCLK: J1.23, U2.9 (SCK)
TCXO_EN: J1.22, R12.2, U2.2 (TCXOEN)
TX: J1.8, J2.1
VBATT: C3.1, C4.1, C14.2, J2.8, U1.13 (VIN1), U1.14 (VIN2), U3.2 (IN)
V_RF: C8.2, C9.1, C10.1, R6.1, U2.1 (VCC), U3.4 (OUT)
