pete4radio/SAMWISE-1-1-HW-Training/new_X_Y_Panels/new_X_Y_Panels.kicad_pcb

## KiCad design new_X_Y_Panels/new_X_Y_Panels.kicad_pcb (2024-05-09)

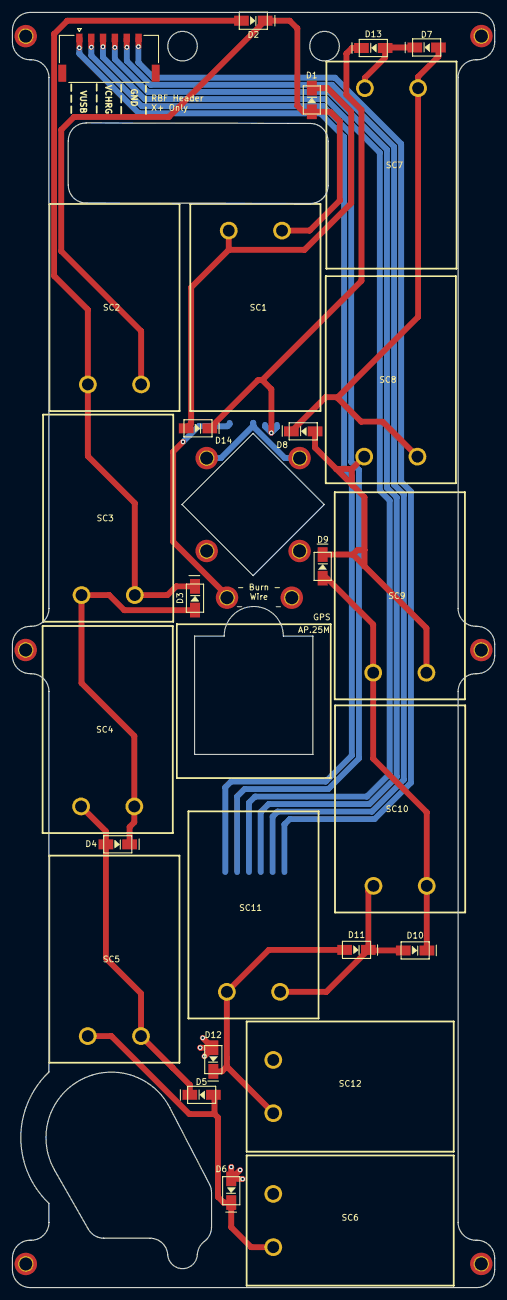
[picture p52: board new_X_Y_Panels.kicad_pcb from above]

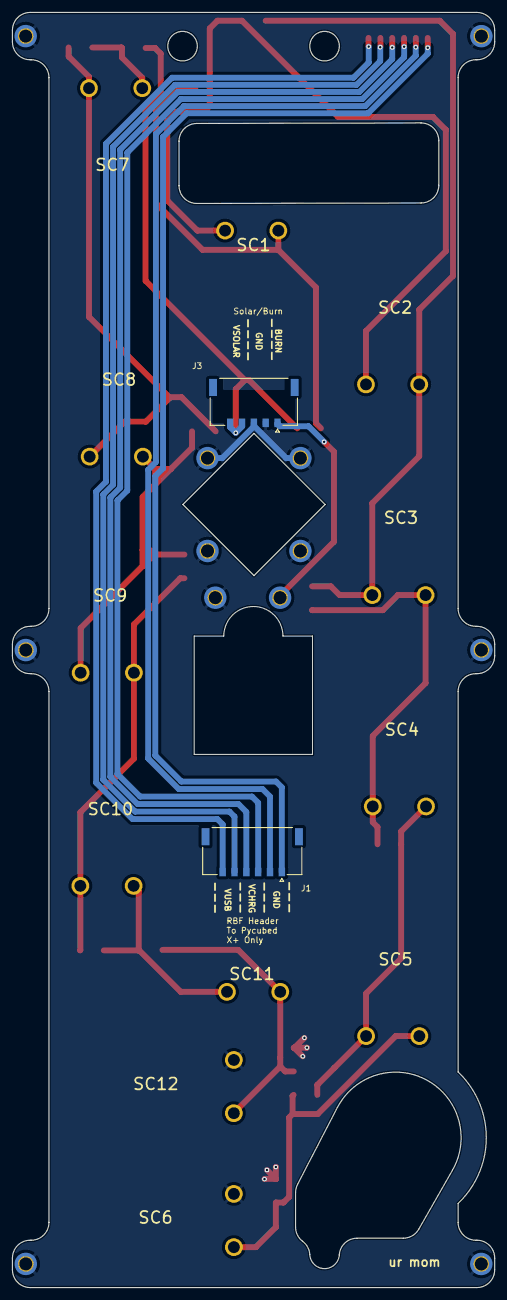
[picture p53: board new_X_Y_Panels.kicad_pcb from below]

Board: 2 copper layers, 81.5 x 215.5 mm, 42 parts (2 on the bottom side), 21 nets.

Parts:
ANT1: AP.25M
D1, D2, D3, D4, D5, D6, D7, D8, D9, D10, D11, D12, D13, D14: CDBA240LL; DO-214AC
H1, H2, H3, H4, H5, H6, H7, H8, H9, H10, H11, H12: MountingHole_Pad; MountingHole_2.2mm_M2_DIN965_Pad_TopBottom
J1, J2: 2053380006; MOLEX_2053380006
J3: 2053380005; MOLEX_2053380005
SC1, SC2, SC3, SC4, SC5, SC6, SC7, SC8, SC9, SC10, SC11, SC12: SM101K07TF

Connections:
/PYCUBED_GND: J1.5, J2.5
/PYCUBED_GNDREF: J1.6, J2.6
/VBATT: J1.4, J2.4
/VCHRG: J1.3, J2.3
/VUSB_BATT: J1.2, J2.2
/VUSB_OUT: J1.1, J2.1
BURN: H1.1, J3.1
GND: D6.2 (A), D12.2 (A), H2.1, H3.1, H4.1, H5.1, H6.1, H7.1, H8.1, H9.1, H10.1, H11.1, H12.1, J3.2, J3.3, SC6.2 (-), SC12.2 (-)
unnamed: D1.2 (A), D2.1 (K), SC1.2 (-), SC2.1 (+)
unnamed: D1.1 (K), D14.2 (A), SC1.1 (+)
unnamed: D2.2 (A), D3.1 (K), SC2.2 (-), SC3.1 (+)
unnamed: D3.2 (A), D4.1 (K), SC3.2 (-), SC4.1 (+)
unnamed: D4.2 (A), D5.1 (K), SC4.2 (-), SC5.1 (+)
unnamed: D5.2 (A), D6.1 (K), SC5.2 (-), SC6.1 (+)
unnamed: D7.2 (A), D8.1 (K), SC7.2 (-), SC8.1 (+)
unnamed: D8.2 (A), D9.1 (K), SC8.2 (-), SC9.1 (+)
unnamed: D10.2 (A), D11.1 (K), SC10.2 (-), SC11.1 (+)
unnamed: D9.2 (A), D10.1 (K), SC9.2 (-), SC10.1 (+)
unnamed: D11.2 (A), D12.1 (K), SC11.2 (-), SC12.1 (+)
unnamed: D7.1 (K), D13.2 (A), SC7.1 (+)
VSOLAR: D13.1 (K), D14.1 (K), J3.4, J3.5
