pete4radio/SAMWISE-1-1-HW-Training/Z_Panels/Z_Panels.kicad_pcb

## KiCad design Z_Panels/Z_Panels.kicad_pcb (2024-05-09)

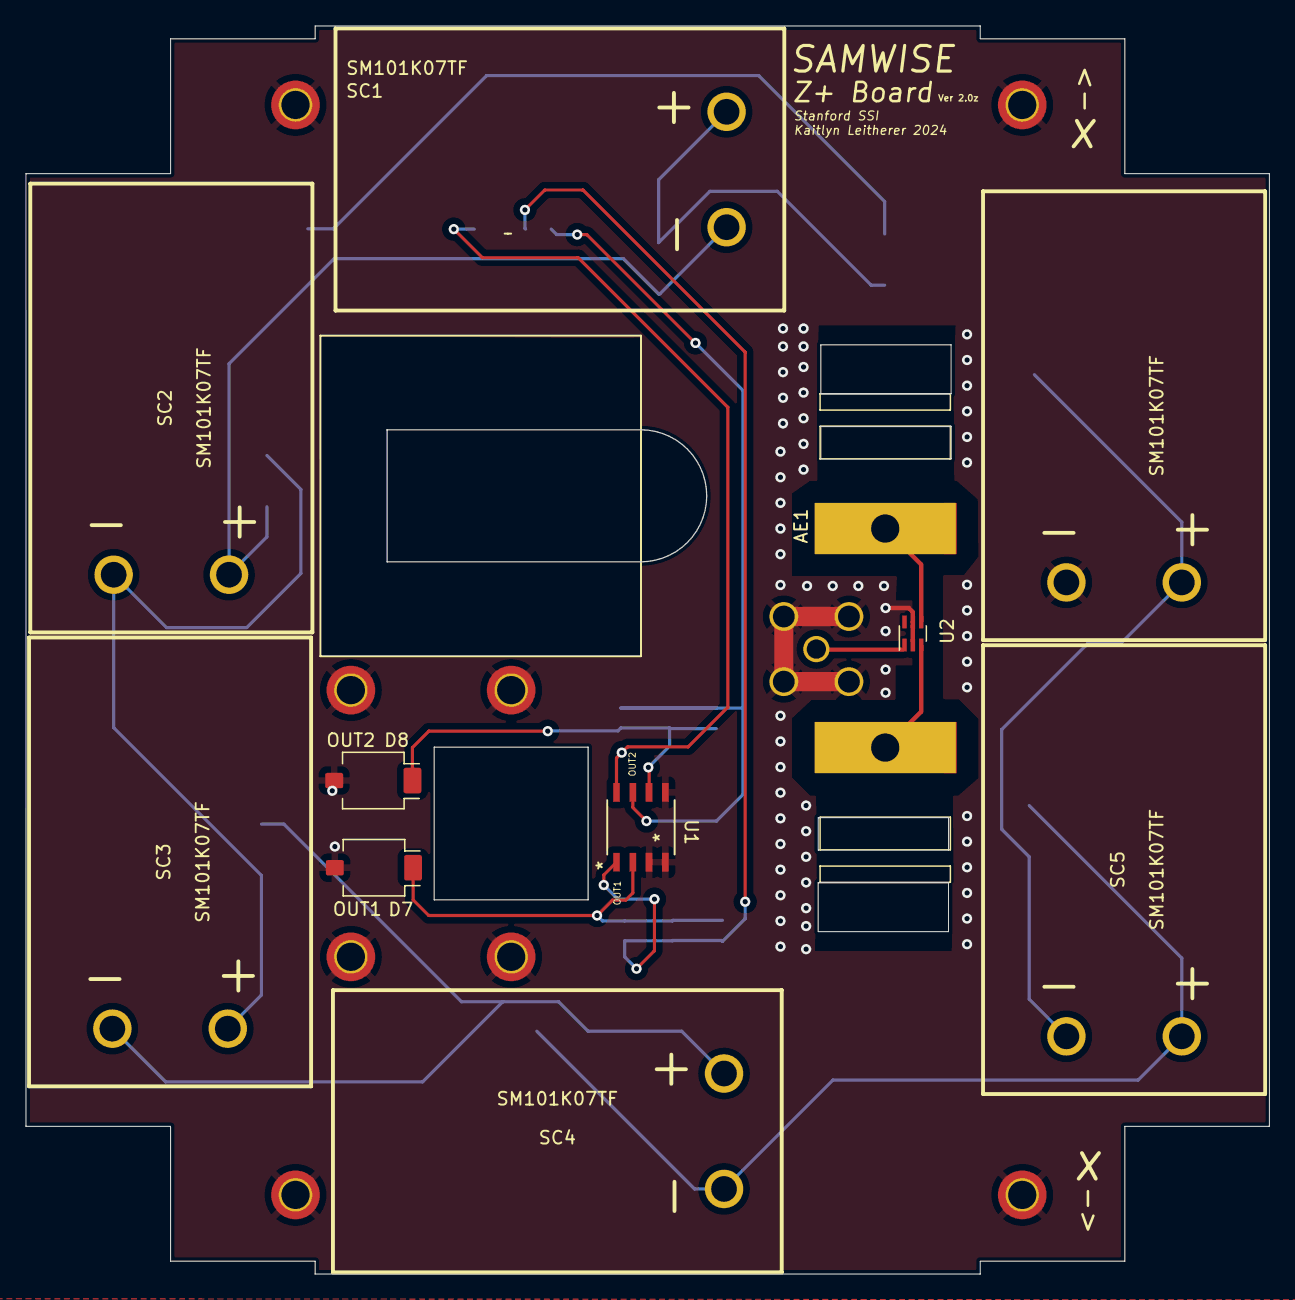
[picture p54: board Z_Panels.kicad_pcb from above]

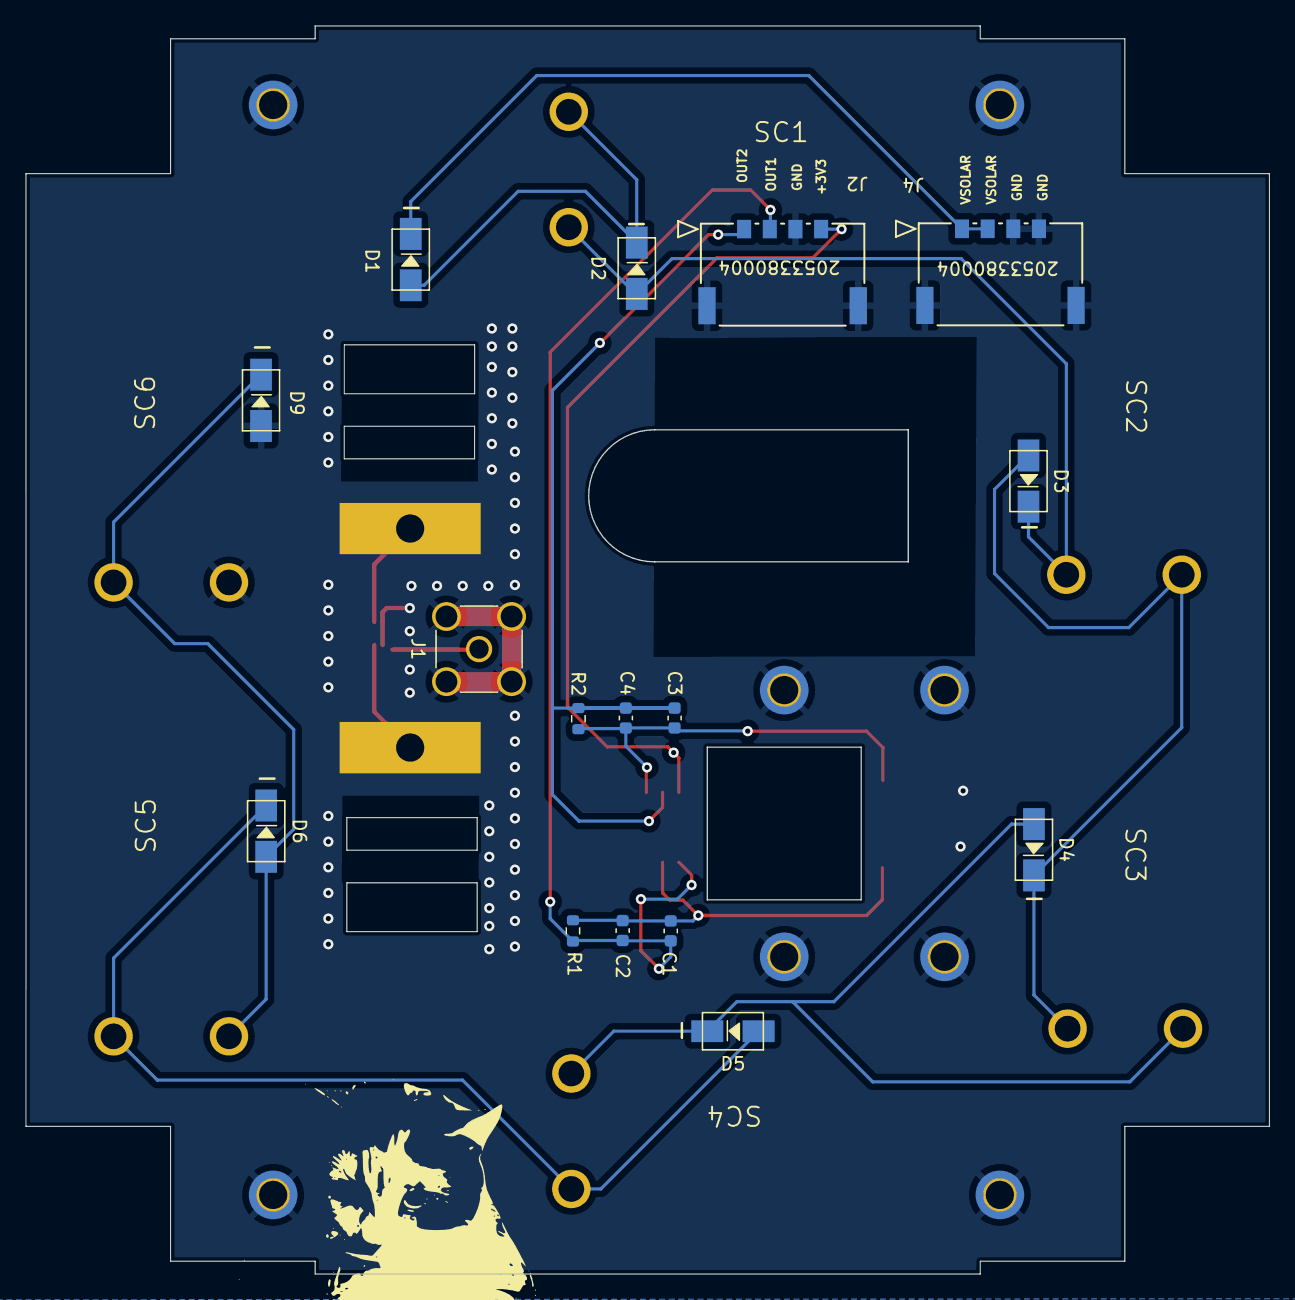
[picture p55: board Z_Panels.kicad_pcb from below]

Board: 4 copper layers, 97.0 x 97.3 mm, 35 parts (16 on the bottom side), 16 nets.

Parts:
AE1: UHF_Dipole_Antenna; UHF_Dipole_Antenna_Mount
C1, C3: 1nF; C_0603_1608Metric
C2, C4: 100nF; C_0603_1608Metric
D1, D2, D3, D4, D5, D6, D9: CDBA240LL; DO-214AC
D7, D8: SFH2430; Osram_SFH2430
H1, H2, H3, H4, H5, H6, H7, H8: MountingHole_2.2mm_M2_DIN965_Pad_TopBottom
J1: SMA Connector Male; SMA_Amphenol_901-144_Vertical
J2, J4: Conn_01x04_MountingPin; CON_2053380004
R1, R2: 3.9k; R_0603_1608Metric
SC1, SC2, SC3, SC4, SC5, SC6: SM101K07TF
U1: LTC2051IS8_PBF; LTC2051HS8#PBF
U2: HHM1589D1

Connections:
+3V3: J2.4, U1.8 (V+)
/Photodiode 1/IN-: C1.1, C2.1, D7.1 (K), R1.1, U1.2 (-INA)
/Photodiode 2/IN-: C3.1, C4.1, D8.1 (K), R2.1, U1.6 (-INB)
GND: D7.2 (A), D8.2 (A), D9.2 (A), H1.1, H2.1, H3.1, H4.1, H5.1, H6.1, H7.1, H8.1, J1.2 (Ext), J2.3, J2.MP (MountPin), J4.3, J4.4, J4.MP (MountPin), SC6.2 (-), U1.3 (+INA), U1.4 (V-), U1.5 (+INB), U2.2 (GND), U2.5 (GND)
unnamed: AE1.1, U2.3 (Balanced_Port)
unnamed: AE1.2, U2.4 (Balanced_Port)
unnamed: D1.2 (A), D2.1 (K), SC1.1 (+)
unnamed: D2.2 (A), D3.1 (K), SC1.2 (-), SC2.1 (+)
unnamed: D3.2 (A), D4.1 (K), SC2.2 (-), SC3.1 (+)
unnamed: D4.2 (A), D5.1 (K), SC3.2 (-), SC4.1 (+)
unnamed: D5.2 (A), D6.1 (K), SC4.2 (-), SC5.1 (+)
unnamed: D6.2 (A), D9.1 (K), SC5.2 (-), SC6.1 (+)
unnamed: J1.1 (In), U2.1 (UnBalanced_Port)
OUT1: C1.2, C2.2, J2.2, R1.2, U1.1 (OUTA)
OUT2: C3.2, C4.2, J2.1, R2.2, U1.7 (OUTB)
VSOLAR: D1.1 (K), J4.1, J4.2
