pete4radio/SAMWISE-1-1-HW-Training/FlexDeploySidePanels/FlexDeploySidePanels.kicad_pcb

## KiCad design FlexDeploySidePanels/FlexDeploySidePanels.kicad_pcb (2024-05-09)

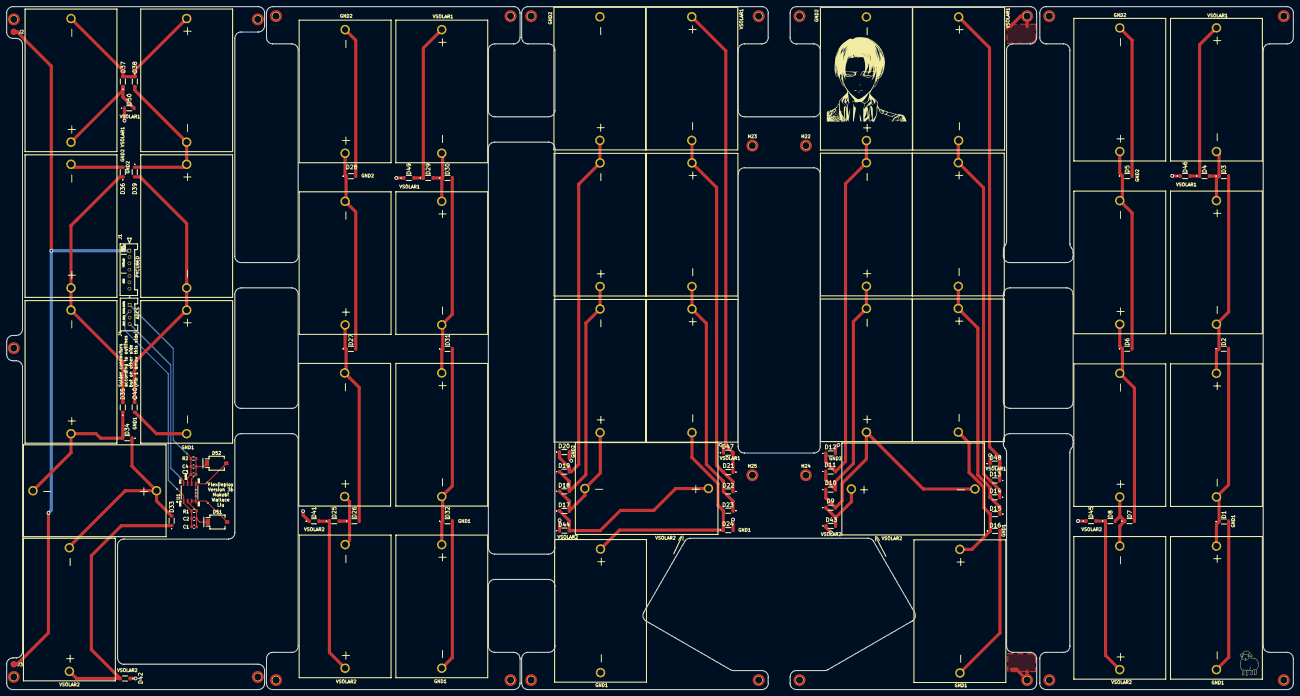
[picture p56: board FlexDeploySidePanels.kicad_pcb from above]

Board: 4 copper layers, 406.0 x 215.5 mm, 128 parts (0 on the bottom side), 48 nets.

Parts:
C1, C3: 1nF; C_0603_1608Metric
C2, C4: 100nF; C_0603_1608Metric
D1, D2, D3, D4, D5, D6, D7, D8, D9, D10, D11, D12, D13, D14, D15, D16, D17, D18, D19, D20, D21, D22, D23, D24, D25, D26, D27, D28, D29, D30, D31, D32, D33, D34, D35, D36, D37, D38, D39, D40, D41, D42, D43, D44, D45, D46, D47, D48, D49, D50: RB160MM-60TR; RB160MM60TR
D51, D52: SFH2430; Osram_SFH2430
H1, H2, H3, H4, H5, H6, H7, H8, H9, H10, H11, H12, H13, H14, H15, H16, H17, H18, H19, H20, H21, H22, H23, H24, H25: MountingHole_Pad; MountingHole_2.2mm_M2_DIN965_Pad_TopBottom
J1: 353620750; CON_353620750
J2, J3: 0900-3-15-20-75-14-11-0
J4: 353620450; MOLEX_35362-0450
R1, R2: 3.9k; R_0603_1608Metric
SC1, SC2, SC3, SC4, SC5, SC6, SC7, SC8, SC9, SC10, SC11, SC12, SC13, SC14, SC15, SC16, SC17, SC18, SC19, SC20, SC21, SC22, SC23, SC24, SC25, SC26, SC27, SC28, SC29, SC30, SC31, SC32, SC33, SC34, SC35, SC36, SC37, SC38, SC39, SC40: SM141K08TFV
U1: LTC2051IS8_PBF; LTC2051HS8#PBF

Connections:
+3V3: J4.4, U1.8 (V+)
/Photodiode 1/IN-: C1.1, C2.1, D51.1 (K), R1.1, U1.2 (-INA)
/Photodiode 2/IN-: C3.1, C4.1, D52.1 (K), R2.1, U1.6 (-INB)
DEP SENSE: J1.1, J2.1, J3.1
GND: D1.2 (A), D5.2 (A), D12.2 (A), D16.2 (A), D20.2 (A), D24.2 (A), D28.2 (A), D32.2 (A), D36.2 (A), D40.2 (A), D51.2 (A), D52.2 (A), H1.1, H2.1, H3.1, H4.1, H5.1, H6.1, H7.1, H8.1, H9.1, H10.1, H11.1, H12.1, H13.1, H14.1, H15.1, H16.1, H17.1, H18.1, H19.1, H20.1, H21.1, H22.1, H23.1, H24.1, H25.1, J1.5, J1.6, J1.7, J4.3, SC1.0 (-), SC5.0 (-), SC12.0 (-), SC16.0 (-), SC20.0 (-), SC24.0 (-), SC28.0 (-), SC32.0 (-), SC36.0 (-), SC40.0 (-), U1.3 (+INA), U1.4 (V-), U1.5 (+INB)
unnamed: D1.1 (C), D2.2 (A), SC1.1 (+), SC2.0 (-)
unnamed: D2.1 (C), D3.2 (A), SC2.1 (+), SC3.0 (-)
unnamed: D3.1 (C), D4.2 (A), SC3.1 (+), SC4.0 (-)
unnamed: D4.1 (C), D46.2 (A), SC4.1 (+)
unnamed: D5.1 (C), D6.2 (A), SC5.1 (+), SC6.0 (-)
unnamed: D6.1 (C), D7.2 (A), SC6.1 (+), SC7.0 (-)
unnamed: D7.1 (C), D8.2 (A), SC7.1 (+), SC8.0 (-)
unnamed: D10.2 (A), D11.1 (C), SC10.0 (-), SC11.1 (+)
unnamed: D9.2 (A), D10.1 (C), SC9.0 (-), SC10.1 (+)
unnamed: D11.2 (A), D12.1 (C), SC11.0 (-), SC12.1 (+)
unnamed: D13.2 (A), D14.1 (C), SC13.0 (-), SC14.1 (+)
unnamed: D13.1 (C), D48.2 (A), SC13.1 (+)
unnamed: D14.2 (A), D15.1 (C), SC14.0 (-), SC15.1 (+)
unnamed: D15.2 (A), D16.1 (C), SC15.0 (-), SC16.1 (+)
unnamed: D17.2 (A), D18.1 (C), SC17.0 (-), SC18.1 (+)
unnamed: D17.1 (C), D44.2 (A), SC17.1 (+)
unnamed: D18.2 (A), D19.1 (C), SC18.0 (-), SC19.1 (+)
unnamed: D19.2 (A), D20.1 (C), SC19.0 (-), SC20.1 (+)
unnamed: D21.2 (A), D22.1 (C), SC21.0 (-), SC22.1 (+)
unnamed: D21.1 (C), D47.2 (A), SC21.1 (+)
unnamed: D22.2 (A), D23.1 (C), SC22.0 (-), SC23.1 (+)
unnamed: D23.2 (A), D24.1 (C), SC23.0 (-), SC24.1 (+)
unnamed: D25.2 (A), D26.1 (C), SC25.0 (-), SC26.1 (+)
unnamed: D25.1 (C), D41.2 (A), SC25.1 (+)
unnamed: D26.2 (A), D27.1 (C), SC26.0 (-), SC27.1 (+)
unnamed: D27.2 (A), D28.1 (C), SC27.0 (-), SC28.1 (+)
unnamed: D29.2 (A), D30.1 (C), SC29.0 (-), SC30.1 (+)
unnamed: D29.1 (C), D49.2 (A), SC29.1 (+)
unnamed: D30.2 (A), D31.1 (C), SC30.0 (-), SC31.1 (+)
unnamed: D31.2 (A), D32.1 (C), SC31.0 (-), SC32.1 (+)
unnamed: D33.2 (A), D34.1 (C), SC33.0 (-), SC34.1 (+)
unnamed: D33.1 (C), D42.2 (A), SC33.1 (+)
unnamed: D34.2 (A), D35.1 (C), SC34.0 (-), SC35.1 (+)
unnamed: D35.2 (A), D36.1 (C), SC35.0 (-), SC36.1 (+)
unnamed: D37.2 (A), D38.1 (C), SC37.0 (-), SC38.1 (+)
unnamed: D37.1 (C), D50.2 (A), SC37.1 (+)
unnamed: D38.2 (A), D39.1 (C), SC38.0 (-), SC39.1 (+)
unnamed: D39.2 (A), D40.1 (C), SC39.0 (-), SC40.1 (+)
unnamed: D9.1 (C), D43.2 (A), SC9.1 (+)
unnamed: D8.1 (C), D45.2 (A), SC8.1 (+)
OUT1: C1.2, C2.2, J4.2, R1.2, U1.1 (OUTA)
OUT2: C3.2, C4.2, J4.1, R2.2, U1.7 (OUTB)
VSOLAR: D41.1 (C), D42.1 (C), D43.1 (C), D44.1 (C), D45.1 (C), D46.1 (C), D47.1 (C), D48.1 (C), D49.1 (C), D50.1 (C), J1.2, J1.3, J1.4
