pete4radio/SAMWISE-1-1-HW-Training/New_universal_XY_MagTorq/New_Coil_Panel_Y.kicad_pcb

## KiCad design New_universal_XY_MagTorq/New_Coil_Panel_Y.kicad_pcb (2024-05-09)

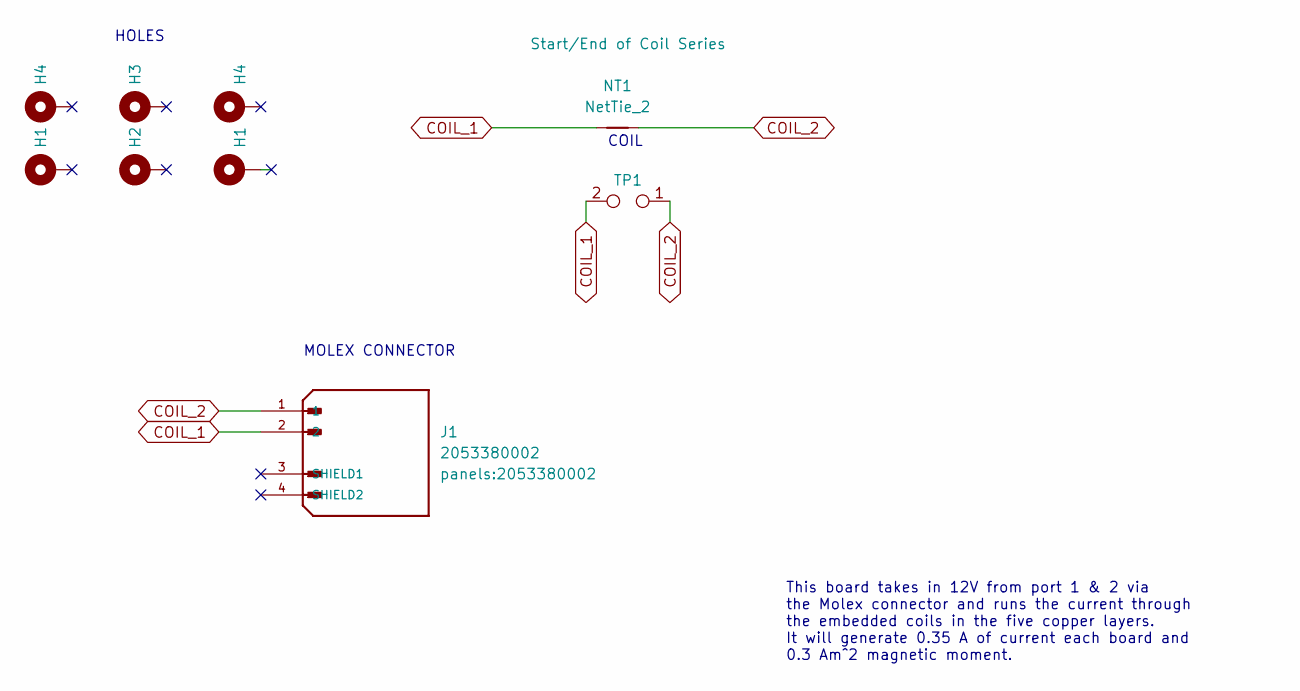
[picture p57: schematic New_Coil_Panel_Y.kicad_sch, Magnemite]

Parts:
H1, H2, H3, H4: MountingHole_2.2mm_M2_DIN965_Pad_TopBottom
J1: 2053380002; PARTREV B
NT1: NetTie_2; NetTie-2_SMD_Pad0.5mm
TP1: Start/End of Coil Series; TestPointConnection

Connections:
COIL_1: J1.2, NT1.1, TP1.2
COIL_2: J1.1, NT1.2, TP1.1

Notes on the sheet:
MOLEX CONNECTOR
This board takes in 12V from port 1 & 2 via the Molex connector and runs the current through the embedded coils in the five copper layers. It will generate 0.35 A of current each board and 0.3 Am^2 magnetic moment.
COIL
HOLES

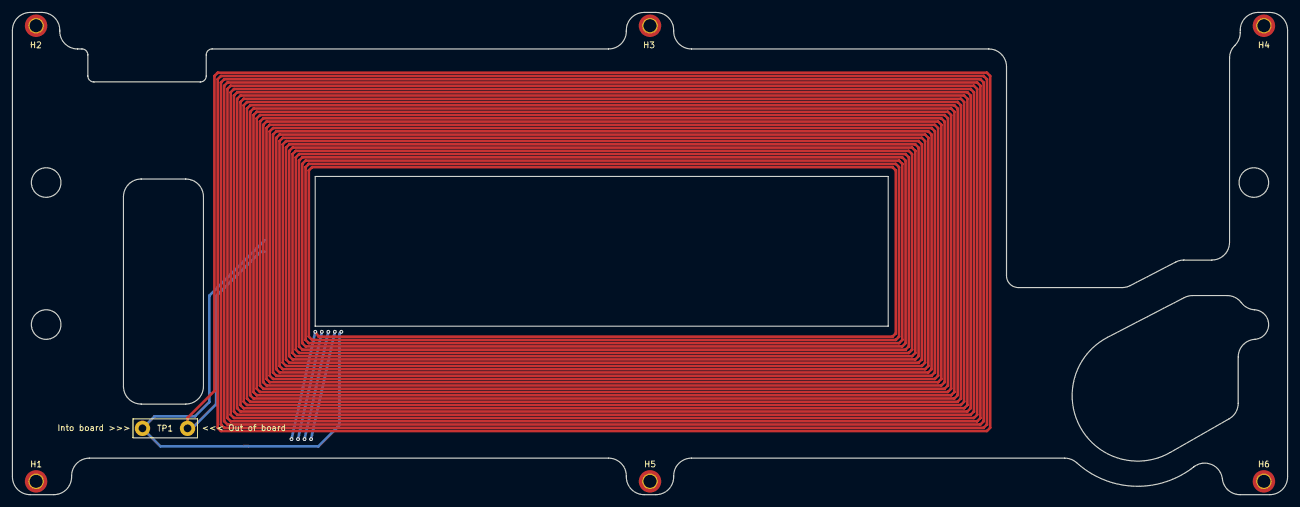
[picture p58: board New_Coil_Panel_Y.kicad_pcb from above]

Board: 6 copper layers, 215.5 x 81.5 mm, 9 parts (1 on the bottom side), 2 nets.

Other parts of the board:
H5, H6: MountingHole_2.2mm_M2_DIN965_Pad_TopBottom
