pete4radio/SAMWISE-1-1-HW-Training/RPI Feather Adapter/kfw_rpi_adapter.kicad_pcb

## KiCad design RPI Feather Adapter/kfw_rpi_adapter.kicad_pcb (2024-05-09)

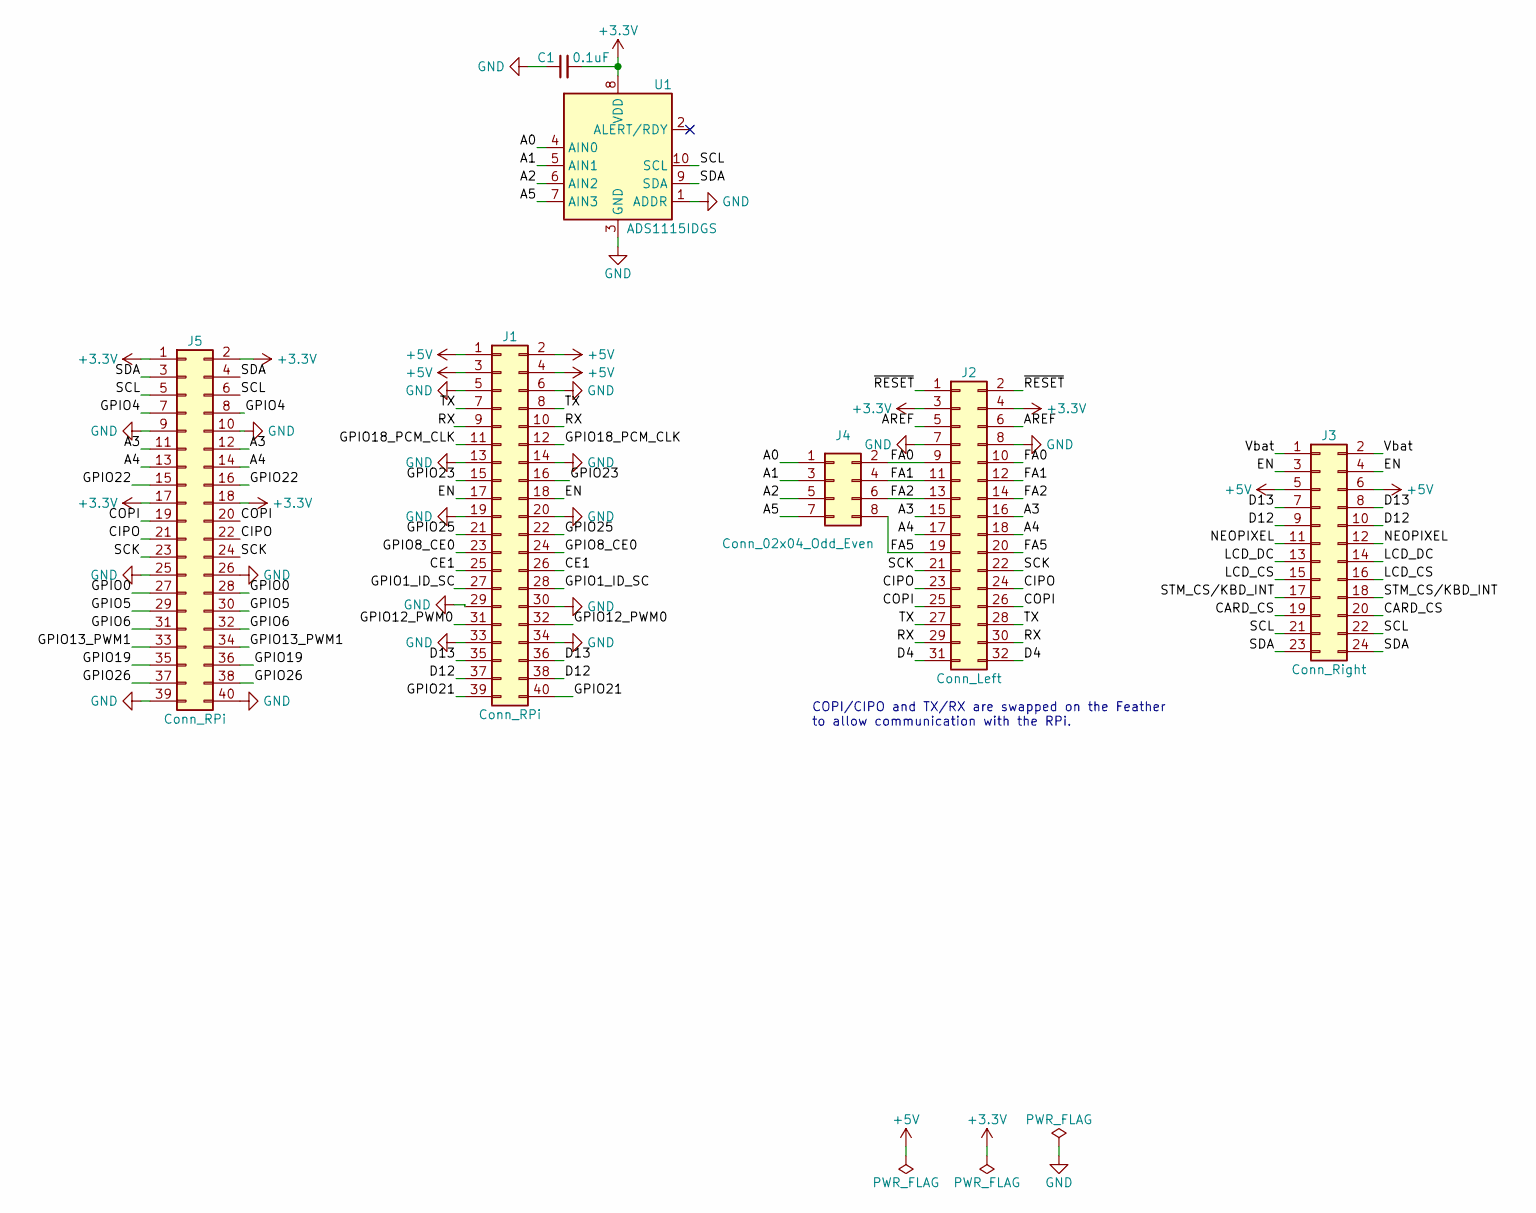
[picture p59: schematic kfw_rpi_adapter.kicad_sch, RPi Feather Adapter with A/D]

Parts:
C1: 0.1uF; C_0603_1608Metric
J1, J5: Conn_RPi; PinHeader_2x20_P2.54mm_Vertical
J2: Conn_Left; PinHeader_2x16_P2.54mm_Vertical
J3: Conn_Right; PinHeader_2x12_P2.54mm_Vertical
J4: Conn_02x04_Odd_Even; PinHeader_2x04_P2.54mm_Vertical
U1: ADS1115IDGS; TSSOP-10_3x3mm_P0.5mm

Connections:
+3V3: C1.2, J2.3, J2.4, J5.1, J5.2, J5.17, J5.18, U1.8 (VDD)
+5V: J1.1, J1.2, J1.3, J1.4, J3.5, J3.6
/A0: J4.1, U1.4 (AIN0)
/A1: J4.3, U1.5 (AIN1)
/A2: J4.5, U1.6 (AIN2)
/A3: J2.15, J2.16, J5.11, J5.12
/A4: J2.17, J2.18, J5.13, J5.14
/A5: J4.7, U1.7 (AIN3)
/AREF: J2.5, J2.6
/CARD_CS: J3.19, J3.20
/CE1: J1.25, J1.26; also elsewhere on the board
/CIPO: J2.23, J2.24, J5.21, J5.22
/COPI: J2.25, J2.26, J5.19, J5.20
/D4: J2.31, J2.32
/D12: J1.37, J1.38, J3.9, J3.10
/D13: J1.35, J1.36, J3.7, J3.8
/EN: J1.17, J1.18, J3.3, J3.4
/FA0: J2.9, J2.10, J4.2
/FA1: J2.11, J2.12, J4.4
/FA2: J2.13, J2.14, J4.6
/FA5: J2.19, J2.20, J4.8
/GPIO0: J5.27, J5.28
/GPIO1_ID_SC: J1.27, J1.28
/GPIO4: J5.7, J5.8; also elsewhere on the board
/GPIO5: J5.29, J5.30
/GPIO6: J5.31, J5.32
/GPIO8_CE0: J1.23, J1.24
/GPIO12_PWM0: J1.31, J1.32
/GPIO13_PWM1: J5.33, J5.34
/GPIO18_PCM_CLK: J1.11, J1.12
/GPIO19: J5.35, J5.36
/GPIO21: J1.39, J1.40
/GPIO22: J5.15, J5.16
/GPIO23: J1.15, J1.16
/GPIO25: J1.21, J1.22
/GPIO26: J5.37, J5.38
/LCD_CS: J3.15, J3.16
/LCD_DC: J3.13, J3.14
/NEOPIXEL: J3.11, J3.12
/RX: J1.9, J1.10, J2.29, J2.30
/SCK: J2.21, J2.22, J5.23, J5.24
/SCL: J3.21, J3.22, J5.5, J5.6, U1.10 (SCL)
/SDA: J3.23, J3.24, J5.3, J5.4, U1.9 (SDA)
/STM_CS/KBD_INT: J3.17, J3.18; also elsewhere on the board
/TX: J1.7, J1.8, J2.27, J2.28
/Vbat: J3.1, J3.2
/~RESET: J2.1, J2.2
GND: C1.1, J1.5, J1.6, J1.13, J1.14, J1.19, J1.20, J1.29, J1.30, J1.33, J1.34, J2.7, J2.8, J5.9, J5.10, J5.25, J5.26, J5.39, J5.40, U1.1 (ADDR), U1.3 (GND)

Notes on the sheet:
COPI/CIPO and TX/RX are swapped on the Feather to allow communication with the RPi.

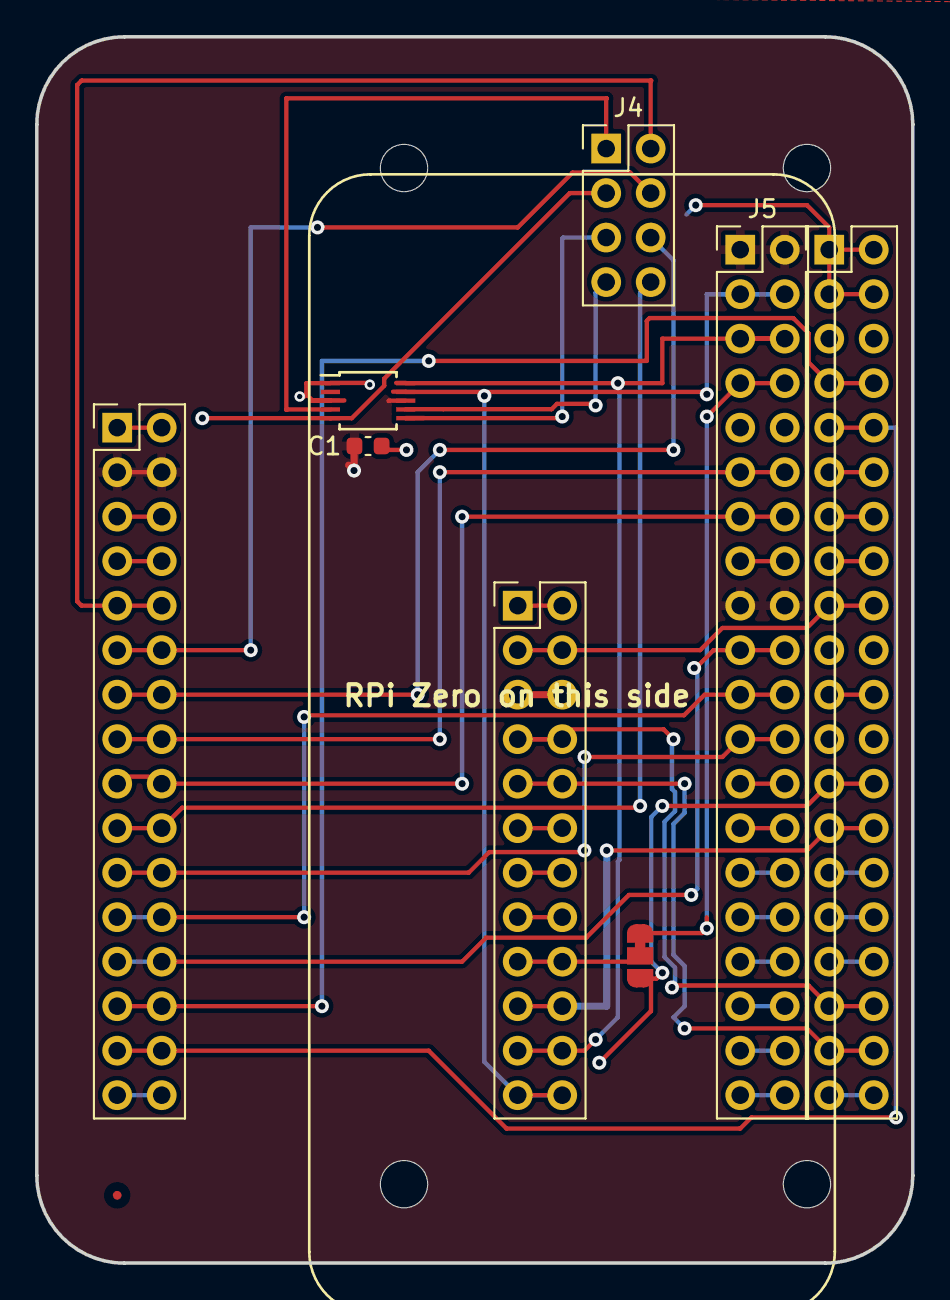
[picture p60: board kfw_rpi_adapter.kicad_pcb from above]

Board: 2 copper layers, 50.0 x 70.0 mm, 8 parts (0 on the bottom side), 48 nets.

Other parts of the board:
JP1: SJ_STM_KBD; SolderJumper-3_P1.3mm_Bridged12_RoundedPad1.0x1.5mm_NumberL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

Their connections:
/CE1: JP1.3 (B); also elsewhere on the board
/GPIO4: JP1.1 (A); also elsewhere on the board
/STM_CS/KBD_INT: JP1.2 (C); also elsewhere on the board
