pete4radio/SAMWISE-1-1-HW-Training/New Groundstation/New Groundstation.kicad_pcb

## KiCad design New Groundstation/New Groundstation.kicad_pcb (2024-05-09)

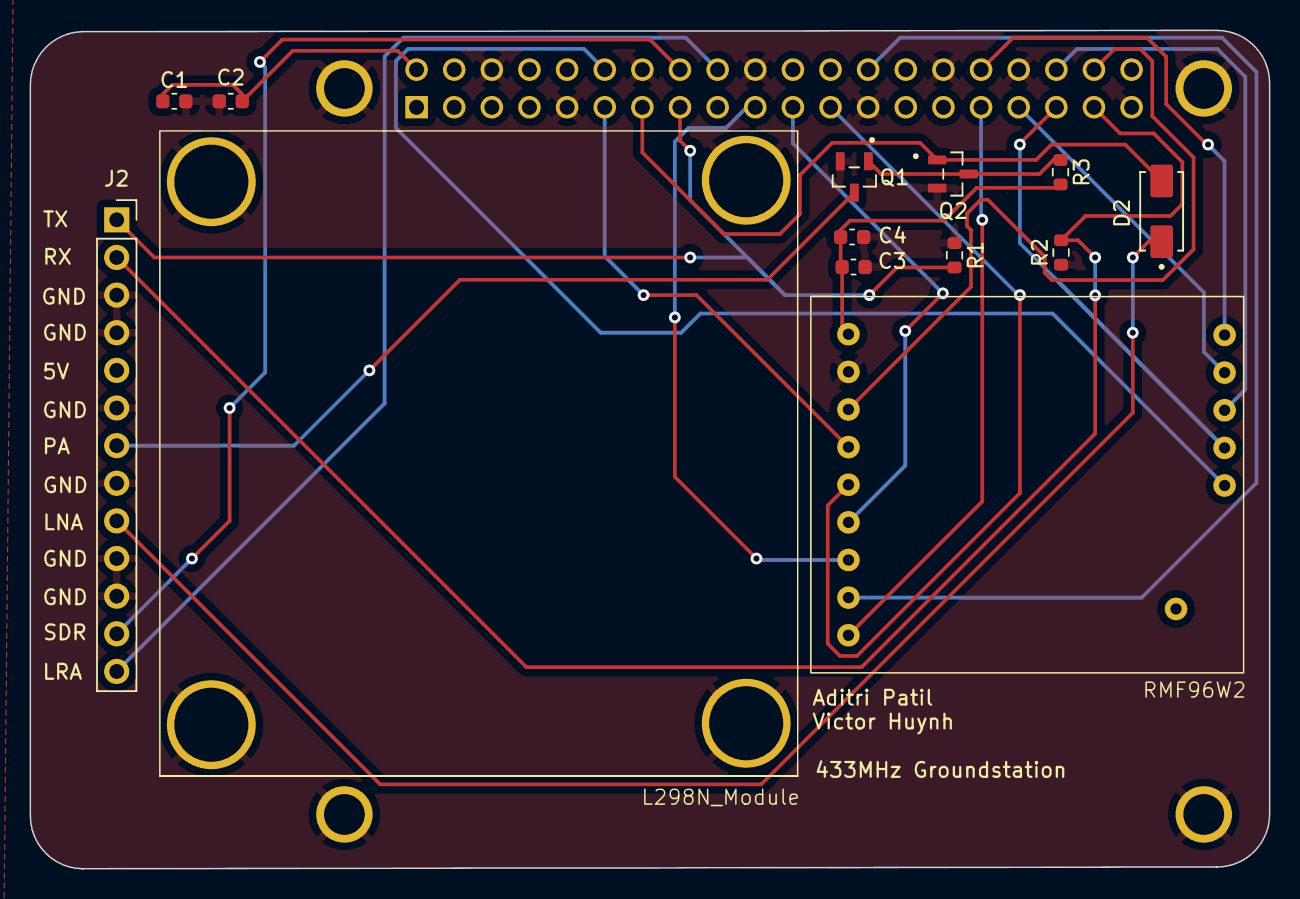
[picture p61: board New Groundstation.kicad_pcb from above]

Board: 4 copper layers, 83.6 x 56.6 mm, 14 parts (0 on the bottom side), 22 nets.

Parts:
C1, C3: 10uF; C_0603_1608Metric
C2, C4: 0.1uF; C_0603_1608Metric
D2: M7; DIOM505270X240
J2: Conn_01x13_Pin; PinSocket_1x13_P2.54mm_Vertical
L298N_Module: L298N_Module; H-bridge module
Q1, Q2: 2N7002; SOT95P240X111-3N
R1, R2: 10k; R_0603_1608Metric
R3: 100k; R_0603_1608Metric
RMF96W2: RFM96W1
U2: RASPBERRY_PI_4B_4GB; MODULE_RASPBERRY_PI_4B_4GB

Connections:
+5V: C1.1, C2.1, C3.1, C4.1, J2.5, R3.2, RMF96W2.1 (Vin), U2.2 (5V), U2.4 (5V)
/CS: RMF96W2.8 (CS), U2.26 (GPIO7/~SPI_CE1)
/DIO0: RMF96W2.4 (DIO0), U2.11 (GPIO17/GPIO_GEN0)
/DIO1: RMF96W2.10 (DIO1), U2.32 (GPIO12)
/DIO2: RMF96W2.11 (DIO2), U2.33 (GPIO13)
/DIO3: RMF96W2.12 (DIO3), U2.36 (GPIO16)
/DIO4: RMF96W2.13 (DIO4), U2.35 (GPIO19)
/DIO5: RMF96W2.14 (DIO5), U2.12 (GPIO18/GPIO_GEN1)
/MISO: RMF96W2.6 (MISO), U2.21 (GPIO9/SPI_MISO)
/MOSI: RMF96W2.7 (MOSI), U2.19 (GPIO10/SPI_MOSI)
/PTT_OUT: D2.A, Q2.1, U2.13 (GPIO27/GPIO_GEN2)
/RST: RMF96W2.9 (RST), U2.31 (GPIO6)
/SCK: RMF96W2.5 (SCK), U2.23 (GPIO11/SPI_SCLK)
/enable: RMF96W2.3 (EN), U2.38 (GPIO20)
GND: C1.2, C2.2, C3.2, C4.2, J2.3, J2.4, J2.6, J2.8, J2.10, J2.11, L298N_Module.4 (GND), Q1.2, Q2.2, R1.1, R2.1, RMF96W2.2 (GND), U2.6 (GND), U2.9 (GND), U2.14 (GND), U2.20 (GND), U2.25 (GND), U2.30 (GND), U2.34 (GND), U2.39 (GND), U2.S1 (SHIELD), U2.S2 (SHIELD), U2.S3 (SHIELD), U2.S4 (SHIELD)
LNA_PTT: D2.C, J2.9
LORA_CTRL: J2.13, U2.18 (GPIO24/GPIO_GEN5)
unnamed: Q1.1, Q2.3, R3.1
PA_PTT: J2.7, Q1.3
RX_CTRL: J2.2, R2.2, U2.37 (GPIO26)
SDR_CTRL: J2.12, U2.16 (GPIO23/GPIO_GEN4)
TX_CTRL: J2.1, R1.2, U2.15 (GPIO22/GPIO_GEN3)
