pete4radio/SAMWISE-1-1-HW-Training/LT8490-mezzanine/LT8490.kicad_pcb

## KiCad design LT8490-mezzanine/LT8490.kicad_pcb (2024-05-09)

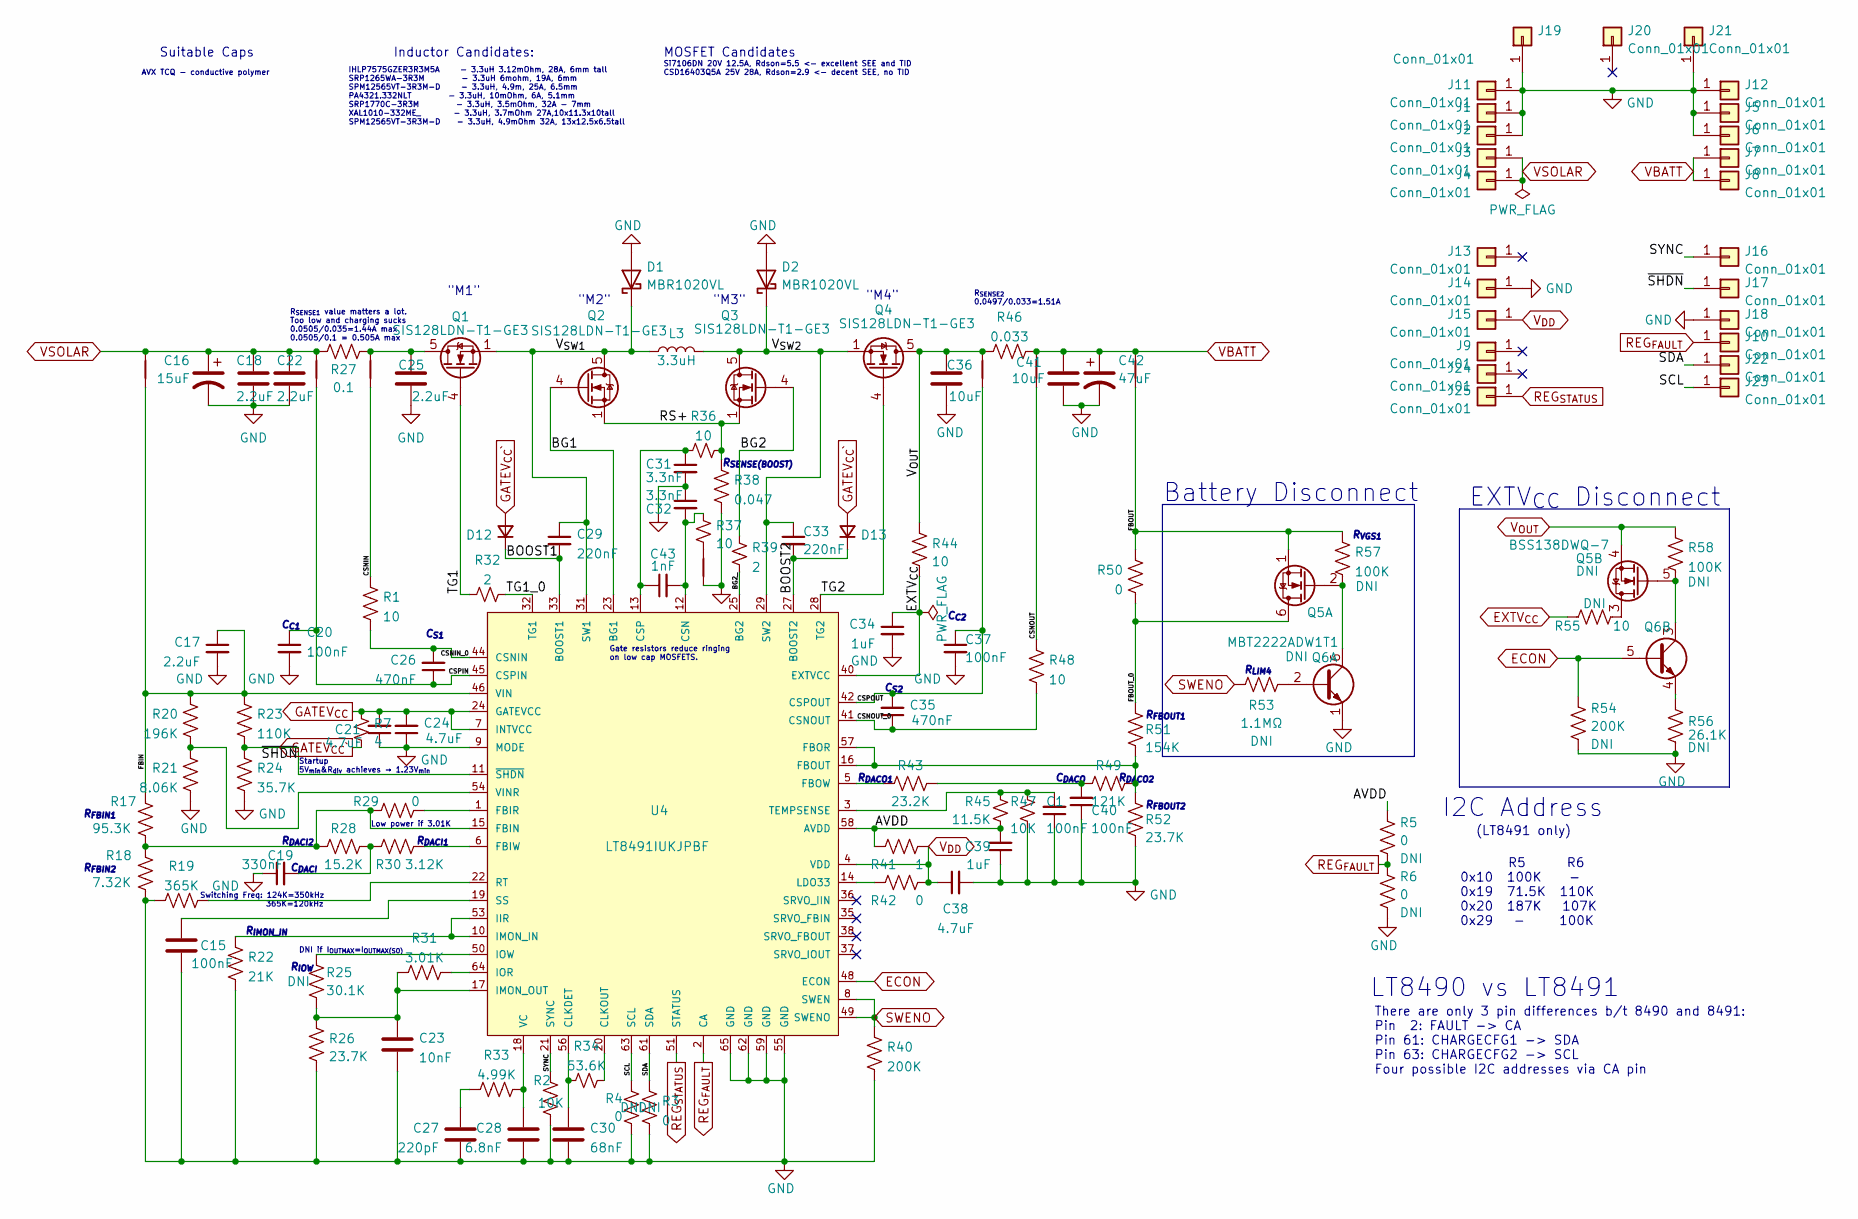
[picture p62: schematic LT8490.kicad_sch, LT8491 - Mezzanine]

Parts:
C1, C15, C20, C37, C40: 100nF; C_0603_1608Metric
C16: 15uF; CP_EIA-7343-30_AVX-N; Voltage 75V; Manufacturer_Part_Number TCQD336M016R0070E
C17, C18, C22, C25: 2.2uF; C_0805_2012Metric
C19: 330nF; C_0603_1608Metric
C21, C24, C38: 4.7uF; C_0603_1608Metric
C23: 10nF; C_0603_1608Metric
C26, C35: 470nF; C_0603_1608Metric
C27: 220pF; C_0603_1608Metric
C28: 6.8nF; C_0603_1608Metric
C29, C33: 220nF; C_0603_1608Metric
C30: 68nF; C_0603_1608Metric
C31, C32: 3.3nF; C_0603_1608Metric
C34, C39: 1uF; C_0603_1608Metric
C36, C41: 10uF; C_0805_2012Metric
C42: 47uF; CP_EIA-7343-30_AVX-N; Voltage 16V; Manufacturer_Part_Number TCQD476M016R0070E
C43: 1nF; C_0603_1608Metric
D1, D2: MBR1020VL; D_PowerDI-123
D12, D13: CMMR1U-02 TR; D_SOD-123F
J1, J2, J3, J4, J5, J6, J7, J8, J9, J10, J11, J12, J13, J14, J15, J16, J17, J18, J19, J20, J21, J22, J23, J24, J25: Conn_01x01; mppt_castellation_05mm
L3: 3.3uH; L_SRP1770C
NT1, NT2, NT3, NT4, NT5, NT6, NT7: NetTie_2; NetTie-2_SMD_Pad0.5mm
Q1, Q2, Q3, Q4: SIS128LDN-T1-GE3; Manufacturer_Part_Number SIS128LDN-T1-GE3
Q5: BSS138DWQ-7; Manufacturer_Part_Number BSS138DWQ-7; Mouser Part Number 621-BSS138DWQ-7
Q6: MBT2222ADW1T1; SOT-363_SC-70-6; Manufacturer_Part_Number MBT2222ADW1T1
R1, R36, R37, R44, R48, R55: 10; R_0603_1608Metric
R2, R47: 10K; R_0603_1608Metric
R3, R4, R29, R42, R50: 0; R_0603_1608Metric
R5, R6: 0; R_0402_1005Metric
R7: 4; R_0603_1608Metric
R17: 95.3K; R_0603_1608Metric
R18: 7.32K; R_0603_1608Metric
R19: 365K; R_0603_1608Metric
R20: 196K; R_0603_1608Metric
R21: 8.06K; R_0603_1608Metric
R22: 21K; R_0603_1608Metric
R23: 110K; R_0603_1608Metric
R24: 35.7K; R_0603_1608Metric
R25: 30.1K; R_0603_1608Metric
R26, R52: 23.7K; R_0603_1608Metric
R27: 0.1; R_1206_3216Metric
R28: 15.2K; R_0603_1608Metric
R30: 3.12K; R_0603_1608Metric
R31: 3.01K; R_0603_1608Metric
R32, R39: 2; R_0603_1608Metric
R33: 4.99K; R_0603_1608Metric
R34: 53.6K; R_0603_1608Metric
R38: 0.047; R_1206_3216Metric
R40, R54: 200K; R_0603_1608Metric
R41: 1; R_0603_1608Metric
R43: 23.2K; R_0603_1608Metric
R45: 11.5K; R_0603_1608Metric
R46: 0.033; R_1206_3216Metric
R49: 121K; R_0603_1608Metric
R51: 154K; R_0603_1608Metric
R53: 1.1MΩ; R_0603_1608Metric
R56: 26.1K; R_0603_1608Metric
R57, R58: 100K; R_0603_1608Metric
U4: LT8491IUKJPBF; LT8491IUKJ#PBF

Connections:
/AVDD: C39.2, R5.1, R41.2, R45.2, U4.58 (AVDD)
/BG1: Q2.4 (G), U4.23 (BG1)
/BG2: Q3.4 (G), R39.1
/BG2_: R39.2, U4.25 (BG2)
/BOOST1: C29.2, D12.1 (K), U4.33 (BOOST1)
/BOOST2: C33.2, D13.1 (K), U4.27 (BOOST2)
/CSNIN: NT3.1, R1.1
/CSNIN_0: C26.2, R1.2, U4.44 (CSNIN)
/CSNOUT: NT5.1, R48.1
/CSNOUT_0: C35.1, R48.2, U4.41 (CSNOUT)
/CSPIN: C20.1, C26.1, NT2.1, U4.45 (CSPIN)
/CSPOUT: C35.2, C37.1, NT4.1, U4.42 (CSPOUT)
/FBIN: C17.1, NT6.1, R17.1, R20.1, R23.1, U4.46 (VIN)
/FBOUT: NT7.1, Q5.1 (S2), R50.1, R57.2
/FBOUT_0: Q5.6 (D1), R50.2, R51.1
/RS+: Q2.1 (S), Q2.2 (S), Q2.3 (S), Q3.1 (S), Q3.2 (S), Q3.3 (S), R36.1, R38.1
/SCL: J23.1, R4.1, U4.63 (SCL)
/SDA: J22.1, R3.1, U4.61 (SDA)
/SYNC: J16.1, R2.1, U4.21 (SYNC)
/TG1: Q1.4 (G), R32.2
/TG1_0: R32.1, U4.32 (TG1)
/TG2: Q4.4 (G), U4.28 (TG2)
/V_{SW1}: C29.1, D1.1 (K), L3.1, Q1.1 (S), Q1.2 (S), Q1.3 (S), Q2.5 (D), U4.31 (SW1)
/V_{SW2}: C33.1, D2.1 (K), L3.2, Q3.5 (D), Q4.1 (S), Q4.2 (S), Q4.3 (S), U4.29 (SW2)
/~SHDN: J17.1, R23.2, R24.1, U4.11 (~SHDN)
ECON: Q6.5 (B2), R54.1, U4.48 (ECON)
EXTV_{CC}: C34.1, R44.2, R55.2, U4.40 (EXTVCC)
GATEV_{CC}: C21.2, C24.2, R7.2, U4.7 (INTVCC), U4.24 (GATEVCC)
GATEV_{CC}`: D12.2 (A), D13.2 (A), R7.1
GND: C1.1, C15.2, C16.2, C17.2, C18.2, C19.1, C20.2, C21.1, C22.2, C23.2, C24.1, C25.2, C27.2, C28.1, C30.2, C31.2, C32.1, C34.2, C36.2, C37.2, C38.2, C39.1, C40.1, C41.2, C42.2, D1.2 (A), D2.2 (A), J1.1, J2.1, J5.1, J6.1, J11.1, J12.1, J14.1, J18.1, J19.1, J21.1, NT1.1, Q6.1 (E1), R2.2, R3.2, R4.2, R6.2, R18.2, R19.2, R21.2, R22.2, R24.2, R26.2, R38.2, R40.2, R47.1, R52.2, R54.2, R56.1, U4.9 (MODE), U4.55 (GND), U4.59 (GND), U4.62 (GND), U4.65 (GND)
unnamed: C19.2, R28.1, R30.2
unnamed: C27.1, R33.1
unnamed: C40.2, R43.1, R49.2
unnamed: NT1.2, R37.2
unnamed: C25.1, NT3.2, Q1.5 (D), R27.2
unnamed: Q5.2 (G2), Q6.6 (C1), R57.1
unnamed: Q5.3 (D2), R55.1
unnamed: Q5.5 (G1), Q6.3 (C2), R58.1
unnamed: Q6.2 (B1), R53.2
unnamed: Q6.4 (E2), R56.2
unnamed: C30.1, R34.1, U4.56 (CLKDET)
unnamed: R34.2, U4.20 (CLKOUT)
unnamed: C32.2, C43.2, R37.1, U4.12 (CSN)
unnamed: C31.1, C43.1, R36.2, U4.13 (CSP)
unnamed: R17.2, R18.1, R28.2, R29.2, U4.15 (FBIN)
unnamed: R29.1, U4.1 (FBIR)
unnamed: R30.1, U4.6 (FBIW)
unnamed: R49.1, R51.2, R52.1, U4.16 (FBOUT), U4.57 (FBOR)
unnamed: R43.2, U4.5 (FBOW)
unnamed: R22.1, U4.10 (IMON_IN), U4.53 (IIR)
unnamed: C23.1, R25.2, R26.1, R31.2, U4.17 (IMON_OUT)
unnamed: R31.1, U4.64 (IOR)
unnamed: R25.1, U4.50 (IOW)
unnamed: R42.2, U4.14 (LDO33)
unnamed: R19.1, U4.22 (RT)
unnamed: C15.1, U4.19 (SS)
unnamed: C1.2, R45.1, R47.2, U4.3 (TEMPSENSE)
unnamed: C28.2, R33.2, U4.18 (VC)
unnamed: R20.2, R21.1, U4.54 (VINR)
REG_{FAULT}: J10.1, R5.2, R6.1, U4.2 (CA)
REG_{STATUS}: J25.1, U4.51 (STATUS)
SWENO: R40.1, R53.1, U4.8 (SWEN), U4.49 (SWENO)
VBATT: C41.1, C42.1, J7.1, J8.1, NT5.2, NT7.2, R46.2
VSOLAR: C16.1, C18.1, C22.1, J3.1, J4.1, NT2.2, NT6.2, R27.1
V_{DD}: C38.1, J15.1, R41.1, R42.1, U4.4 (VDD)
V_{OUT}: C36.1, NT4.2, Q4.5 (D), Q5.4 (S1), R44.1, R46.1, R58.2

Notes on the sheet:
R_{DACI1}
C_{DACO}
C_{C2}
DNI if I_{OUTMAX}=I_{OUTMAX(SO)}
Battery Disconnect
R_{IMON_IN}
Startup 5V_{min}&R_{div} achieves → 1.23V_{min}
C_{S1}
C_{S2}
Switching Freq: 124K=350kHz 365K=120kHz
Suitable Caps
R_{LIM4}
"M4"
Gate resistors reduce ringing on low cap MOSFETS.
R_{DACO2}
Si7106DN 20V 12.5A, Rdson=5.5 <- excellent SEE and TID CSD16403Q5A 25V 28A, Rdson=2.9 <- decent SEE, no TID
There are only 3 pin differences b/t 8490 and 8491: Pin 2: FAULT -> CA Pin 61: CHARGECFG1 -> SDA Pin 63: CHARGECFG2 -> SCL Four possible I2C addresses via CA pin
R_{DACI2}
R_{SENSE(BOOST)}
R_{FBIN2}
C_{C1}
R_{DACO1}
R5 R6 0x10 100K - 0x19 71.5K 110K 0x20 187K 107K 0x29 - 100K
IHLP7575GZER3R3M5A - 3.3uH 3.12mOhm, 28A, 6mm tall SRP1265WA-3R3M - 3.3uH 6mohm, 19A, 6mm SPM12565VT-3R3M-D - 3.3uH, 4.9m, 25A, 6.5mm PA4321.332NLT - 3.3uH, 10mOhm, 6A, 5.1mm SRP1770C-3R3M - 3.3uH, 3.5mOhm, 32A - 7mm XAL1010-332ME_ - 3.3uH, 3.7mOhm 27A,10x11.3x10tall SPM12565VT-3R3M-D - 3.3uH, 4.9m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
R_{SENSE1} value matters a lot. Too low and charging sucks 0.0505/0.035=1.44A max 0.0505/0.1 = 0.505A max
EXTV_{CC} Disconnect
"M2"
"M3"
R_{FBIN1}
R_{IOW}
(LT8491 only)
MOSFET Candidates
AVX TCQ - conductive polymer
C_{DACI}
"M1"
R_{FBOUT2}
Inductor Candidates:
R_{FBOUT1}
R_{SENSE2} 0.0497/0.033=1.51A
LT8490 vs LT8491
Low power if 3.01K
R_{VGS1}
I2C Address

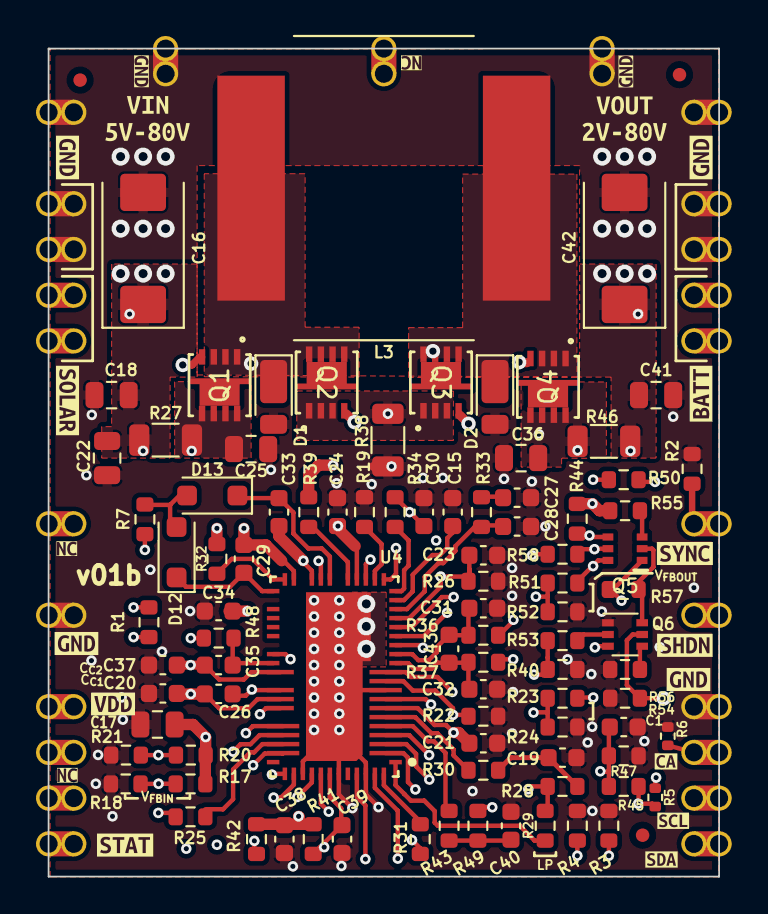
[picture p63: board LT8490.kicad_pcb from above]

Board: 6 copper layers, 37.2 x 46.0 mm, 145 parts (0 on the bottom side), 66 nets.

Other parts of the board:
Ref**: Val**; holliday
kibuzzard-62D49DAC, kibuzzard-62D49DAC#2, kibuzzard-62D49DAC#3: G***; kibuzzard-62D49DAC
kibuzzard-62D49DF0, kibuzzard-62D49DF0#2: G***; kibuzzard-62D49DF0
kibuzzard-623CC1D5, kibuzzard-623CC1D5#2, kibuzzard-623CC1D5#3, kibuzzard-623CC1D5#4: G***; kibuzzard-623CC1D5
kibuzzard-623CC1F4: G***; kibuzzard-623CC1F4
kibuzzard-623CC3F2: G***; kibuzzard-623CC3F2
kibuzzard-623CC9B2: G***; kibuzzard-623CC9B2
kibuzzard-623CC23C: G***; kibuzzard-623CC23C
kibuzzard-623CCAD0: G***; kibuzzard-623CCAD0
kibuzzard-623CCAFA: G***; kibuzzard-623CCAFA
kibuzzard-623CCB0B: G***; kibuzzard-623CCB0B
kibuzzard-623CCB15: G***; kibuzzard-623CCB15
kibuzzard-623CCD34: G***; kibuzzard-623CCD34
kibuzzard-623DE3C4: G***; kibuzzard-623DE3C4
kibuzzard-623E06E1: G***; kibuzzard-623E06E1
kibuzzard-623E06ED: G***; kibuzzard-623E06ED
kibuzzard-623E06FB: G***; kibuzzard-623E06FB
