pete4radio/SAMWISE-1-1-HW-Training/MPPT_addon_board/MPPT_addon_board.kicad_pcb

## KiCad design MPPT_addon_board/MPPT_addon_board.kicad_pcb (2024-05-09)

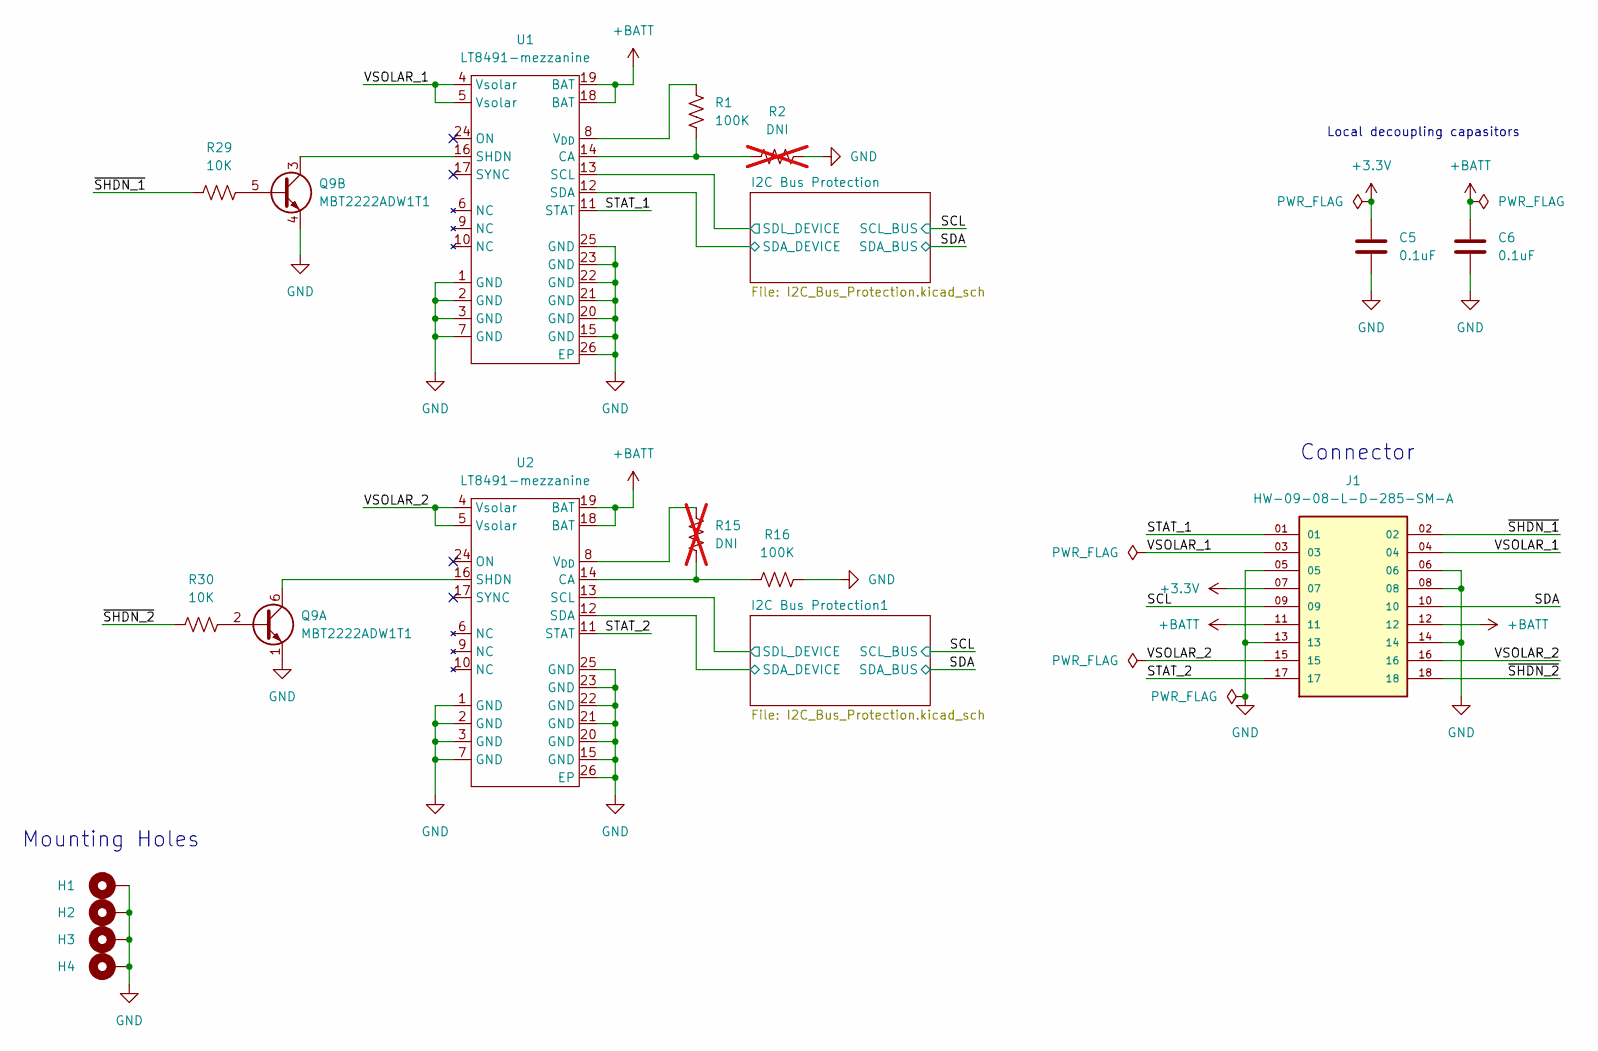
[picture p64: schematic MPPT_addon_board.kicad_sch, MPPT addon board]

Parts:
C5, C6: 0.1uF; C_0603_1608Metric
H1, H2, H3, H4: MountingHole_Pad; MountingHole_3.2mm_M3_DIN965_Pad
J1: HW-09-08-L-D-285-SM-A; SAMTEC_HW-09-XX-X-D-XXX-SM-A; PARTREV A
Q9: MBT2222ADW1T1; SOT-363_SC-70-6
R1, R16: 100K; R_0603_1608Metric
R2, R15: DNI; R_0603_1608Metric; not fitted
R29, R30: 10K; R_0603_1608Metric
U1, U2: LT8491-mezzanine

Connections:
+3.3V: C5.1, J1.07; also elsewhere on the board
+BATT: C6.1, J1.11, J1.12, U1.18 (BAT), U1.19 (BAT), U2.18 (BAT), U2.19 (BAT)
/I2C Bus Protection1/SDA_DEVICE: U2.12 (SDA); also elsewhere on the board
/I2C Bus Protection1/SDL_DEVICE: U2.13 (SCL); also elsewhere on the board
/I2C Bus Protection/SDA_DEVICE: U1.12 (SDA); also elsewhere on the board
/I2C Bus Protection/SDL_DEVICE: U1.13 (SCL); also elsewhere on the board
/SCL: J1.09; also elsewhere on the board
/SDA: J1.10; also elsewhere on the board
/STAT_1: J1.01, U1.11 (STAT)
/STAT_2: J1.17, U2.11 (STAT)
/VSOLAR_1: J1.03, J1.04, U1.4 (Vsolar), U1.5 (Vsolar)
/VSOLAR_2: J1.15, J1.16, U2.4 (Vsolar), U2.5 (Vsolar)
/~SHDN_1: J1.02, R29.1
/~SHDN_2: J1.18, R30.1
GND: C5.2, C6.2, H1.1, H2.1, H3.1, H4.1, J1.05, J1.06, J1.08, J1.13, J1.14, Q9.1 (E1), Q9.4 (E2), R2.2, R16.2, U1.1 (GND), U1.2 (GND), U1.3 (GND), U1.7 (GND), U1.15 (GND), U1.20 (GND), U1.21 (GND), U1.22 (GND), U1.23 (GND), U1.25 (GND), U1.26 (EP), U2.1 (GND), U2.2 (GND), U2.3 (GND), U2.7 (GND), U2.15 (GND), U2.20 (GND), U2.21 (GND), U2.22 (GND), U2.23 (GND), U2.25 (GND), U2.26 (EP); also elsewhere on the board
unnamed: Q9.2 (B1), R30.2
unnamed: Q9.6 (C1), U2.16 (SHDN)
unnamed: Q9.5 (B2), R29.2
unnamed: Q9.3 (C2), U1.16 (SHDN)
unnamed: R1.2, R2.1, U1.14 (CA)
unnamed: R1.1, U1.8 (V_{DD})
unnamed: R15.2, R16.1, U2.14 (CA)
unnamed: R15.1, U2.8 (V_{DD})

Notes on the sheet:
Connector
Local decoupling capasitors
Mounting Holes

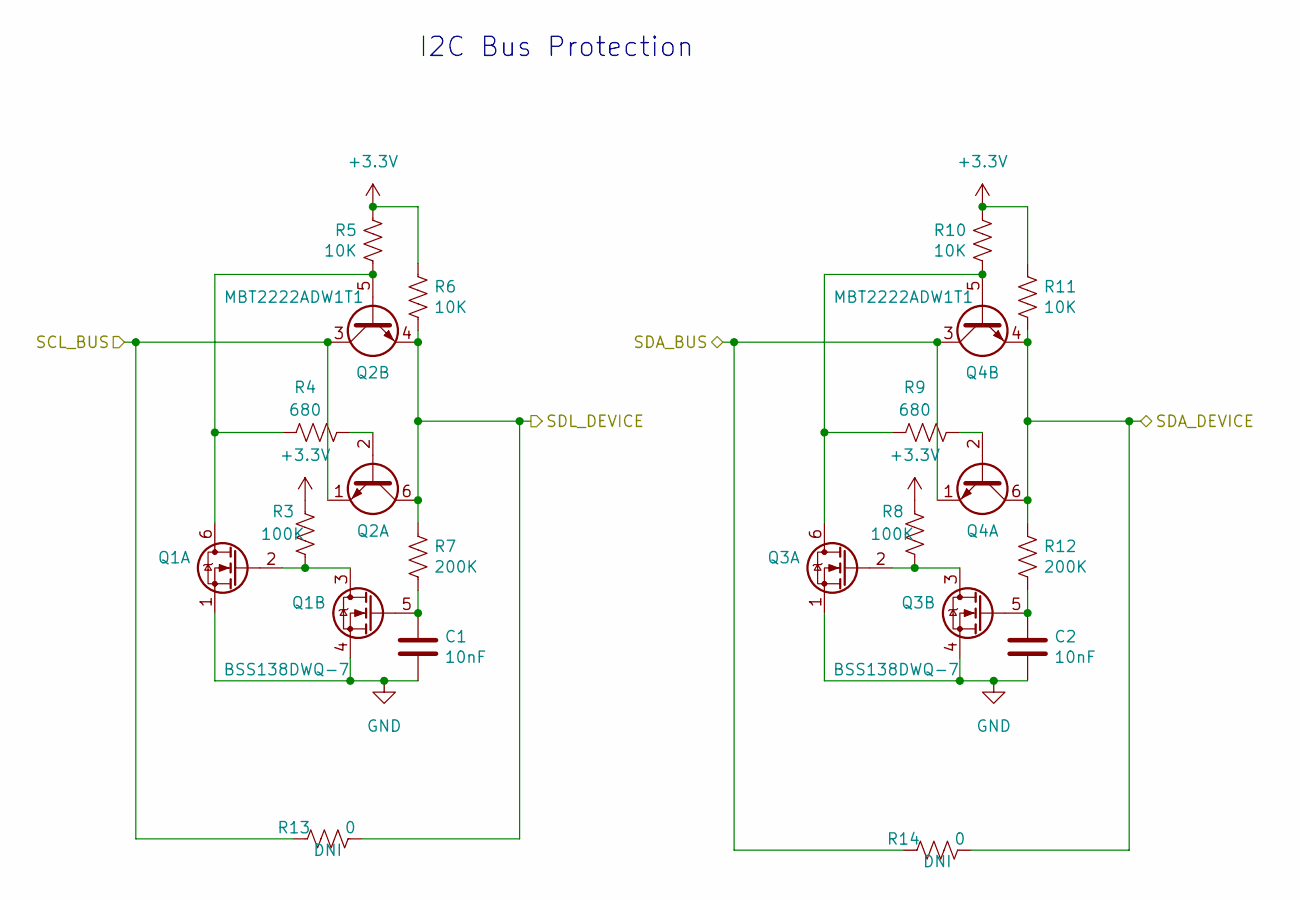
[picture p65: schematic I2C_Bus_Protection.kicad_sch, MPPT addon board]

Parts:
C1, C2: 10nF; C_0603_1608Metric
Q1, Q3: BSS138DWQ-7; Manufacturer_Part_Number BSS138DWQ-7; Mouser Part Number 621-BSS138DWQ-7
Q2, Q4: MBT2222ADW1T1; SOT-363_SC-70-6; Manufacturer_Part_Number MBT2222ADW1T1G
R3, R8: 100K; R_0603_1608Metric
R4, R9: 680; R_0603_1608Metric
R5, R6, R10, R11: 10K; R_0603_1608Metric
R7, R12: 200K; R_0603_1608Metric
R13, R14: 0; R_0603_1608Metric

Connections:
+3.3V: R3.1, R5.1, R6.1, R8.1, R10.1, R11.1; also elsewhere on the board
/I2C Bus Protection/SDA_DEVICE: Q4.4 (E2), Q4.6 (C1), R11.2, R12.1, R14.1; also elsewhere on the board
/I2C Bus Protection/SDL_DEVICE: Q2.4 (E2), Q2.6 (C1), R6.2, R7.1, R13.1; also elsewhere on the board
/SCL: Q2.1 (E1), Q2.3 (C2), R13.2; also elsewhere on the board
/SDA: Q4.1 (E1), Q4.3 (C2), R14.2; also elsewhere on the board
GND: C1.2, C2.2, Q1.1 (S2), Q1.4 (S1), Q3.1 (S2), Q3.4 (S1); also elsewhere on the board
unnamed: Q1.6 (D1), Q2.5 (B2), R4.2, R5.2
unnamed: Q1.2 (G2), Q1.3 (D2), R3.2
unnamed: C1.1, Q1.5 (G1), R7.2
unnamed: Q2.2 (B1), R4.1
unnamed: Q3.6 (D1), Q4.5 (B2), R9.2, R10.2
unnamed: Q3.2 (G2), Q3.3 (D2), R8.2
unnamed: C2.1, Q3.5 (G1), R12.2
unnamed: Q4.2 (B1), R9.1

Parts of its further copies:
C3, C4: 10nF; C_0603_1608Metric
Q5, Q7: BSS138DWQ-7; Manufacturer_Part_Number BSS138DWQ-7; Mouser Part Number 621-BSS138DWQ-7
Q6, Q8: MBT2222ADW1T1; SOT-363_SC-70-6; Manufacturer_Part_Number MBT2222ADW1T1G
R17, R23: 100K; R_0603_1608Metric
R18, R24: 680; R_0603_1608Metric
R19, R25: 0; R_0603_1608Metric
R20, R21, R26, R27: 10K; R_0603_1608Metric
R22, R28: 200K; R_0603_1608Metric

Connections of its further copies:
+3.3V: R17.1, R20.1, R21.1, R23.1, R26.1, R27.1; also elsewhere on the board
/I2C Bus Protection1/SDA_DEVICE: Q8.4 (E2), Q8.6 (C1), R25.1, R27.2, R28.1; also elsewhere on the board
/I2C Bus Protection1/SDL_DEVICE: Q6.4 (E2), Q6.6 (C1), R19.1, R21.2, R22.1; also elsewhere on the board
/SCL: Q6.1 (E1), Q6.3 (C2), R19.2; also elsewhere on the board
/SDA: Q8.1 (E1), Q8.3 (C2), R25.2; also elsewhere on the board
GND: C3.2, C4.2, Q5.1 (S2), Q5.4 (S1), Q7.1 (S2), Q7.4 (S1); also elsewhere on the board
unnamed: Q5.6 (D1), Q6.5 (B2), R18.2, R20.2
unnamed: Q5.2 (G2), Q5.3 (D2), R17.2
unnamed: C3.1, Q5.5 (G1), R22.2
unnamed: Q6.2 (B1), R18.1
unnamed: Q7.6 (D1), Q8.5 (B2), R24.2, R26.2
unnamed: Q7.2 (G2), Q7.3 (D2), R23.2
unnamed: C4.1, Q7.5 (G1), R28.2
unnamed: Q8.2 (B1), R24.1

Notes on the sheet:
I2C Bus Protection
