pete4radio/SAMWISE-1-1-HW-Training/MPPT_addon_board/MPPT_addon_board.kicad_pcb

## KiCad design MPPT_addon_board/MPPT_addon_board.kicad_pcb (continued)

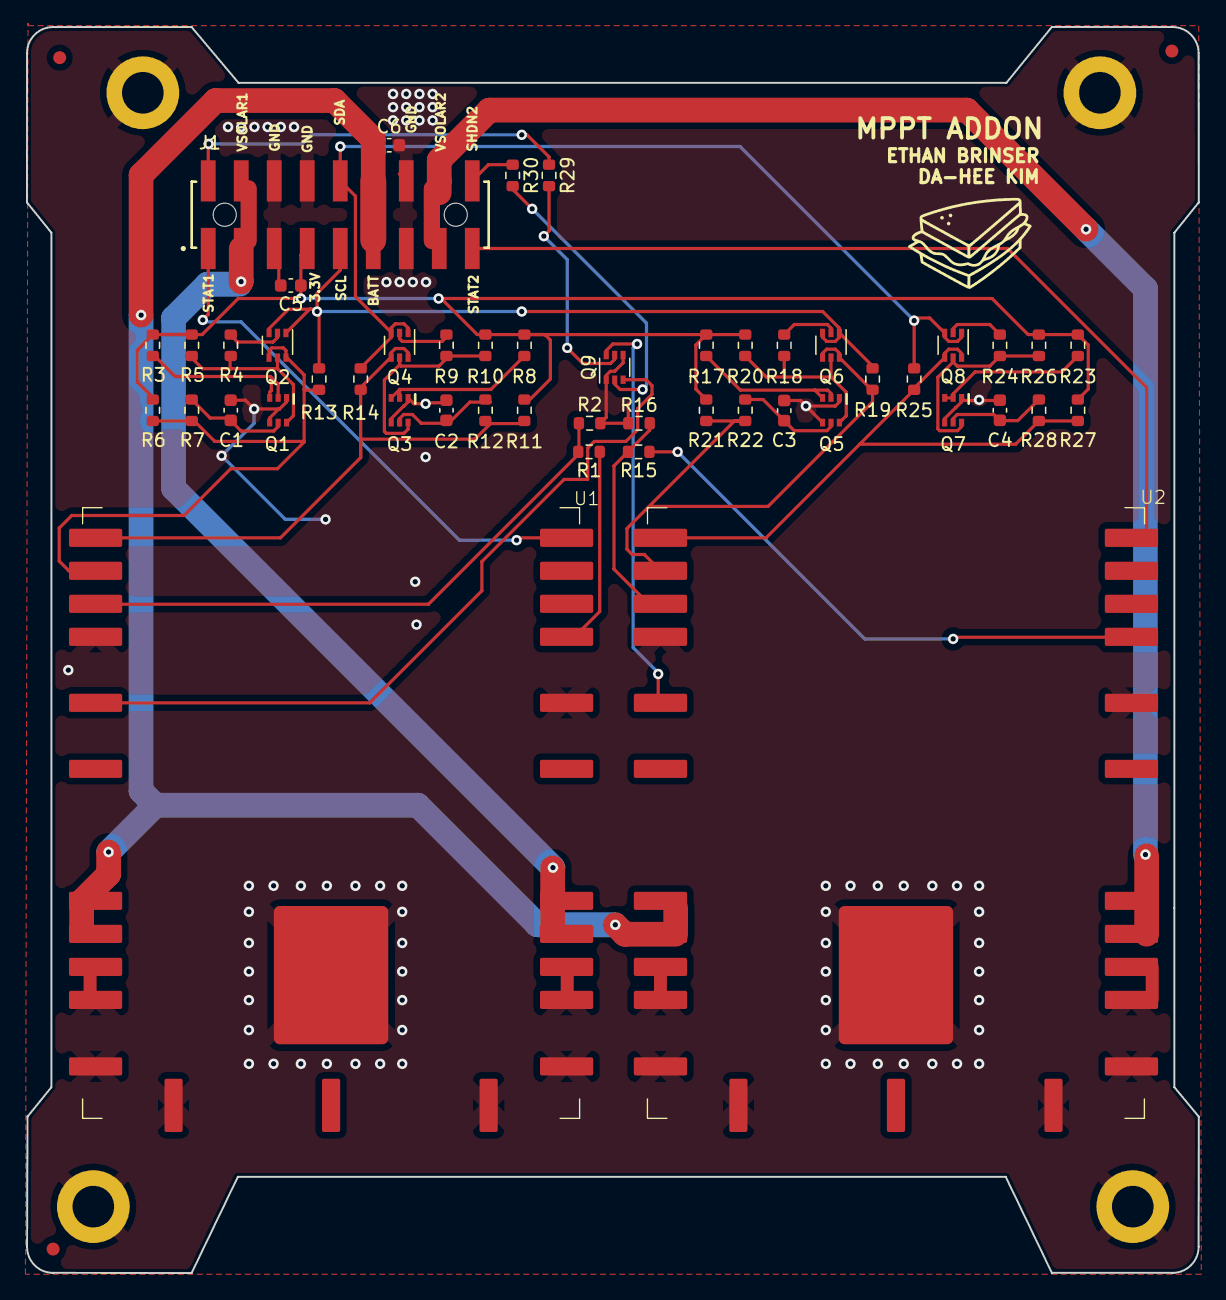
[picture p66: board MPPT_addon_board.kicad_pcb from above]

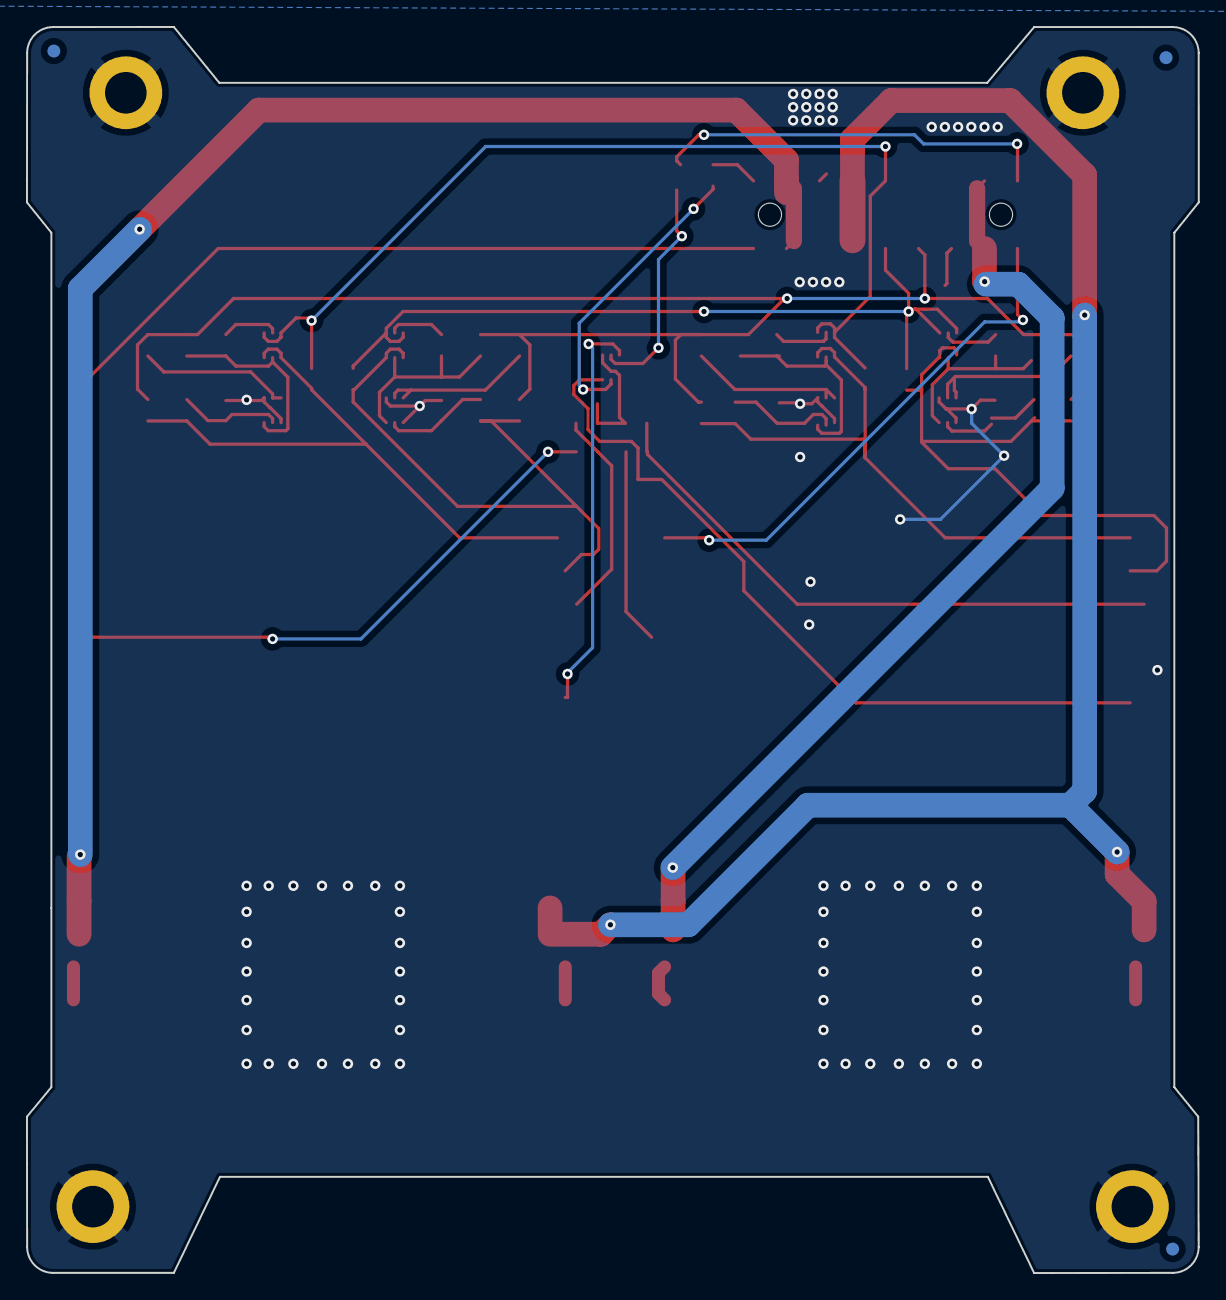
[picture p67: board MPPT_addon_board.kicad_pcb from below]

Board: 2 copper layers, 90.2 x 95.9 mm, 58 parts (3 on the bottom side), 39 nets.

Other parts of the board:
REF1B, REF1T, REF2B, REF2T, REF3B, REF3T: Fiducial_1mm_Mask2mm
