pete4radio/SAMWISE-1-1-HW-Training/Ground Station Hat/Groundstation_Hat.kicad_pcb

## KiCad design Ground Station Hat/Groundstation_Hat.kicad_pcb (2024-05-09)

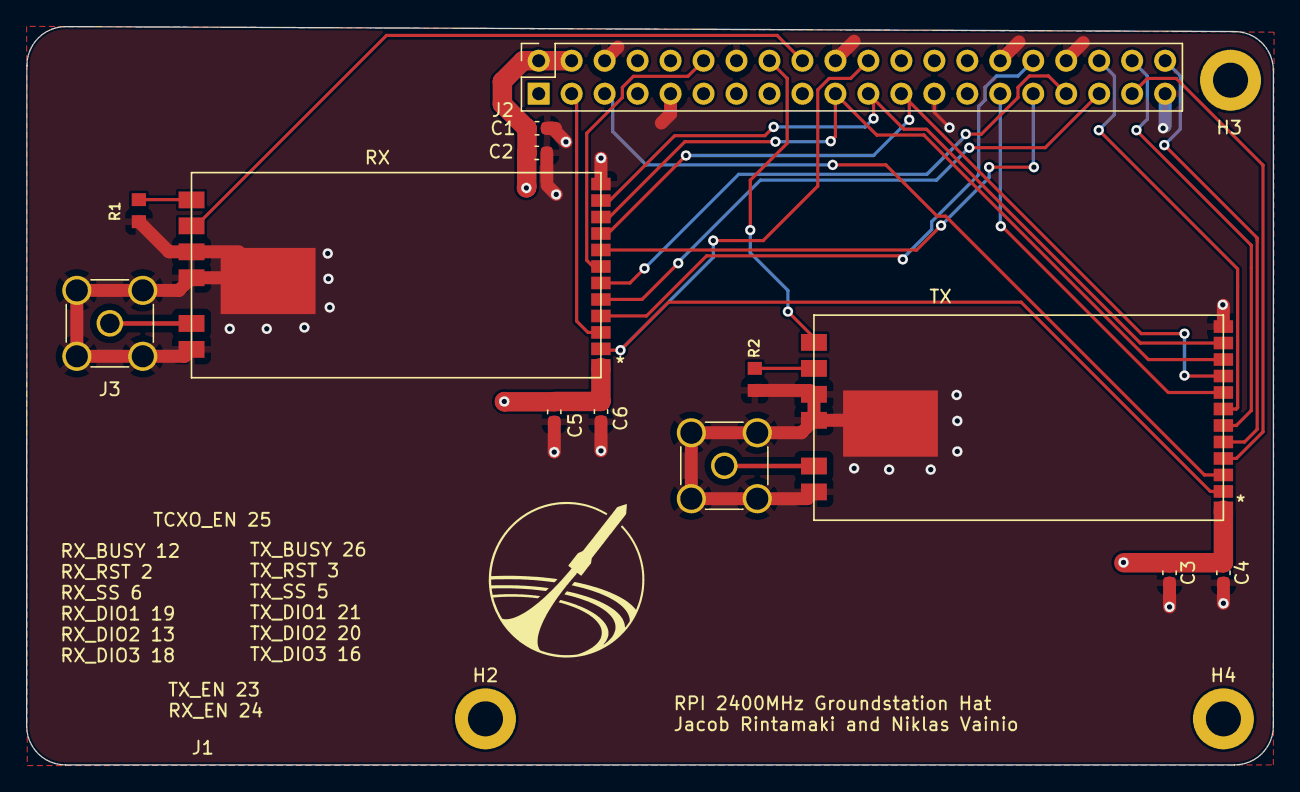
[picture p68: board Groundstation_Hat.kicad_pcb from above]

Board: 4 copper layers, 96.1 x 56.9 mm, 16 parts (0 on the bottom side), 24 nets.

Parts:
C1, C3, C5: 10uF; C_0603_1608Metric
C2, C4, C6: 0.1uF; C_0603_1608Metric
H2, H3, H4: MountingHole; MountingHole_2.7mm_M2.5_DIN965_Pad
J1, J3: Amphenol_901-144; SMA_901-144
J2: PRT-21570
R1, R2: 10KOHM-1_10W-1%(0603)0603; R0603
U1, U2: LoRa1280F27-TCXO; LORA128XF27

Connections:
+5V: C1.1, C2.1, C3.1, C4.1, C5.1, C6.1, J2.2, J2.4, U1.1 (VCC), U2.1 (VCC)
GND: C1.2, C2.2, C3.2, C4.2, C5.2, C6.2, J1.2 (Ext), J2.6, J2.9, J2.14, J2.20, J2.25, J2.30, J2.34, J2.39, J3.2 (Ext), R1.1, R2.1, U1.12 (GND), U1.15 (GND), U1.16 (GND), U1.18 (GND), U1.19 (GND), U2.12 (GND), U2.15 (GND), U2.16 (GND), U2.18 (GND), U2.19 (GND)
MISO: J2.21, U1.11 (MISO), U2.11 (MISO)
MOSI: J2.19, U1.10 (MOSI), U2.10 (MOSI)
unnamed: J1.1 (In), U2.17 (ANT)
unnamed: J3.1 (In), U1.17 (ANT)
unnamed: R1.2, U1.13 (TXEN)
unnamed: R2.2, U2.14 (RXEN)
RF_IO1: J2.40, U2.5 (DIO1)
RF_IO2: J2.38, U2.6 (DIO2)
RF_IO3: J2.36, U2.7 (DIO3)
RF_IO4: J2.35, U1.5 (DIO1)
RF_IO5: J2.33, U1.6 (DIO2)
RF_IO6: J2.12, U1.7 (DIO3)
RF_RX_EN: J2.18, U1.14 (RXEN)
RF_TX_EN: J2.16, U2.13 (TXEN)
RX_BUSY: J2.32, U1.4 (BUSY)
RX_CS: J2.31, U1.8 (NSS)
RX_RST: J2.3, U1.3 (NRESET)
SCLK: J2.23, U1.9 (SCK), U2.9 (SCK)
TCXO_EN: J2.22, U1.2 (TCXOEN), U2.2 (TCXOEN)
TX_BUSY: J2.37, U2.4 (BUSY)
TX_CS: J2.29, U2.8 (NSS)
TX_RST: J2.5, U2.3 (NRESET)
