pete4radio/SAMWISE-1-1-HW-Training/batteryboard-v02b/batteryboard.kicad_pcb

## KiCad design batteryboard-v02b/batteryboard.kicad_pcb (2024-05-09)

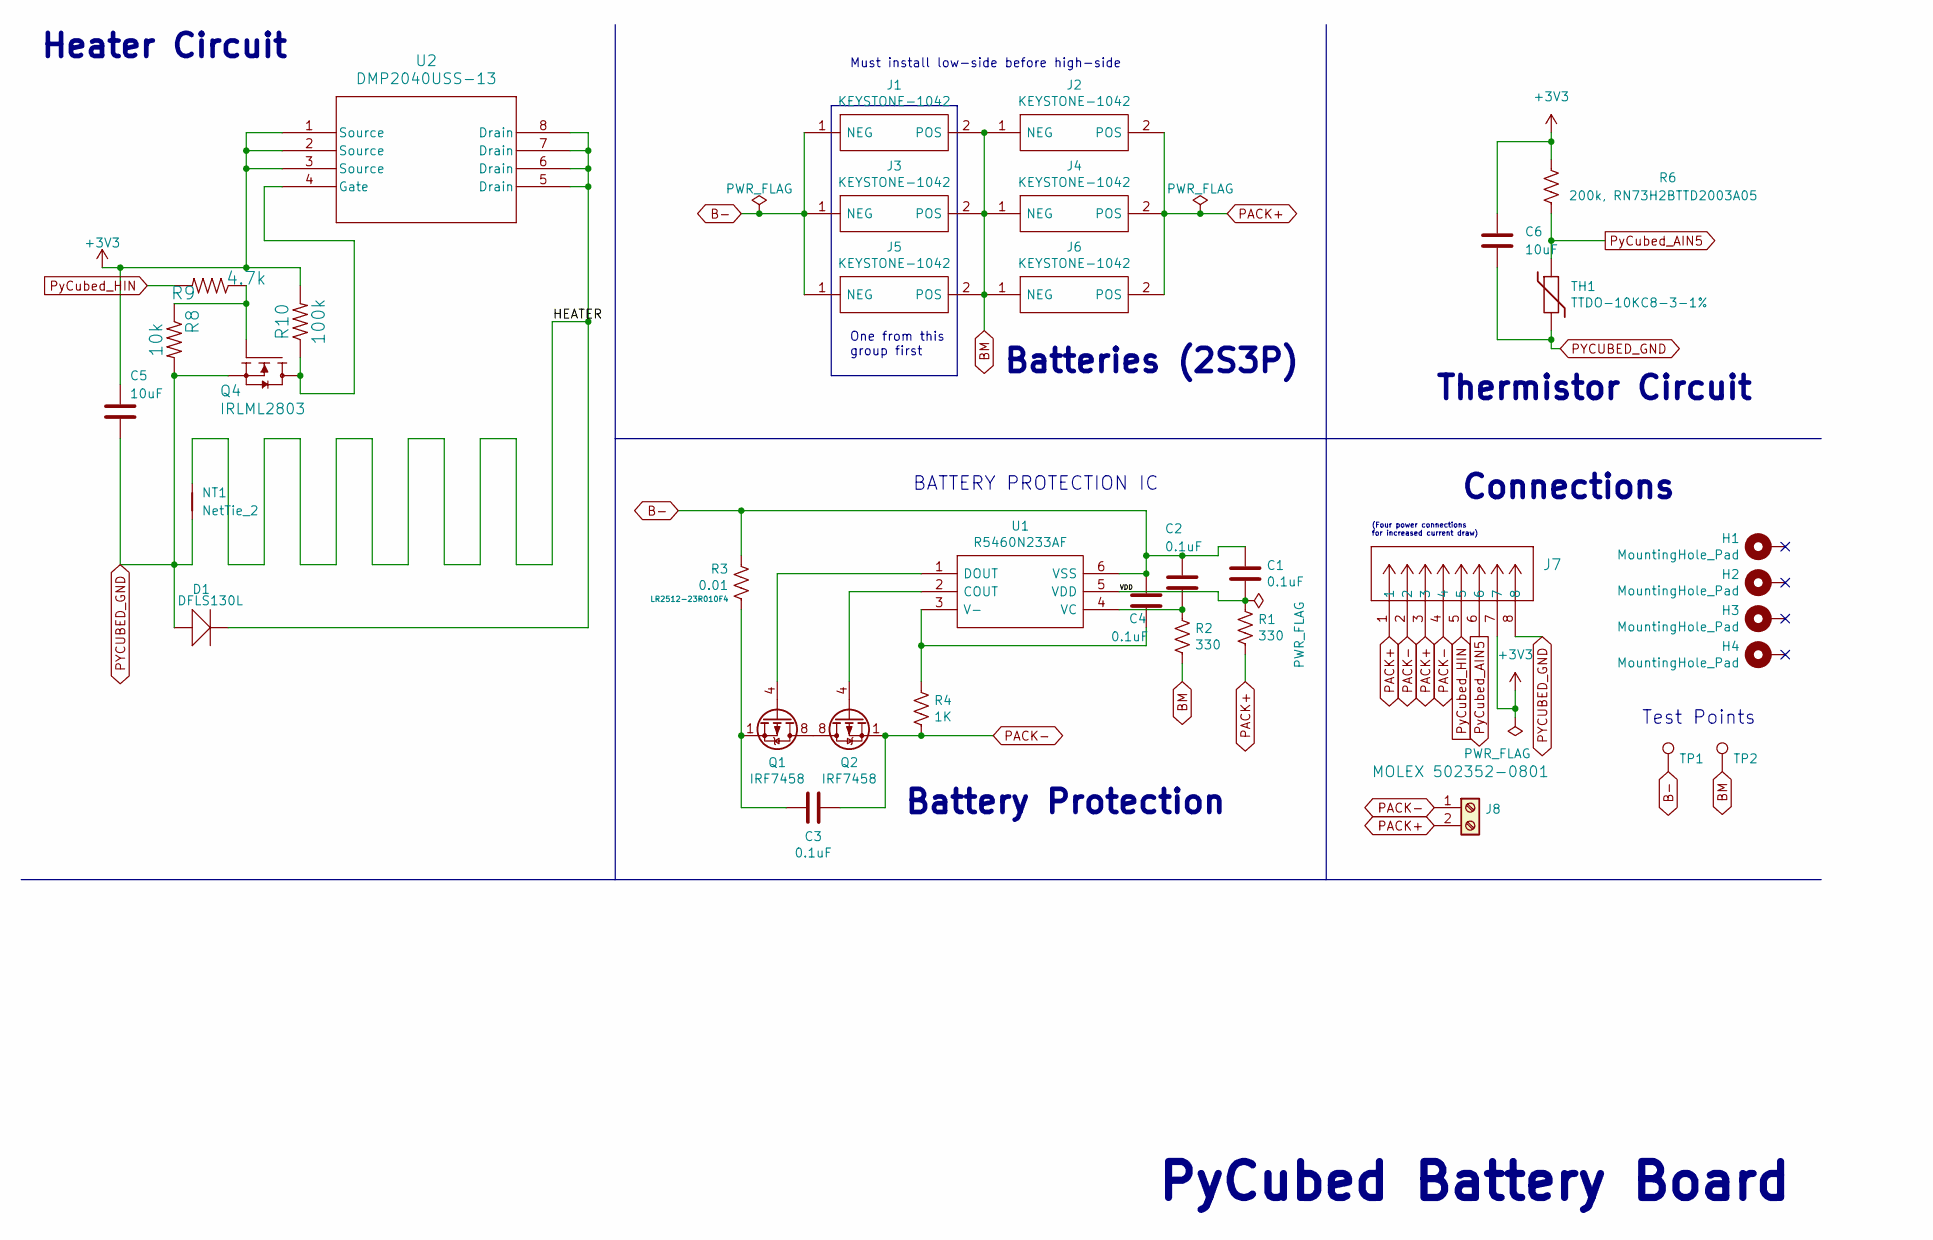
[picture p69: schematic batteryboard.kicad_sch, PyCubed Battery Board]

Parts:
C1, C2, C3, C4: 0.1uF; C_0603_1608Metric
C5, C6: 10uF; C_0603_1608Metric
D1: DFLS130L; PWRDI-123
H1, H2, H3, H4: MountingHole_Pad; MountingHole_3.2mm_M3_DIN965_PadMOD
J1, J2, J3, J4, J5, J6: KEYSTONE-1042; Keystone_1042; Manufacturer_Part_Number 1042; Mouser Part Number 534-1042
J7: MOLEX 502352-0801; CONN_502352-0801_MOL
J8: Screw_Terminal_01x02; pheonix_2pos_screwterminal
NT1: NetTie_2; NetTie-2_SMD_Pad0.5mm
Q1, Q2: IRF7458; SOIC-8_3.9x4.9mm_P1.27mm
Q4: IRLML2803; SOT-23; Manufacturer_Part_Number MMBT2222AT
R1, R2: 330; R_0603_1608Metric
R3: 0.01; R_2512_6332Metric
R4: 1K; R_0603_1608Metric; Manufacturer_Part_Number LR2512-23R010F4
R6: 200k, RN73H2BTTD2003A05; R_1206_3216Metric
R8: 10k; R_0603_1608Metric
R9: 4.7k; R_0603_1608Metric
R10: 100k; R_0603_1608Metric
TH1: TTDO-10KC8-3-1%; R_Axial_DIN0204_L3.6mm_D1.6mm_P5.08mm_Horizontal
TP1, TP2: TestPoint; TestPoint_Loop_D1.80mm_Drill1.0mm_Beaded
U1: R5460N233AF; SOT-23-6; Manufacturer_Part_Number R5460N233AF-TR-FE; Mouser Part Number 848-R5460N233AFTRFE
U2: DMP2040USS-13; SOIC_2LSS-13_DIO

Connections:
+3V3: C5.1, C6.1, J7.7, R6.1, R10.2, U2.1 (Source), U2.2 (Source), U2.3 (Source)
/HEATER: D1.C, NT1.2, U2.5 (Drain), U2.6 (Drain), U2.7 (Drain), U2.8 (Drain)
/VDD: C1.2, R1.2, U1.5 (VDD)
B-: C1.1, C2.1, C4.1, J1.1 (NEG), J3.1 (NEG), J5.1 (NEG), R3.1, TP1.1, U1.6 (VSS)
BM: J1.2 (POS), J2.1 (NEG), J3.2 (POS), J4.1 (NEG), J5.2 (POS), J6.1 (NEG), R2.1, TP2.1
unnamed: C3.1, Q1.1 (S), Q1.2 (S), Q1.3 (S), R3.2
unnamed: Q1.5 (D), Q1.6 (D), Q1.7 (D), Q1.8 (D), Q2.5 (D), Q2.6 (D), Q2.7 (D), Q2.8 (D)
unnamed: Q1.4 (G), U1.1 (DOUT)
unnamed: Q2.4 (G), U1.2 (COUT)
unnamed: Q4.3 (D), R10.1, U2.4 (Gate)
unnamed: Q4.1 (G), R8.1, R9.1
unnamed: C4.2, R4.1, U1.3 (V-)
unnamed: C2.2, R2.2, U1.4 (VC)
PACK+: J2.2 (POS), J4.2 (POS), J6.2 (POS), J7.1, J7.3, J8.2, R1.1
PACK-: C3.2, J7.2, J7.4, J8.1, Q2.1 (S), Q2.2 (S), Q2.3 (S), R4.2
PYCUBED_GND: C5.2, C6.2, D1.A, J7.8, NT1.1, Q4.2 (S), R8.2, TH1.2
PyCubed_AIN5: J7.6, R6.2, TH1.1
PyCubed_HIN: J7.5, R9.2

Notes on the sheet:
Connections
(Four power connections for increased current draw)
One from this group first
PyCubed Battery Board
Batteries (2S3P)
Heater Circuit
Test Points
Battery Protection
Must install low-side before high-side
Thermistor Circuit
BATTERY PROTECTION IC

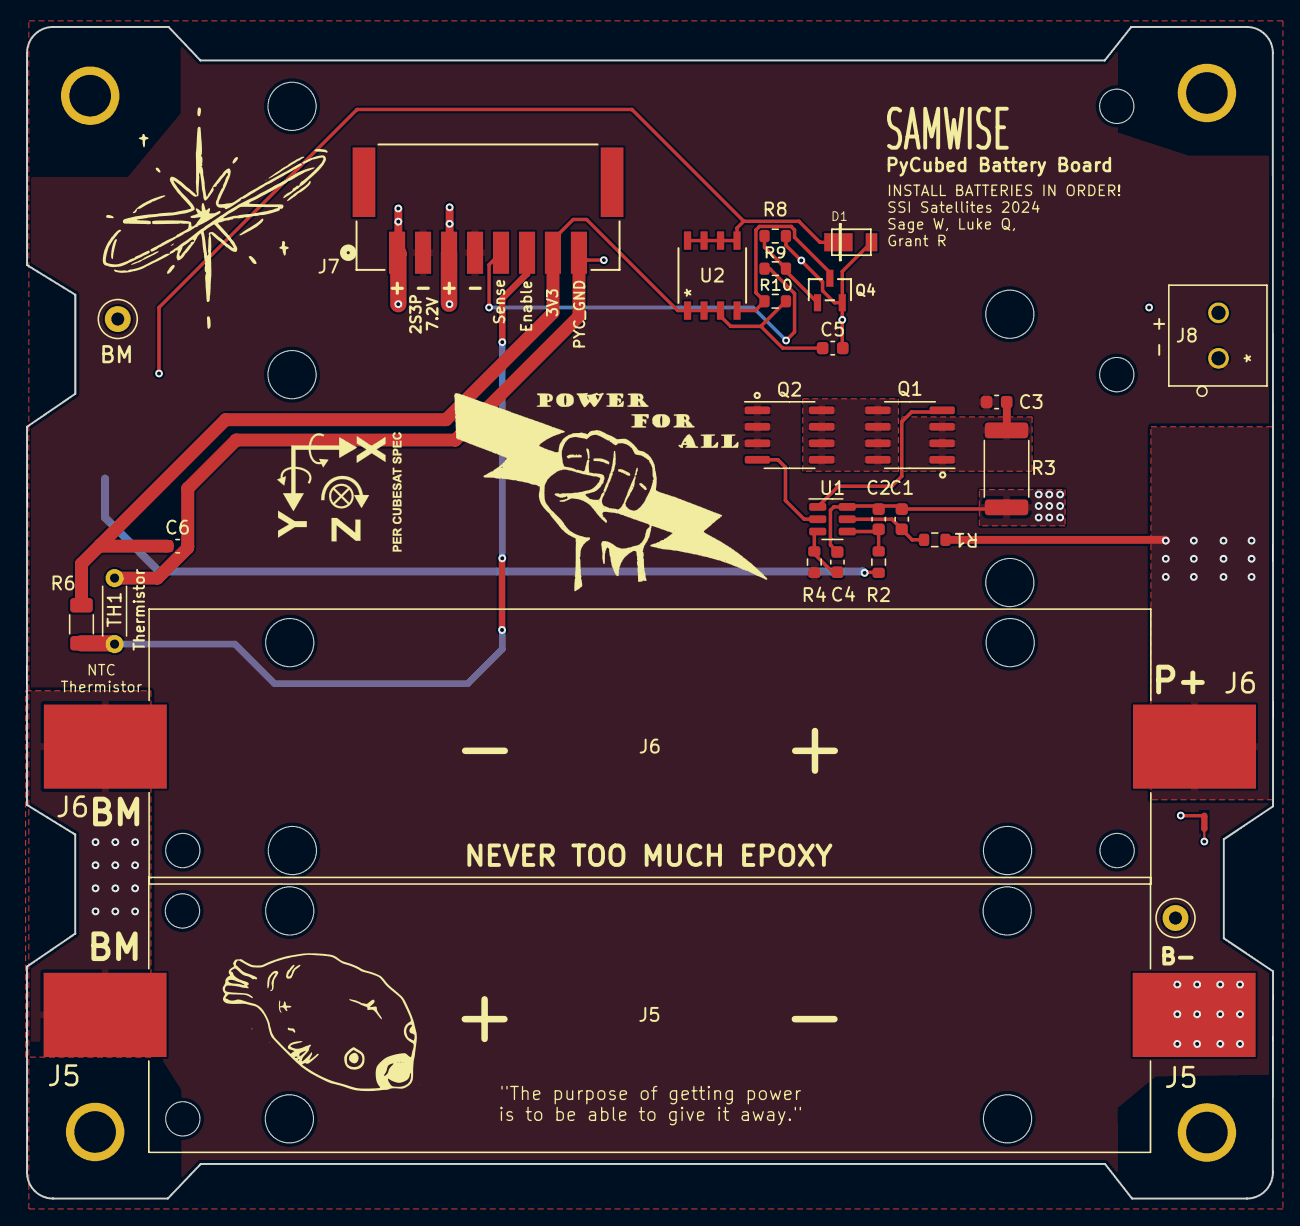
[picture p70: board batteryboard.kicad_pcb from above]

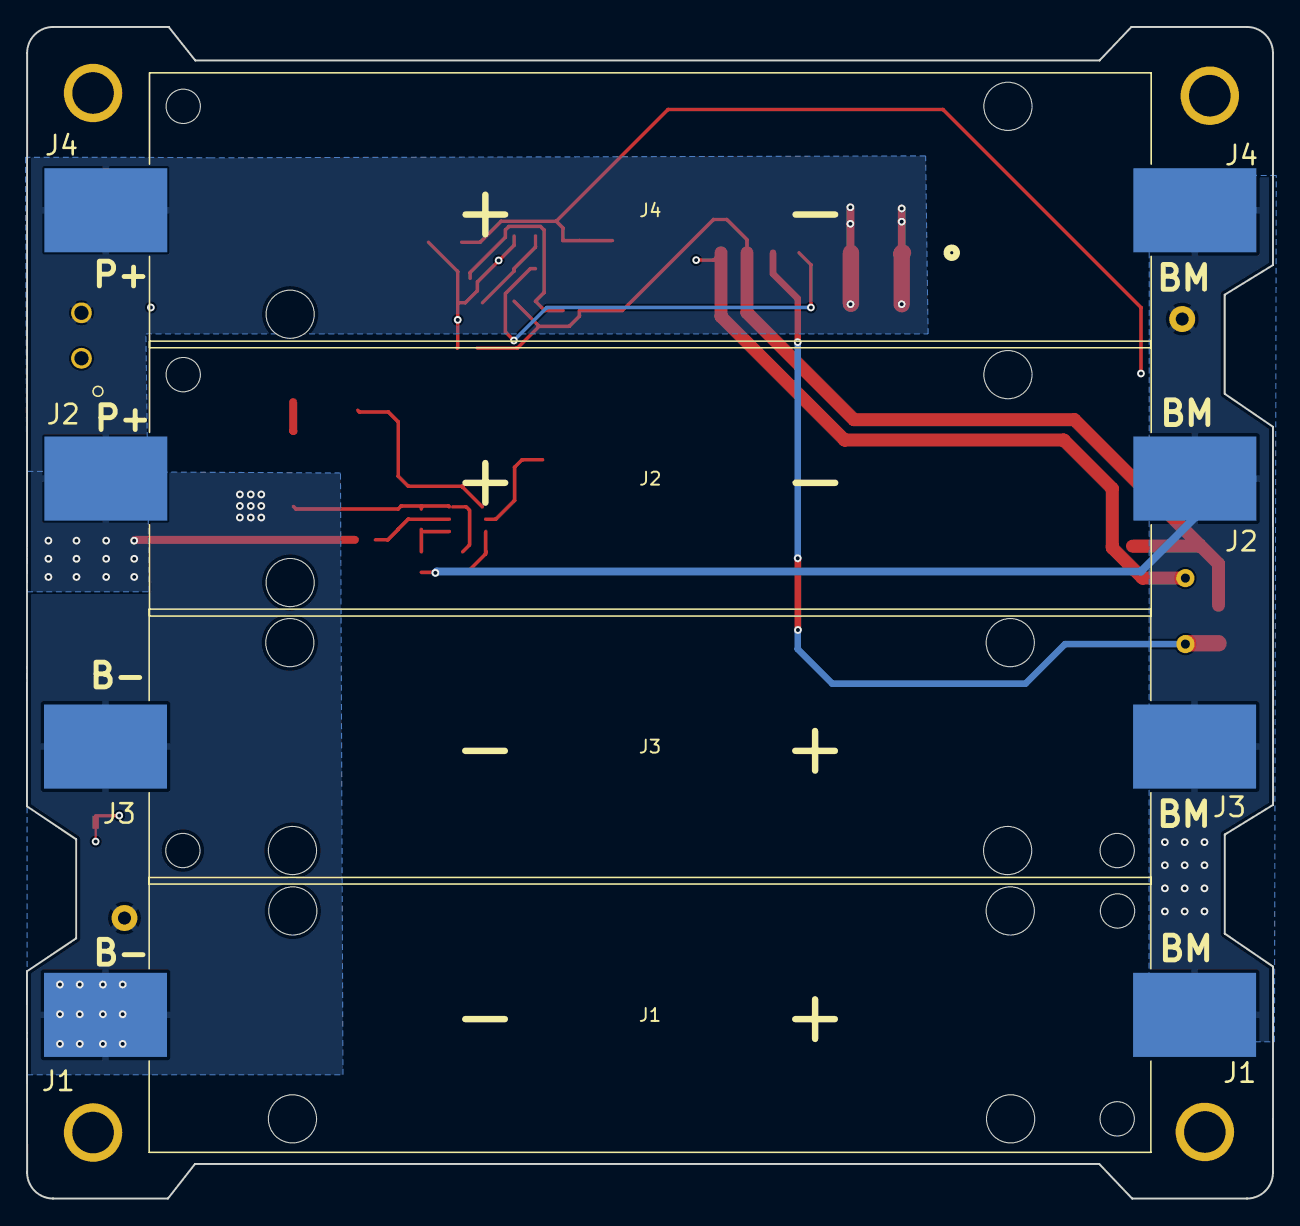
[picture p71: board batteryboard.kicad_pcb from below]

Board: 4 copper layers, 95.9 x 90.2 mm, 38 parts (5 on the bottom side), 18 nets.

Other parts of the board:
Ref**: Val**; PowerLogo
Ref**#2: Val**; XYZ_cubesat-bot
