pete4radio/SAMWISE-1-1-HW-Training/(commit log)

2024-05-09 Initial load after orders placed
    [18650 battery.STEP, 1985807.step, 2053380002.step, 2053380006.step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]
2024-05-15 Updated pycubed
    pycubed changes as a result of several design reviews were sent off for fab 14-May. To quote from Slack the Pycubed has been ordered!! :tada::tada::party-parrot: :party_cat: the Pycubed is the shire (green) :potted_plant:, the surrounding white boards are the clouds :cloud:, the solar panels are the brandywine :wine_glass:, and the harnesses are Gandalf’s fireworks :fireworks: - Hunter and Ethan
    [Avionics.kicad_sch, Burn_Wires.kicad_sch, Bus_Protection.kicad_sch, Connectors.kicad_sch, Power.kicad_sch, RF_and_GPS.kicad_sch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]
