pete4radio/SAMWISE-1-1-HW-Training/(notices)

Notices in the files:
parts and their libraries:
Copyright 2016 Accelerated Designs. All rights reserved.
Copyright 2021 Accelerated Designs. All rights reserved.
